MekhyW/PLFM_RADAR/4_Schematics and Boards Layout/4_7_Production Files/Gerber_PowerBoard/BOM_Power_Board.xlsx

Qty | Value | Device | Package | Parts | Description | MANUFACTURER_PART_NUMBER
1 |  | AK300/2 | AK300/2 | X1 | CONNECTOR | AK300/2
1 |  | MA10-2 | MA10-2 | SV1 | PIN HEADER | MA10-2
21 | 0.1µF | C-EUC0805 | C0805 | C1, C6, C12, C18, C29, C30, C36, C42, C54, C60, C66, C71, C76, C77, C83, C89, C109, C119, C129, C144, C154 | CAPACITOR, European symbol | GCM21BR71E104JA37L (https://eu.mouser.com/ProductDetail/Murata-Electronics/GCM21BR71E104JA37L?qs=ui%252B2d9lVEI7OYh7A7OY47Q%3D%3D)
27 | 10k | R-EU_M0805 | M0805 | R2, R4, R6, R8, R10, R12, R14, R16, R18, R20, R22, R24, R26, R28, R30, R32, R34, R36, R38, R40, R42, R44, R46, R48, R50, R52, R56 | RESISTOR, European symbol | AE0805BR-0710KL (https://eu.mouser.com/ProductDetail/YAGEO/AE0805BR-0710KL?qs=HMhDvBYWqvNWZaFpSGlhYw%3D%3D)
4 | 10nF | C-EUC0603 | C0603 | C150, C152, C160, C162 | CAPACITOR, European symbol | 06035D103JAT2A (https://eu.mouser.com/ProductDetail/KYOCERA-AVX/06035D103JAT2A?qs=55YtniHzbhDXOi8Vip1enw%3D%3D)
4 | 10µF | C-EUC0603 | C0603 | C151, C153, C161, C163 | CAPACITOR, European symbol | ZRB18AR6YA106ME01L (https://eu.mouser.com/ProductDetail/Murata-Electronics/ZRB18AR6YA106ME01L?qs=HoCaDK9Nz5eXg14MFgF2fw%3D%3D)
60 | 10µF | C-EUC0805 | C0805 | C4, C5, C9, C10, C15, C16, C21, C22, C24, C25, C28, C33, C34, C39, C40, C45, C46, C50, C51, C52, C53, C57, C58, C63, C64, C69, C70, C74, C75, C80, C81, C86, C87, C92, C93, C94, C95, C108, C112, C113, C114, C115, C118, C122, C123, C124, C125, C128, C132, C133, C134, C135, C138, C139, C140, C143, C147, C148, C157, C158 | CAPACITOR, European symbol | CC0805KFX5R8BB106 (https://eu.mouser.com/ProductDetail/YAGEO/CC0805KFX5R8BB106?qs=mzRxyRlhVduJfxImRDJQ%2FQ%3D%3D)
2 | 11.5k | R-EU_M0805 | M0805 | R54, R58 | RESISTOR, European symbol | CRCW080511K5FKTA (https://eu.mouser.com/ProductDetail/Vishay/CRCW080511K5FKTA?qs=tnDSmmR1oWgs354ZXqAXNQ%3D%3D)
4 | 12k | R-EU_M0805 | M0805 | R9, R35, R43, R47 | RESISTOR, European symbol | KTR10EZPF1202 (https://eu.mouser.com/ProductDetail/ROHM-Semiconductor/KTR10EZPF1202?qs=493kPxzlxfLm5xyfyaG22Q%3D%3D)
1 | 13.7k | R-EU_M0805 | M0805 | R3 | RESISTOR, European symbol | ESR10EZPF1372 (https://eu.mouser.com/ProductDetail/ROHM-Semiconductor/ESR10EZPF1372?qs=493kPxzlxfKltSq0m%2FX8Jg%3D%3D)
12 | 1µF | C-EUC0805 | C0805 | C26, C27, C106, C107, C116, C117, C126, C127, C136, C137, C141, C142 | CAPACITOR, European symbol | MSAYG21GSLD105KTNA01 (https://eu.mouser.com/ProductDetail/TAIYO-YUDEN/MSAYG21GSLD105KTNA01?qs=tlsG%2FOw5FFjivBHbIoLkxA%3D%3D)
2 | 2.2µH | POWER_INDUCTOR | IND_VLP8040T-1R0N_TDK | U$1, U$2 |  | DEM8045Z-2R2N=P3 (https://eu.mouser.com/ProductDetail/Murata-Electronics/DEM8045Z-2R2N%3dP3?qs=d0WKAl%252BL4KZ0uPLVslJ79g%3D%3D)
35 | 22-23-2021 | 22-23-2021 | 22-23-2021 | X2, X3, X4, X5, X6, X7, X8, X9, X10, X11, X12, X13, X14, X15, X16, X17, X18, X19, X20, X21, X22, X23, X24, X25, X26, X27, X28, X29, X30, X31, X32, X33, X34, X35, X36 | .100 (2.54mm) Center Header - 2 Pin" | 22-23-2021
52 | 22µF | C-EUC0603 | C0603 | C2, C3, C7, C8, C11, C13, C14, C17, C19, C20, C23, C31, C32, C35, C37, C38, C41, C43, C44, C47, C48, C49, C55, C56, C59, C61, C62, C65, C67, C68, C72, C73, C78, C79, C82, C84, C85, C88, C90, C91, C110, C111, C120, C121, C130, C131, C145, C146, C149, C155, C156, C159 | CAPACITOR, European symbol | KGM15CR51E226MT (https://eu.mouser.com/ProductDetail/KYOCERA-AVX/KGM15CR51E226MT?qs=wT7LY0lnAe2Bb%252BluevEM%252Bg%3D%3D)
1 | 23.4k | R-EU_M0805 | M0805 | R49 | RESISTOR, European symbol | RK73H2ATTD2372F (https://eu.mouser.com/ProductDetail/KOA-Speer/RK73H2ATTD2372F?qs=PMDQ8V2gf3A6mpnfapEXEA%3D%3D) | 23.7k
1 | 2k | R-EU_M0805 | M0805 | R39 | RESISTOR, European symbol | ERJ-P06D2001V (https://eu.mouser.com/ProductDetail/Panasonic/ERJ-P06D2001V?qs=sWbhZyXmMVevNgsEVw3FiQ%3D%3D)
1 | 3.09k | R-EU_M0805 | M0805 | R1 | RESISTOR, European symbol | ERJ-P06F3091V (https://eu.mouser.com/ProductDetail/Panasonic/ERJ-P06F3091V?qs=iIVTEDlrHA1xWd79nvuCpw%3D%3D)
19 | 3.3µH | POWER_INDUCTOR | IND_VLP8040T-1R0N_TDK | U$3, U$4, U$5, U$6, U$7, U$8, U$9, U$10, U$11, U$12, U$13, U$14, U$15, U$16, U$17, U$18, U$19, U$20, U$21 |  | DEM8045Z-3R3N=P3 (https://eu.mouser.com/ProductDetail/Murata-Electronics/DEM8045Z-3R3N%3dP3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)
6 | 32.2k | R-EU_M0805 | M0805 | R5, R7, R11, R13, R15, R19 | RESISTOR, European symbol | CRCW080532K4FKEAHP (https://eu.mouser.com/ProductDetail/Vishay/CRCW080532K4FKEAHP?qs=VAB4DzKv5wVs3SRCdEXCUA%3D%3D)
1 | 34.8k | R-EU_M0805 | M0805 | R21 | RESISTOR, European symbol | ERJ-P06F3482V (https://eu.mouser.com/ProductDetail/Panasonic/ERJ-P06F3482V?qs=iIVTEDlrHA0n%252BHyJf%2FMFBA%3D%3D)
2 | 35.7k | R-EU_M0805 | M0805 | R53, R57 | RESISTOR, European symbol | ERJ-P06F3572V (https://eu.mouser.com/ProductDetail/Panasonic/ERJ-P06F3572V?qs=iIVTEDlrHA3WQEDXYtLnJw%3D%3D)
11 | 56.2k | R-EU_M0805 | M0805 | R17, R23, R25, R27, R29, R31, R37, R41, R45, R51, R55 | RESISTOR, European symbol | CRCW080556K2FKEAHP (https://eu.mouser.com/ProductDetail/Vishay/CRCW080556K2FKEAHP?qs=3t4MbaZKGHEcVZsLnu7qDw%3D%3D)
1 | 61.9k | R-EU_M0805 | M0805 | R33 | RESISTOR, European symbol | CRCW080561K9FKEA (https://eu.mouser.com/ProductDetail/Vishay/CRCW080561K9FKEA?qs=EhwKGB4UJfnlGimrUbQTIQ%3D%3D)
6 | ADM7151ACPZ-04-R7 | ADM7151ACPZ-04-R7 | CP_8_11_ADI | U5, U23, U25, U27, U29, U30 |  | ADM7151ACPZ-04-R7
5 | LM2662MX/NOPB | LM2662MX/NOPB | M08A | U18, U19, U20, U21, U22 |  | LM2662MX/NOPB
10 | T521W476M020ATE045 | T521W476M020ATE045 | T521W | C96, C97, C98, C99, C100, C101, C102, C103, C104, C105 | T521, Tantalum, Polymer Tantalum, Commercial Grade, 47 uF, 20%, 20 VDC, 105C, -55C, 105C, SMD, Polymer, Molded, Low Profile/ESR, NonCombustible, 2,000 Hrs, 9 % , 45 mOhms, 94 uA, 222.95 mg, 7343, 1.4mm, Height Max = 1.5mm, 1000, 52 Weeks | T521W476M020ATE045
21 | TPS562208DDCT | TPS562208DDCT | DDC0006A_N | U1, U2, U3, U4, U6, U7, U8, U9, U10, U11, U12, U13, U14, U15, U16, U17, U24, U26, U28, U31, U33 |  | TPS562208DDCT
2 | TPS7A8300RGRR | TPS7A8300RGRR | RGR20_2P05X2P05_TEX | U32, U34 |  | TPS7A8300RGRR
