MekhyW/PLFM_RADAR/4_Schematics and Boards Layout/4_6_Schematics/PowerBoard/PowerBoard KiCad/PowerBoard.kicad_pcb

## KiCad design 4_Schematics and Boards Layout/4_6_Schematics/PowerBoard/PowerBoard KiCad/PowerBoard.kicad_pcb (2026-05-20)

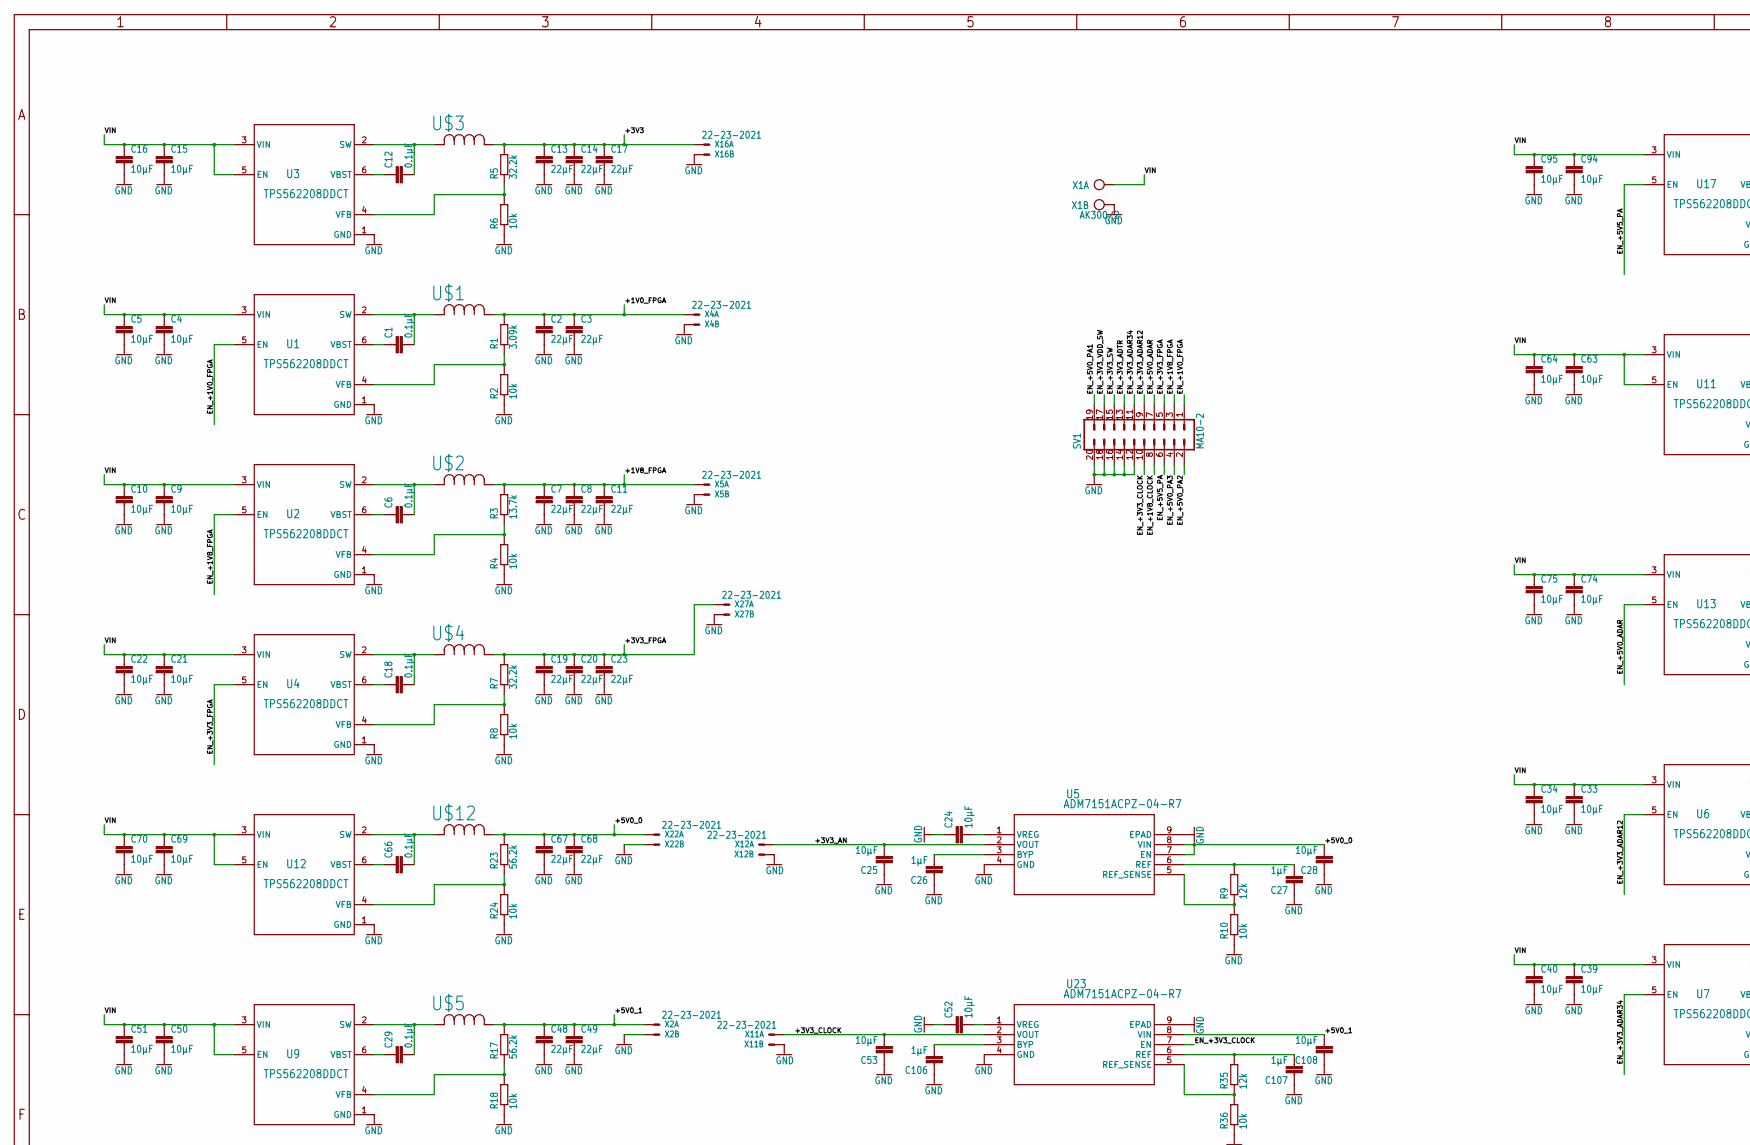
[picture p3: schematic PowerBoard.kicad_sch, part in row 1, column 1]

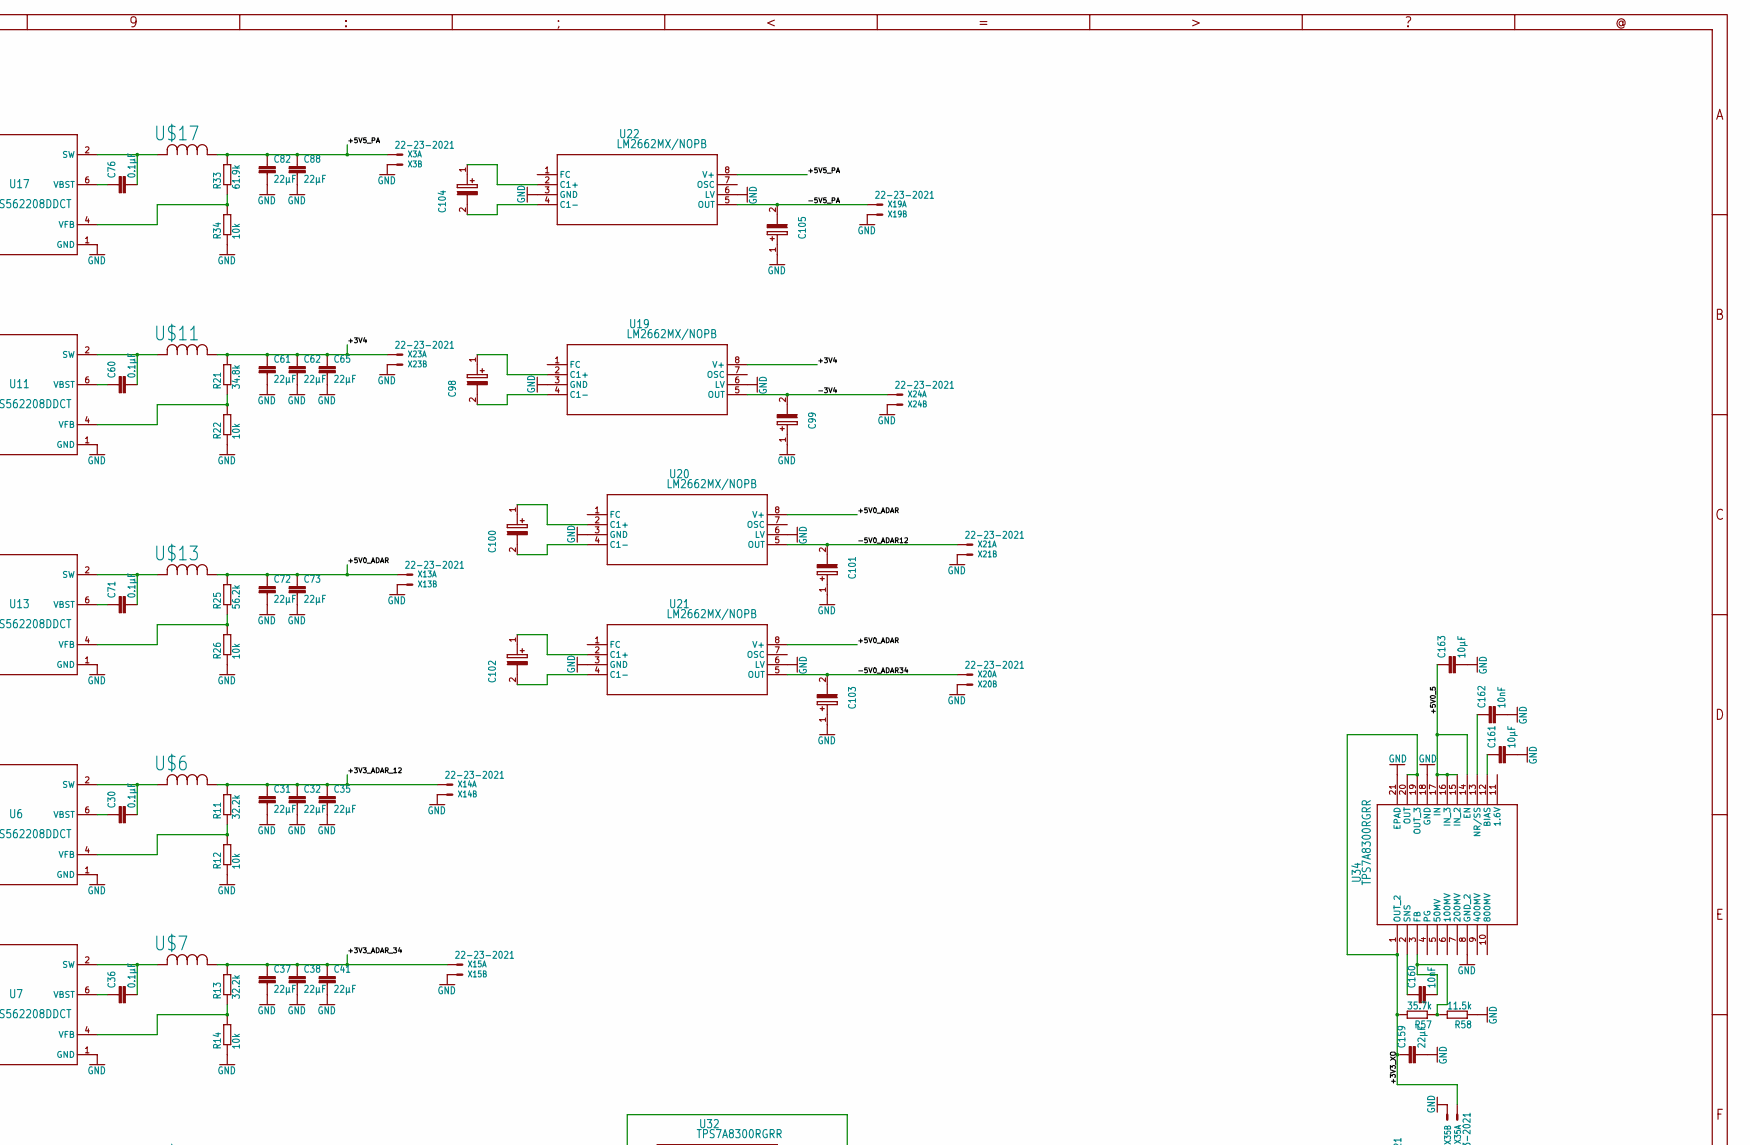
[picture p4: schematic PowerBoard.kicad_sch, part in row 1, column 2]

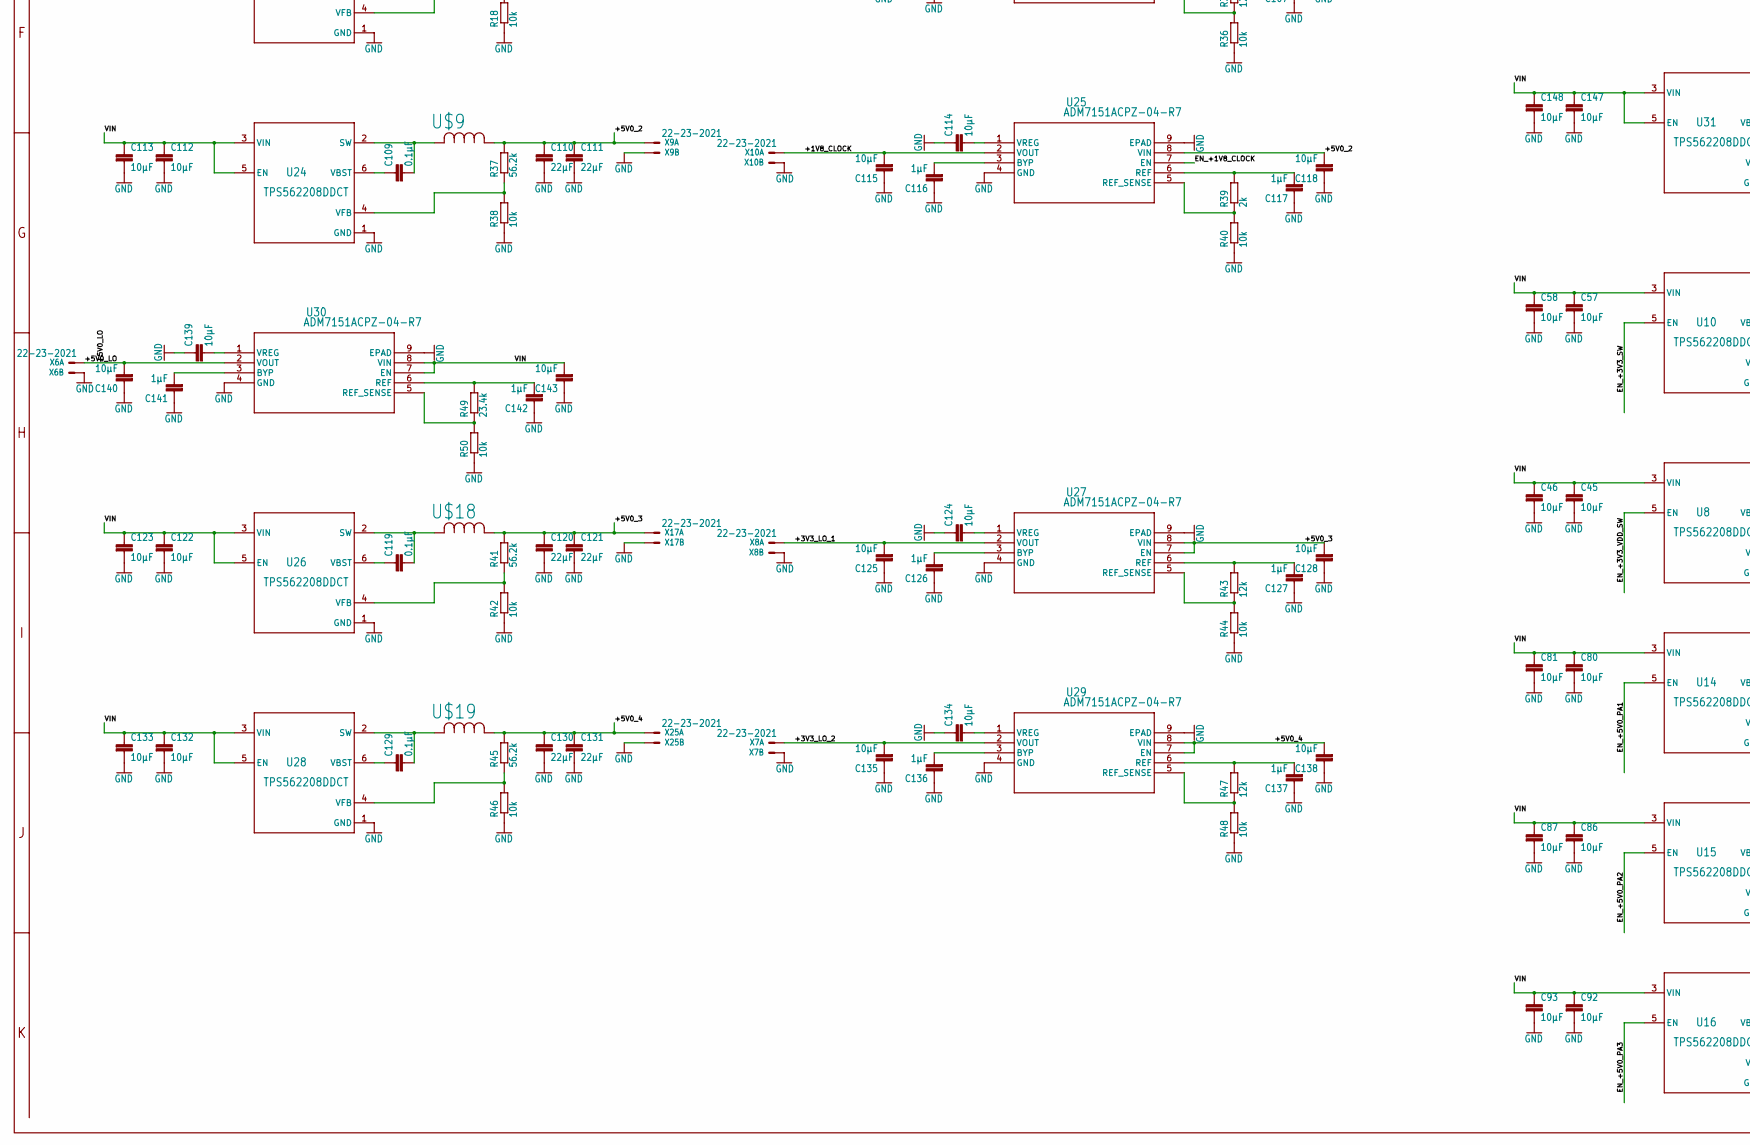
[picture p5: schematic PowerBoard.kicad_sch, part in row 2, column 1]

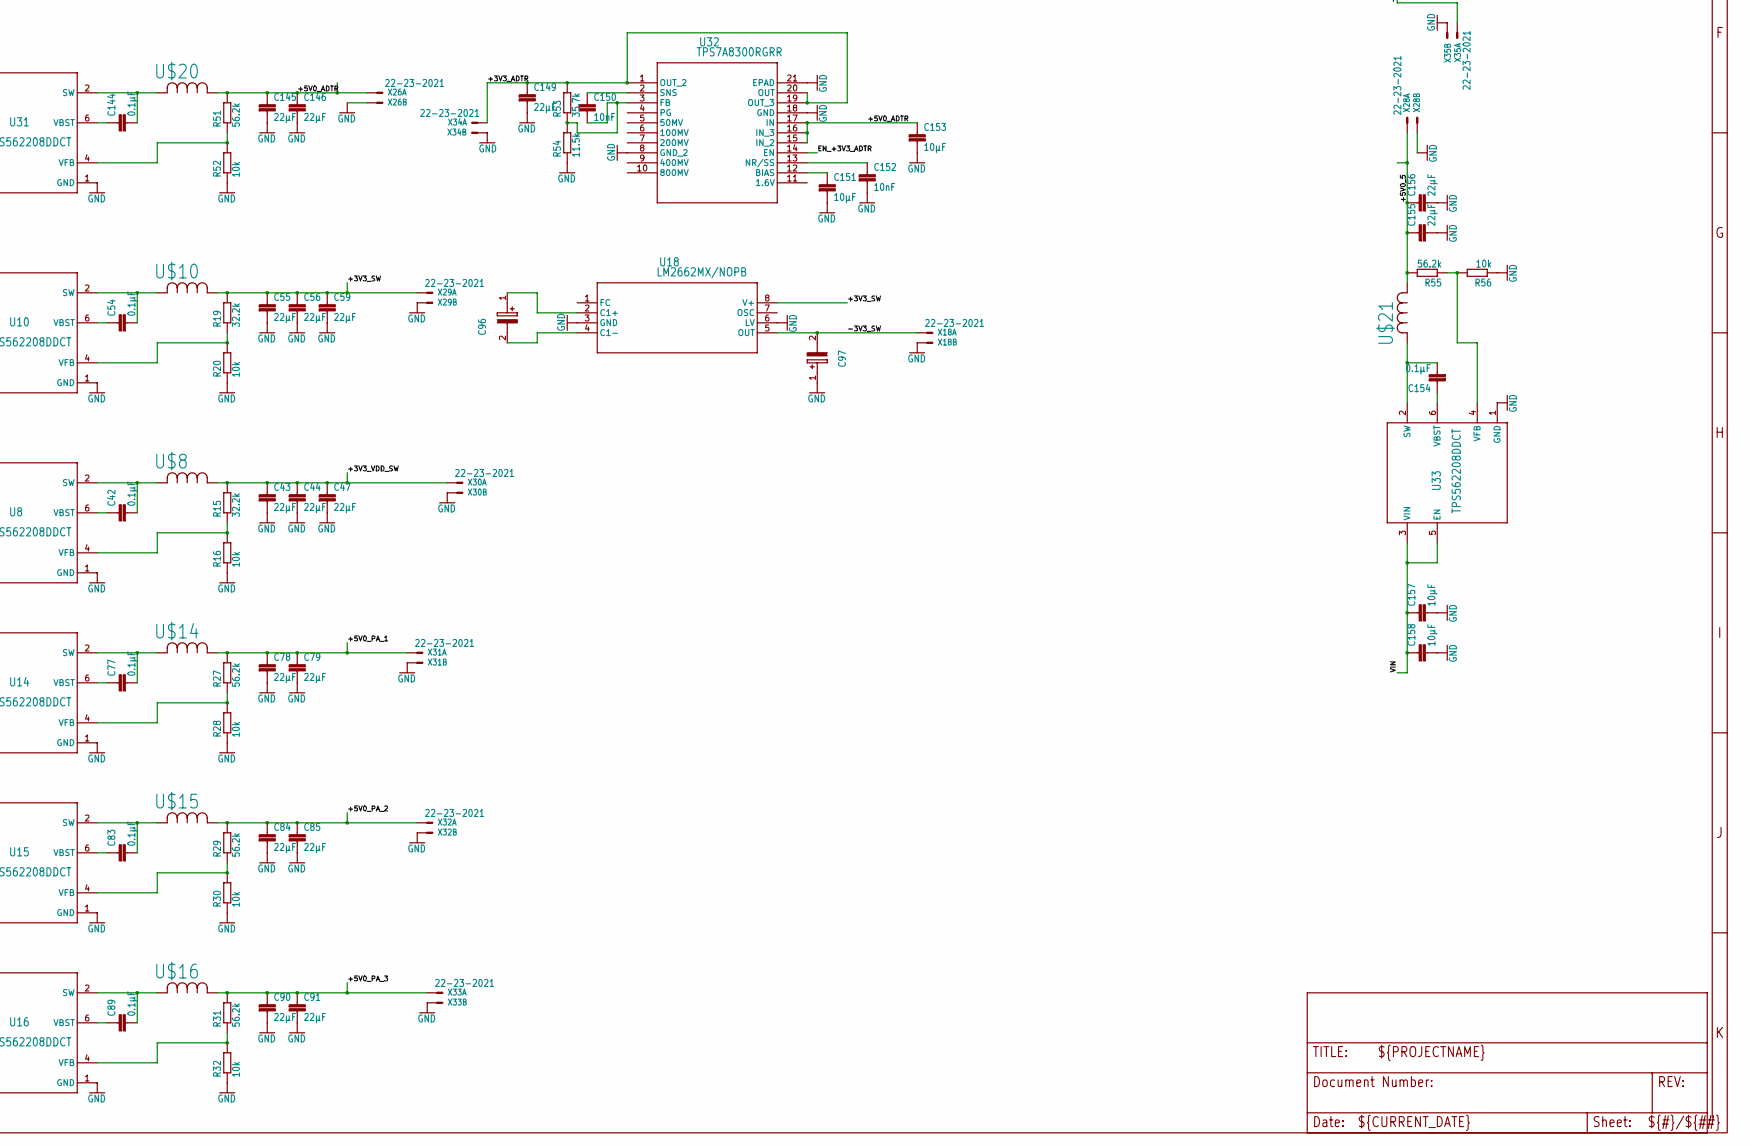
[picture p6: schematic PowerBoard.kicad_sch, part in row 2, column 2]

Parts:
C1, C6, C12, C18, C29, C30, C36, C42, C54, C60, C66, C71, C76, C77, C83, C89, C109, C119, C129, C144, C154: 0.1µF; C0805
C2, C3, C7, C8, C11, C13, C14, C17, C19, C20, C23, C31, C32, C35, C37, C38, C41, C43, C44, C47, C48, C49, C55, C56, C59, C61, C62, C65, C67, C68, C72, C73, C78, C79, C82, C84, C85, C88, C90, C91, C110, C111, C120, C121, C130, C131, C145, C146, C149, C155, C156, C159: 22µF; C0603
C4, C5, C9, C10, C15, C16, C21, C22, C24, C25, C28, C33, C34, C39, C40, C45, C46, C50, C51, C52, C53, C57, C58, C63, C64, C69, C70, C74, C75, C80, C81, C86, C87, C92, C93, C94, C95, C108, C112, C113, C114, C115, C118, C122, C123, C124, C125, C128, C132, C133, C134, C135, C138, C139, C140, C143, C147, C148, C157, C158: 10µF; C0805
C26, C27, C106, C107, C116, C117, C126, C127, C136, C137, C141, C142: 1µF; C0805
C96, C97, C98, C99, C100, C101, C102, C103, C104, C105: T521W476M020ATE045; T521W
C150, C152, C160, C162: 10nF; C0603
C151, C153, C161, C163: 10µF; C0603
R1: 3.09k; M0805
R2, R4, R6, R8, R10, R12, R14, R16, R18, R20, R22, R24, R26, R28, R30, R32, R34, R36, R38, R40, R42, R44, R46, R48, R50, R52, R56: 10k; M0805
R3: 13.7k; M0805
R5, R7, R11, R13, R15, R19: 32.2k; M0805
R9, R35, R43, R47: 12k; M0805
R17, R23, R25, R27, R29, R31, R37, R41, R45, R51, R55: 56.2k; M0805
R21: 34.8k; M0805
R33: 61.9k; M0805
R39: 2k; M0805
R49: 23.4k; M0805
R53, R57: 35.7k; M0805
R54, R58: 11.5k; M0805
SV1: MA10-2
U1, U2, U3, U4, U6, U7, U8, U9, U10, U11, U12, U13, U14, U15, U16, U17, U24, U26, U28, U31, U33: TPS562208DDCT; DDC0006A_N
U5, U23, U25, U27, U29, U30: ADM7151ACPZ-04-R7; CP_8_11_ADI
U18, U19, U20, U21, U22: LM2662MX/NOPB; M08A
U32, U34: TPS7A8300RGRR; RGR20_2P05X2P05_TEX
U$1, U$2: 2.2µH; IND_VLP8040T-1R0N_TDK
U$3, U$4, U$5, U$6, U$7, U$8, U$9, U$10, U$11, U$12, U$13, U$14, U$15, U$16, U$17, U$18, U$19, U$20, U$21: 3.3µH; IND_VLP8040T-1R0N_TDK
X1: AK300/2; AK300_2
X2, X3, X4, X5, X6, X7, X8, X9, X10, X11, X12, X13, X14, X15, X16, X17, X18, X19, X20, X21, X22, X23, X24, X25, X26, X27, X28, X29, X30, X31, X32, X33, X34, X35: 22-23-2021

Connections:
+1V0_FPGA: C2.1, C3.1, R1.2, U$1.1, X4.1
+1V8_CLOCK: C115.2, U25.2 (VOUT), X10.1
+1V8_FPGA: C7.1, C8.1, C11.1, R3.2, U$2.1, X5.1
+3V3: C13.1, C14.1, C17.1, R5.2, U$3.1, X16.1
+3V3_ADAR_12: C31.1, C32.1, C35.1, R11.2, U$6.1, X14.1
+3V3_ADAR_34: C37.1, C38.1, C41.1, R13.2, U$7.1, X15.1
+3V3_ADTR: C149.1, R53.2, U32.1 (OUT_2), U32.19 (OUT_3), U32.20 (OUT), X34.1
+3V3_AN: C25.2, U5.2 (VOUT), X12.1
+3V3_CLOCK: C53.2, U23.2 (VOUT), X11.1
+3V3_FPGA: C19.1, C20.1, C23.1, R7.2, U$4.1, X27.1
+3V3_LO_1: C125.2, U27.2 (VOUT), X8.1
+3V3_LO_2: C135.2, U29.2 (VOUT), X7.1
+3V3_SW: C55.1, C56.1, C59.1, R19.2, U18.8 (V+), U$10.1, X29.1
+3V3_VDD_SW: C43.1, C44.1, C47.1, R15.2, U$8.1, X30.1
+3V3_XO: C159.1, R57.2, U34.1 (OUT_2), U34.19 (OUT_3), U34.20 (OUT), X35.1
+3V4: C61.1, C62.1, C65.1, R21.2, U19.8 (V+), U$11.1, X23.1
+5V0_0: C28.2, C67.1, C68.1, R23.2, U5.7 (EN), U5.8 (VIN), U$12.1, X22.1
+5V0_1: C48.1, C49.1, C108.2, R17.2, U23.8 (VIN), U$5.1, X2.1
+5V0_2: C110.1, C111.1, C118.2, R37.2, U25.8 (VIN), U$9.1, X9.1
+5V0_3: C120.1, C121.1, C128.2, R41.2, U27.7 (EN), U27.8 (VIN), U$18.1, X17.1
+5V0_4: C130.1, C131.1, C138.2, R45.2, U29.7 (EN), U29.8 (VIN), U$19.1, X25.1
+5V0_5: C155.1, C156.1, C163.1, R55.2, U34.14 (EN), U34.15 (IN_2), U34.16 (IN_3), U34.17 (IN), U$21.1, X28.1
+5V0_ADAR: C72.1, C73.1, R25.2, U20.8 (V+), U21.8 (V+), U$13.1, X13.1
+5V0_ADTR: C145.1, C146.1, C153.1, R51.2, U32.15 (IN_2), U32.16 (IN_3), U32.17 (IN), U$20.1, X26.1
+5V0_LO: C140.2, U30.2 (VOUT), X6.1; also elsewhere on the board
+5V0_PA_1: C78.1, C79.1, R27.2, U$14.1, X31.1
+5V0_PA_2: C84.1, C85.1, R29.2, U$15.1, X32.1
+5V0_PA_3: C90.1, C91.1, R31.2, U$16.1, X33.1
+5V5_PA: C82.1, C88.1, R33.2, U22.8 (V+), U$17.1, X3.1
-3V3_SW: C97.2 (-), U18.5 (OUT), X18.1
-3V4: C99.2 (-), U19.5 (OUT), X24.1
-5V0_ADAR12: C101.2 (-), U20.5 (OUT), X21.1
-5V0_ADAR34: C103.2 (-), U21.5 (OUT), X20.1
-5V5_PA: C105.2 (-), U22.5 (OUT), X19.1
EN_+1V0_FPGA: SV1.1, U1.5 (EN)
EN_+1V8_CLOCK: SV1.8, U25.7 (EN)
EN_+1V8_FPGA: SV1.3, U2.5 (EN)
EN_+3V3_ADAR12: SV1.9, U6.5 (EN)
EN_+3V3_ADAR34: SV1.11, U7.5 (EN)
EN_+3V3_ADTR: SV1.13, U32.14 (EN)
EN_+3V3_CLOCK: SV1.10, U23.7 (EN)
EN_+3V3_FPGA: SV1.5, U4.5 (EN)
EN_+3V3_SW: SV1.15, U10.5 (EN)
EN_+3V3_VDD_SW: SV1.17, U8.5 (EN)
EN_+5V0_ADAR: SV1.7, U13.5 (EN)
EN_+5V0_PA1: SV1.19, U14.5 (EN)
EN_+5V0_PA2: SV1.2, U15.5 (EN)
EN_+5V0_PA3: SV1.4, U16.5 (EN)
EN_+5V5_PA: SV1.6, U17.5 (EN)
GND: C2.2, C3.2, C4.2, C5.2, C7.2, C8.2, C9.2, C10.2, C11.2, C13.2, C14.2, C15.2, C16.2, C17.2, C19.2, C20.2, C21.2, C22.2, C23.2, C24.1, C25.1, C26.1, C27.1, C28.1, C31.2, C32.2, C33.2, C34.2, C35.2, C37.2, C38.2, C39.2, C40.2, C41.2, C43.2, C44.2, C45.2, C46.2, C47.2, C48.2, C49.2, C50.2, C51.2, C52.1, C53.1, C55.2, C56.2, C57.2, C58.2, C59.2, C61.2, C62.2, C63.2, C64.2, C65.2, C67.2, C68.2, C69.2, C70.2, C72.2, C73.2, C74.2, C75.2, C78.2, C79.2, C80.2, C81.2, C82.2, C84.2, C85.2, C86.2, C87.2, C88.2, C90.2, C91.2, C92.2, C93.2, C94.2, C95.2, C97.1 (+), C99.1 (+), C101.1 (+), C103.1 (+), C105.1 (+), C106.1, C107.1, C108.1, C110.2, C111.2, C112.2, C113.2, C114.1, C115.1, C116.1, C117.1, C118.1, C120.2, C121.2, C122.2, C123.2, C124.1, C125.1, C126.1, C127.1, C128.1, C130.2, C131.2, C132.2, C133.2, C134.1, C135.1, C136.1, C137.1, C138.1, C139.1, C140.1, C141.1, C142.1, C143.1, C145.2, C146.2, C147.2, C148.2, C149.2, C151.2, C152.2, C153.2, C155.2, C156.2, C157.2, C158.2, C159.2, C161.2, C162.2, C163.2, R2.1, R4.1, R6.1, R8.1, R10.1, R12.1, R14.1, R16.1, R18.1, R20.1, R22.1, R24.1, R26.1, R28.1, R30.1, R32.1, R34.1, R36.1, R38.1, R40.1, R42.1, R44.1, R46.1, R48.1, R50.1, R52.1, R54.1, R56.1, R58.1, SV1.12, SV1.14, SV1.16, SV1.18, SV1.20, U1.1 (GND), U2.1 (GND), U3.1 (GND), U4.1 (GND), U5.4 (GND), U5.9 (EPAD), U6.1 (GND), U7.1 (GND), U8.1 (GND), U9.1 (GND), U10.1 (GND), U11.1 (GND), U12.1 (GND), U13.1 (GND), U14.1 (GND), U15.1 (GND), U16.1 (GND), U17.1 (GND), U18.3 (GND), U18.6 (LV), U19.3 (GND), U19.6 (LV), U20.3 (GND), U20.6 (LV), U21.3 (GND), U21.6 (LV), U22.3 (GND), U22.6 (LV), U23.4 (GND), U23.9 (EPAD), U24.1 (GND), U25.4 (GND), U25.9 (EPAD), U26.1 (GND), U27.4 (GND), U27.9 (EPAD), U28.1 (GND), U29.4 (GND), U29.9 (EPAD), U30.4 (GND), U30.9 (EPAD), U31.1 (GND), U32.8 (GND_2), U32.18 (GND), U32.21 (EPAD), U33.1 (GND), U34.8 (GND_2), U34.18 (GND), U34.21 (EPAD), X1.2, X2.2, X3.2, X4.2, X5.2, X6.2, X7.2, X8.2, X9.2, X10.2, X11.2, X12.2, X13.2, X14.2, X15.2, X16.2, X17.2, X18.2, X19.2, X20.2, X21.2, X22.2, X23.2, X24.2, X25.2, X26.2, X27.2, X28.2, X29.2, X30.2, X31.2, X32.2, X33.2, X34.2, X35.2; also elsewhere on the board
unnamed: C1.2, U1.2 (SW), U$1.2
unnamed: C1.1, U1.6 (VBST)
unnamed: C6.2, U2.2 (SW), U$2.2
unnamed: R1.1, R2.2, U1.4 (VFB)
unnamed: C6.1, U2.6 (VBST)
unnamed: R3.1, R4.2, U2.4 (VFB)
unnamed: C12.2, U3.2 (SW), U$3.2
unnamed: C12.1, U3.6 (VBST)
unnamed: R5.1, R6.2, U3.4 (VFB)
unnamed: C18.2, U4.2 (SW), U$4.2
unnamed: C18.1, U4.6 (VBST)
unnamed: R7.1, R8.2, U4.4 (VFB)
unnamed: C24.2, U5.1 (VREG)
unnamed: C139.2, U30.1 (VREG)
unnamed: C26.2, U5.3 (BYP)
unnamed: C30.2, U6.2 (SW), U$6.2
unnamed: C30.1, U6.6 (VBST)
unnamed: R11.1, R12.2, U6.4 (VFB)
unnamed: C36.2, U7.2 (SW), U$7.2
unnamed: C36.1, U7.6 (VBST)
unnamed: R13.1, R14.2, U7.4 (VFB)
unnamed: C42.2, U8.2 (SW), U$8.2
unnamed: C42.1, U8.6 (VBST)
unnamed: R15.1, R16.2, U8.4 (VFB)
unnamed: R9.1, R10.2, U5.5 (REF_SENSE)
unnamed: C29.2, U9.2 (SW), U$5.2
unnamed: C27.2, R9.2, U5.6 (REF)
unnamed: C54.2, U10.2 (SW), U$10.2
unnamed: C54.1, U10.6 (VBST)
unnamed: R19.1, R20.2, U10.4 (VFB)
unnamed: C60.2, U11.2 (SW), U$11.2
unnamed: C60.1, U11.6 (VBST)
unnamed: R21.1, R22.2, U11.4 (VFB)
unnamed: C66.2, U12.2 (SW), U$12.2
unnamed: C66.1, U12.6 (VBST)
unnamed: R23.1, R24.2, U12.4 (VFB)
unnamed: C71.2, U13.2 (SW), U$13.2
unnamed: C71.1, U13.6 (VBST)
unnamed: R25.1, R26.2, U13.4 (VFB)
unnamed: C77.2, U14.2 (SW), U$14.2
unnamed: C77.1, U14.6 (VBST)
unnamed: R27.1, R28.2, U14.4 (VFB)
unnamed: C83.2, U15.2 (SW), U$15.2
unnamed: C83.1, U15.6 (VBST)
unnamed: R29.1, R30.2, U15.4 (VFB)
unnamed: C89.2, U16.2 (SW), U$16.2
unnamed: C89.1, U16.6 (VBST)
unnamed: R31.1, R32.2, U16.4 (VFB)
unnamed: C76.2, U17.2 (SW), U$17.2
unnamed: C76.1, U17.6 (VBST)
unnamed: R33.1, R34.2, U17.4 (VFB)
unnamed: C98.1 (+), U19.2 (C1+)
unnamed: C98.2 (-), U19.4 (C1-)
unnamed: C96.1 (+), U18.2 (C1+)
unnamed: C96.2 (-), U18.4 (C1-)
unnamed: C100.1 (+), U20.2 (C1+)
unnamed: C100.2 (-), U20.4 (C1-)
unnamed: C102.1 (+), U21.2 (C1+)
unnamed: C102.2 (-), U21.4 (C1-)
unnamed: C104.1 (+), U22.2 (C1+)
unnamed: C104.2 (-), U22.4 (C1-)
unnamed: C141.2, U30.3 (BYP)
unnamed: R49.1, R50.2, U30.5 (REF_SENSE)
unnamed: C29.1, U9.6 (VBST)
unnamed: R17.1, R18.2, U9.4 (VFB)
unnamed: C52.2, U23.1 (VREG)
unnamed: C142.2, R49.2, U30.6 (REF)
unnamed: C106.2, U23.3 (BYP)
unnamed: R35.1, R36.2, U23.5 (REF_SENSE)
unnamed: C107.2, R35.2, U23.6 (REF)
unnamed: C144.2, U31.2 (SW), U$20.2
unnamed: C144.1, U31.6 (VBST)
unnamed: C109.2, U24.2 (SW), U$9.2
unnamed: C109.1, U24.6 (VBST)
unnamed: R37.1, R38.2, U24.4 (VFB)
unnamed: C114.2, U25.1 (VREG)
unnamed: R51.1, R52.2, U31.4 (VFB)
unnamed: C116.2, U25.3 (BYP)
unnamed: R39.1, R40.2, U25.5 (REF_SENSE)
unnamed: C117.2, R39.2, U25.6 (REF)
unnamed: C154.2, U33.2 (SW), U$21.2
unnamed: C150.1, U32.2 (SNS)
unnamed: C119.2, U26.2 (SW), U$18.2
unnamed: C119.1, U26.6 (VBST)
unnamed: R41.1, R42.2, U26.4 (VFB)
unnamed: C124.2, U27.1 (VREG)
unnamed: C154.1, U33.6 (VBST)
unnamed: C126.2, U27.3 (BYP)
unnamed: R43.1, R44.2, U27.5 (REF_SENSE)
unnamed: C127.2, R43.2, U27.6 (REF)
unnamed: C150.2, R53.1, R54.2, U32.3 (FB)
unnamed: C151.1, U32.12 (BIAS)
unnamed: C129.2, U28.2 (SW), U$19.2
unnamed: C129.1, U28.6 (VBST)
unnamed: R45.1, R46.2, U28.4 (VFB)
unnamed: C134.2, U29.1 (VREG)
unnamed: R55.1, R56.2, U33.4 (VFB)
unnamed: C136.2, U29.3 (BYP)
unnamed: R47.1, R48.2, U29.5 (REF_SENSE)
unnamed: C137.2, R47.2, U29.6 (REF)
unnamed: C152.1, U32.13 (NR/SS)
unnamed: C160.1, U34.2 (SNS)
unnamed: C160.2, R57.1, R58.2, U34.3 (FB)
unnamed: C161.1, U34.12 (BIAS)
unnamed: C162.1, U34.13 (NR/SS)
VIN: C4.1, C5.1, C9.1, C10.1, C15.1, C16.1, C21.1, C22.1, C33.1, C34.1, C39.1, C40.1, C45.1, C46.1, C50.1, C51.1, C57.1, C58.1, C63.1, C64.1, C69.1, C70.1, C74.1, C75.1, C80.1, C81.1, C86.1, C87.1, C92.1, C93.1, C94.1, C95.1, C112.1, C113.1, C122.1, C123.1, C132.1, C133.1, C143.2, C147.1, C148.1, C157.1, C158.1, U1.3 (VIN), U2.3 (VIN), U3.3 (VIN), U3.5 (EN), U4.3 (VIN), U6.3 (VIN), U7.3 (VIN), U8.3 (VIN), U9.3 (VIN), U9.5 (EN), U10.3 (VIN), U11.3 (VIN), U11.5 (EN), U12.3 (VIN), U12.5 (EN), U13.3 (VIN), U14.3 (VIN), U15.3 (VIN), U16.3 (VIN), U17.3 (VIN), U24.3 (VIN), U24.5 (EN), U26.3 (VIN), U26.5 (EN), U28.3 (VIN), U28.5 (EN), U30.7 (EN), U30.8 (VIN), U31.3 (VIN), U31.5 (EN), U33.3 (VIN), U33.5 (EN), X1.1

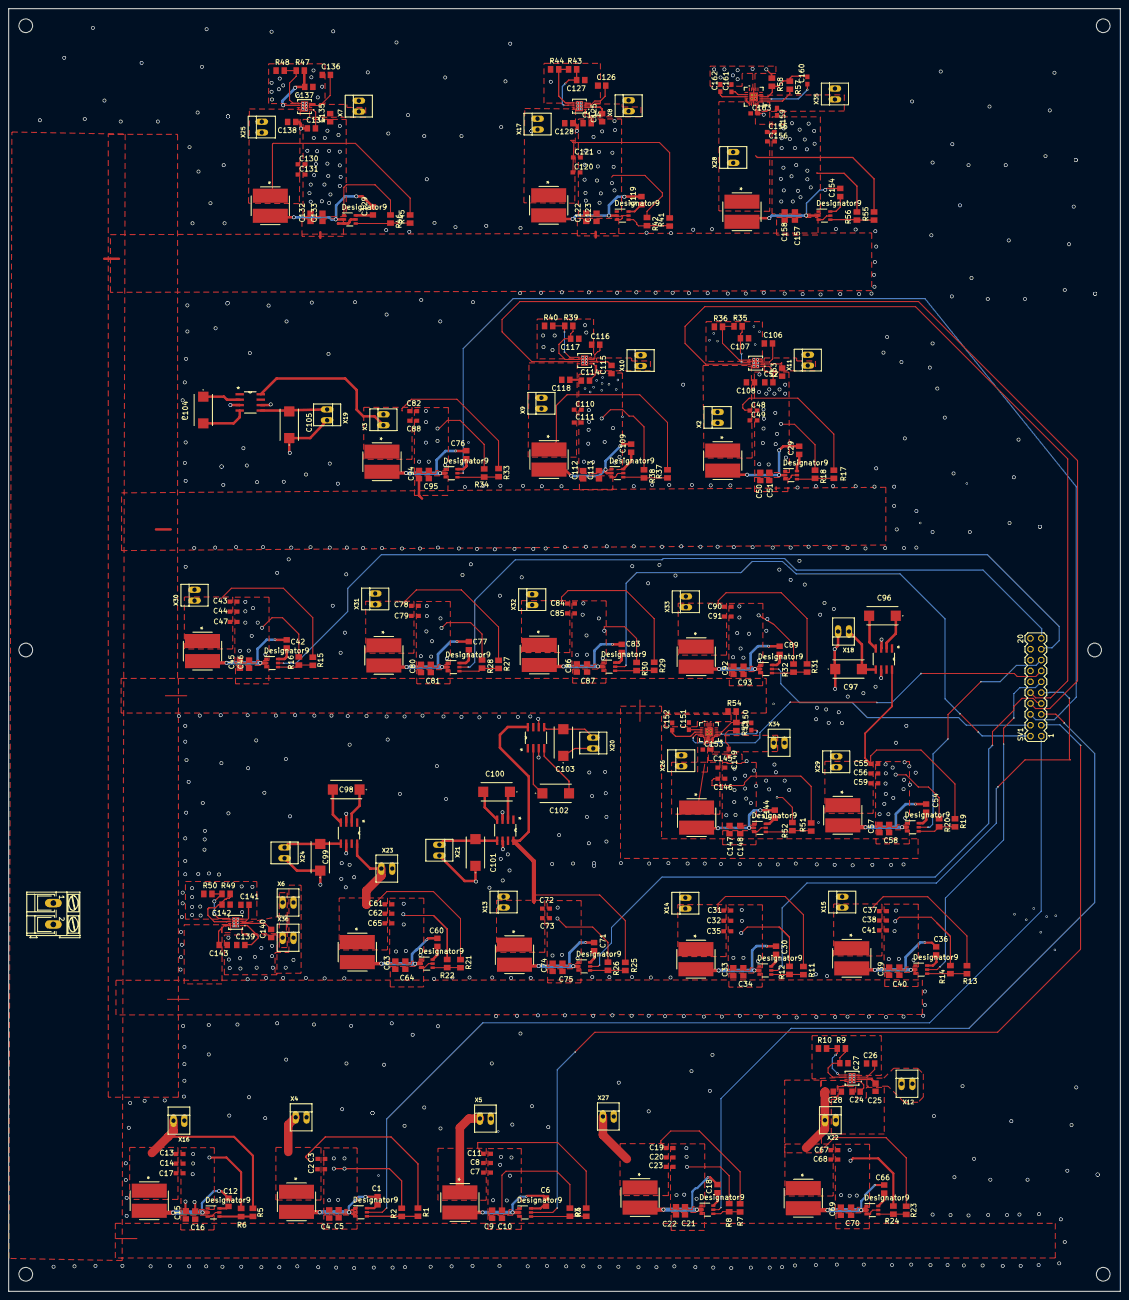
[picture p7: board PowerBoard.kicad_pcb from above]

Board: 2 copper layers, 260.0 x 300.0 mm, 319 parts (0 on the bottom side), 156 nets.

Other parts of the board:
UNK_HOLE_0: dummyfp0
UNK_HOLE_1: dummyfp1
UNK_HOLE_2: dummyfp2
UNK_HOLE_3: dummyfp3
UNK_HOLE_4: dummyfp4
UNK_HOLE_5: dummyfp5
X36: 22-23-2021

Their connections:
+5V0_LO: X36.1; also elsewhere on the board
GND: X36.2; also elsewhere on the board
