MekhyW/PLFM_RADAR/4_Schematics and Boards Layout/4_6_Schematics/MainBoard/MainBoard_KiCad/RADAR_Main_Board_1.kicad_sch

## KiCad design 4_Schematics and Boards Layout/4_6_Schematics/MainBoard/MainBoard_KiCad/RADAR_Main_Board_1.kicad_sch (2026-05-20)

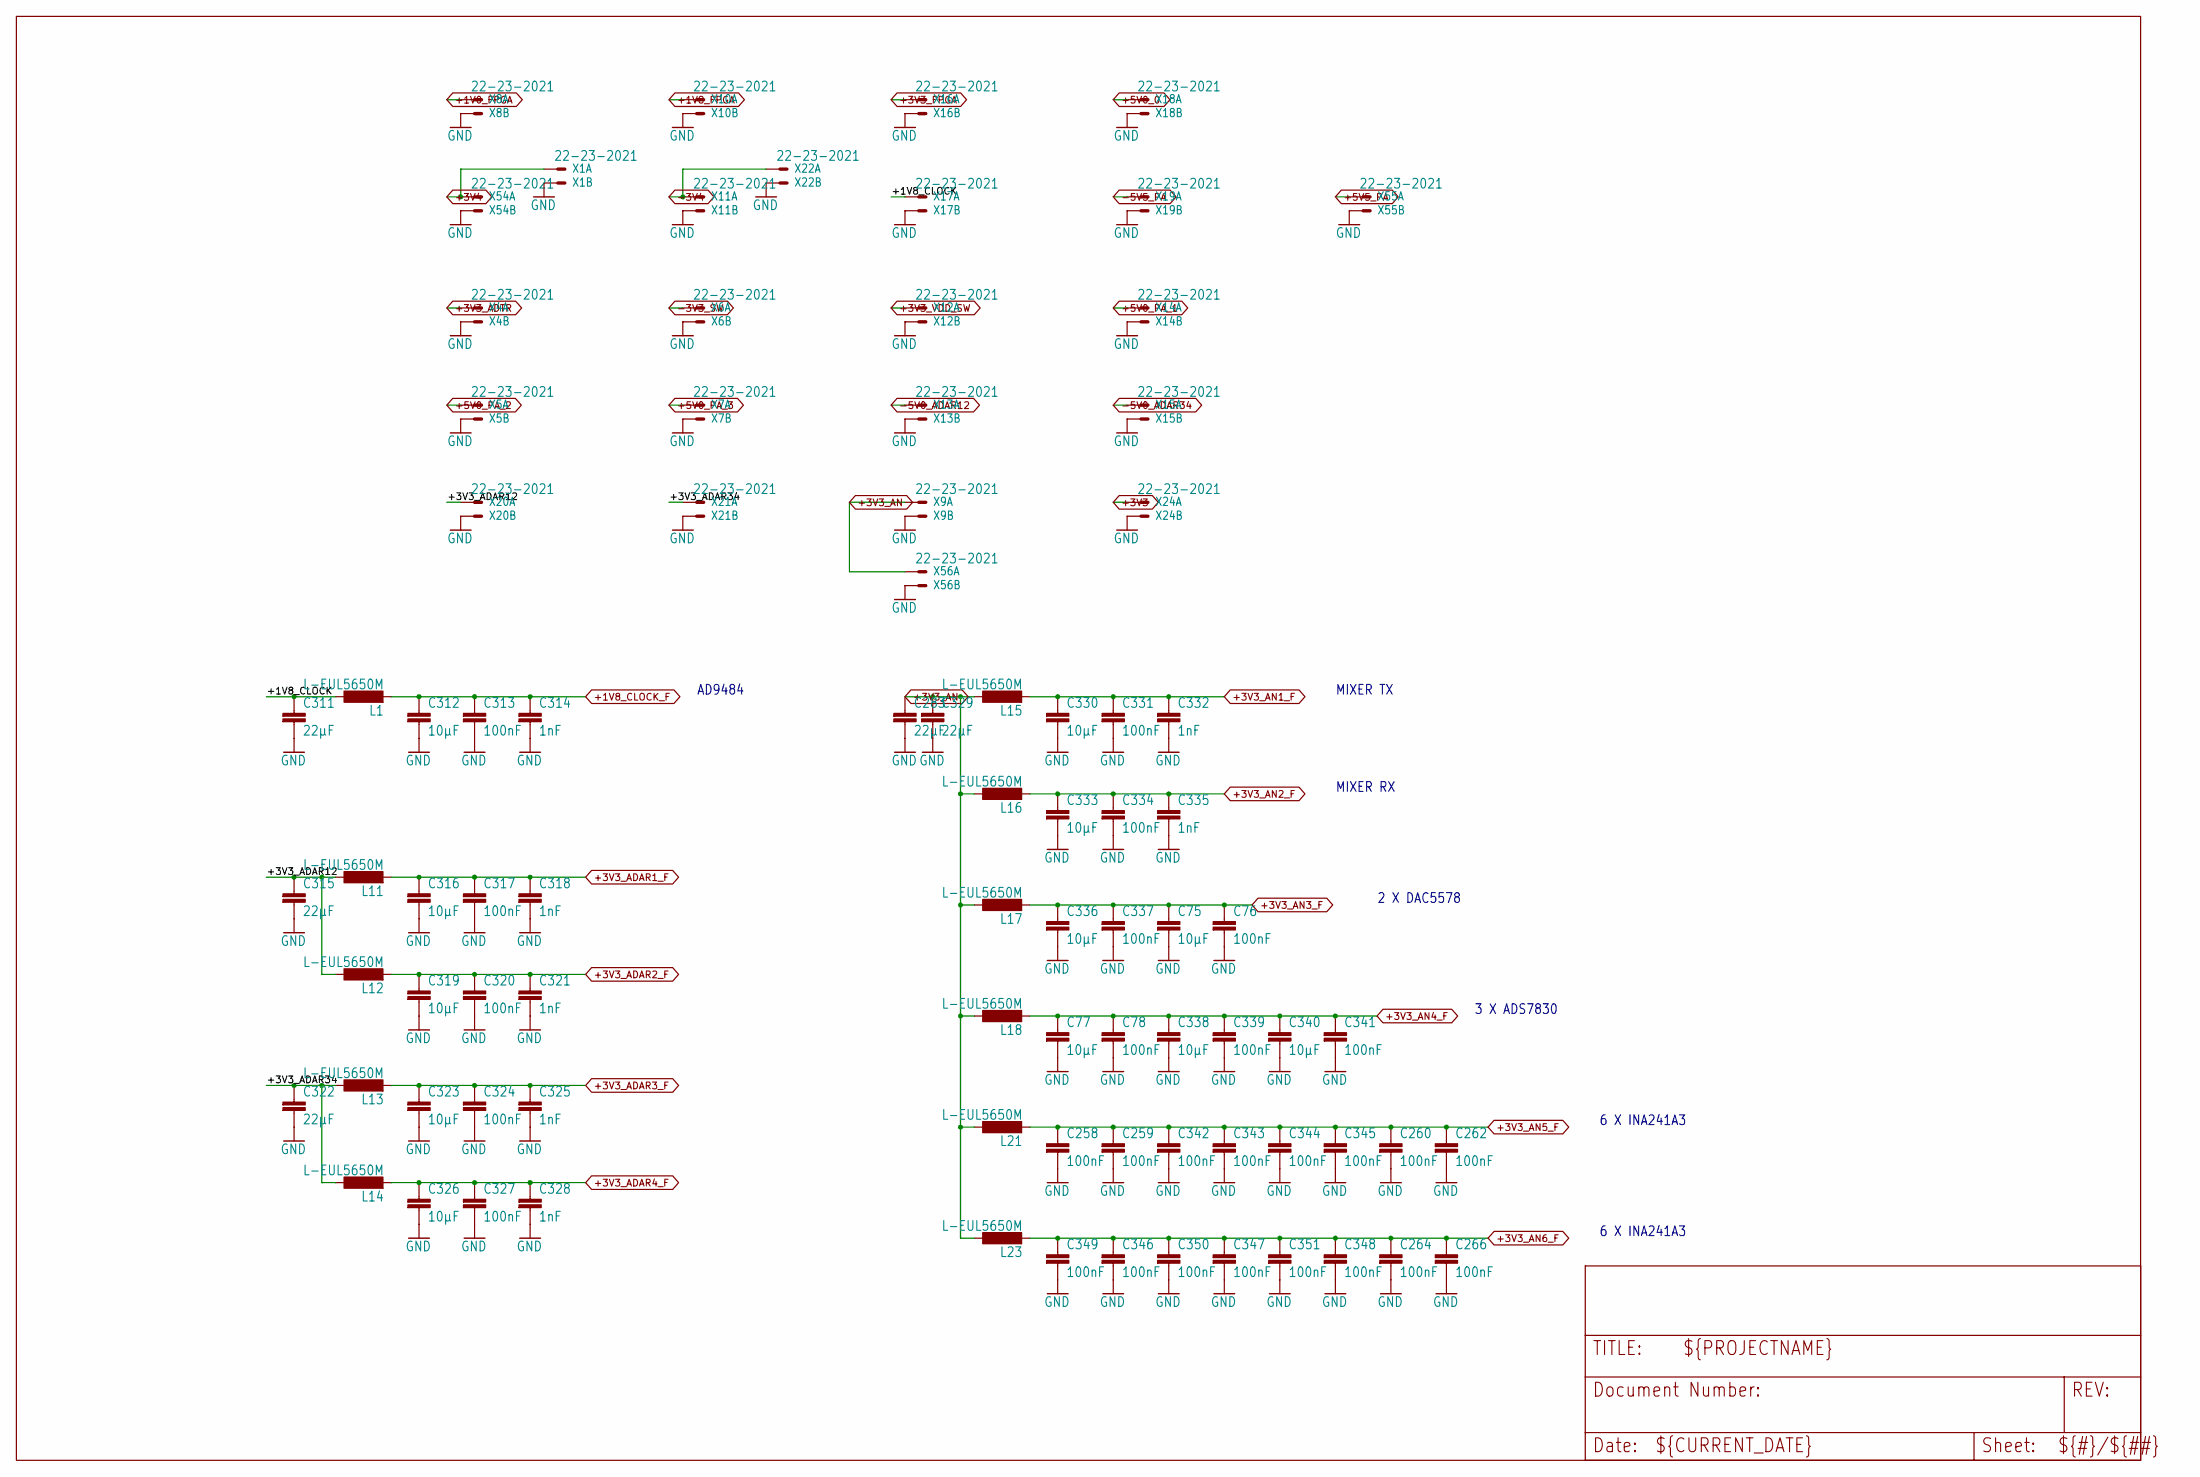
[picture p12: schematic RADAR_Main_Board_1.kicad_sch]

Parts:
C75, C77, C312, C316, C319, C323, C326, C330, C333, C336, C338, C340: 10µF; C0805
C76, C78, C258, C259, C260, C262, C264, C266, C313, C317, C320, C324, C327, C331, C334, C337, C339, C341, C342, C343, C344, C345, C346, C347, C348, C349, C350, C351: 100nF; C0402
C283, C311, C315, C322, C329: 22µF; C1206
C314, C318, C321, C325, C328, C332, C335: 1nF; C0402
L1, L11, L12, L13, L14, L15, L16, L17, L18, L21, L23: L-EUL5650M; L5650M
X1, X4, X5, X6, X7, X8, X9, X10, X11, X12, X13, X14, X15, X16, X17, X18, X19, X20, X21, X22, X24, X54, X55, X56: 22-23-2021

Connections:
+1V0_FPGA: X8.1
+1V8_CLOCK: C311.1, L1.1, X17.1
+1V8_CLOCK_F: C312.1, C313.1, C314.1, L1.2
+1V8_FPGA: X10.1
+3V3: X24.1
+3V3_ADAR1_F: C316.1, C317.1, C318.1, L11.2
+3V3_ADAR2_F: C319.1, C320.1, C321.1, L12.2
+3V3_ADAR3_F: C323.1, C324.1, C325.1, L13.2
+3V3_ADAR4_F: C326.1, C327.1, C328.1, L14.2
+3V3_ADAR12: C315.1, L11.1, L12.1, X20.1
+3V3_ADAR34: C322.1, L13.1, L14.1, X21.1
+3V3_ADTR: X4.1
+3V3_AN: C283.1, C329.1, L15.1, L16.1, L17.1, L18.1, L21.1, L23.1, X9.1, X56.1
+3V3_AN1_F: C330.1, C331.1, C332.1, L15.2
+3V3_AN2_F: C333.1, C334.1, C335.1, L16.2
+3V3_AN3_F: C75.1, C76.1, C336.1, C337.1, L17.2
+3V3_AN4_F: C77.1, C78.1, C338.1, C339.1, C340.1, C341.1, L18.2
+3V3_AN5_F: C258.1, C259.1, C260.1, C262.1, C342.1, C343.1, C344.1, C345.1, L21.2
+3V3_AN6_F: C264.1, C266.1, C346.1, C347.1, C348.1, C349.1, C350.1, C351.1, L23.2
+3V3_FPGA: X16.1
+3V3_VDD_SW: X12.1
+3V4: X1.1, X54.1
+5V0_0: X18.1
+5V0_PA_1: X14.1
+5V0_PA_2: X5.1
+5V0_PA_3: X7.1
+5V5_PA: X55.1
-3V3_SW: X6.1
-3V4: X11.1, X22.1
-5V0_ADAR12: X13.1
-5V0_ADAR34: X15.1
-5V5_PA: X19.1
GND: C75.2, C76.2, C77.2, C78.2, C258.2, C259.2, C260.2, C262.2, C264.2, C266.2, C283.2, C311.2, C312.2, C313.2, C314.2, C315.2, C316.2, C317.2, C318.2, C319.2, C320.2, C321.2, C322.2, C323.2, C324.2, C325.2, C326.2, C327.2, C328.2, C329.2, C330.2, C331.2, C332.2, C333.2, C334.2, C335.2, C336.2, C337.2, C338.2, C339.2, C340.2, C341.2, C342.2, C343.2, C344.2, C345.2, C346.2, C347.2, C348.2, C349.2, C350.2, C351.2, X1.2, X4.2, X5.2, X6.2, X7.2, X8.2, X9.2, X10.2, X11.2, X12.2, X13.2, X14.2, X15.2, X16.2, X17.2, X18.2, X19.2, X20.2, X21.2, X22.2, X24.2, X54.2, X55.2, X56.2

Notes on the sheet:
3 X ADS7830
AD9484
MIXER RX
6 X INA241A3
2 X DAC5578
MIXER TX
