MekhyW/PLFM_RADAR/4_Schematics and Boards Layout/4_6_Schematics/MainBoard/MainBoard_KiCad/RADAR_Main_Board_2.kicad_sch

## KiCad design 4_Schematics and Boards Layout/4_6_Schematics/MainBoard/MainBoard_KiCad/RADAR_Main_Board_2.kicad_sch (2026-05-20)

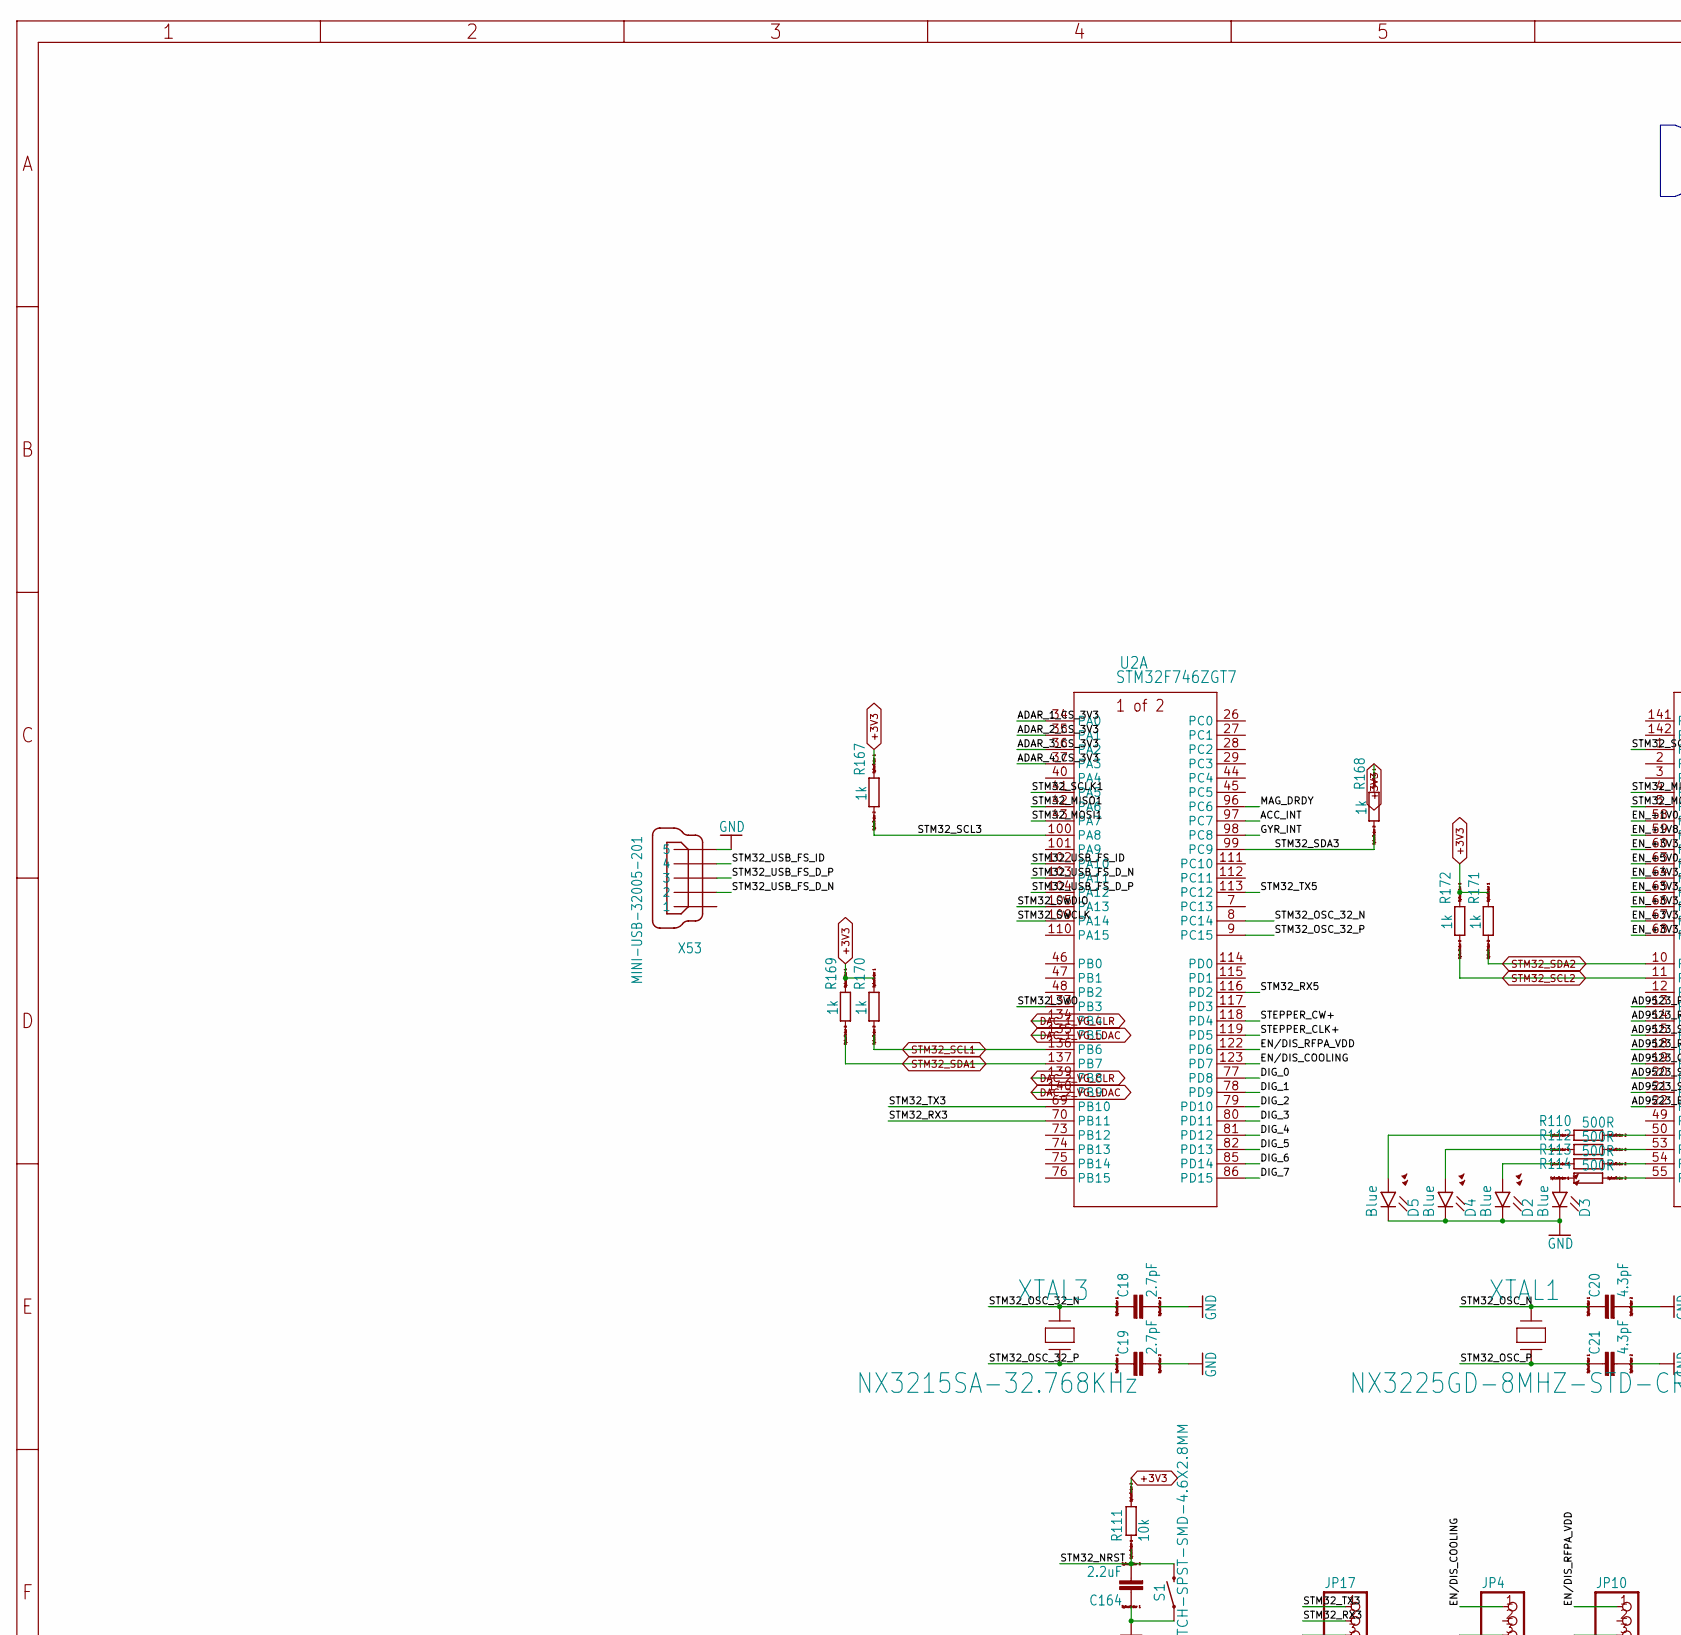
[picture p13: schematic RADAR_Main_Board_2.kicad_sch, part in row 1, column 1]

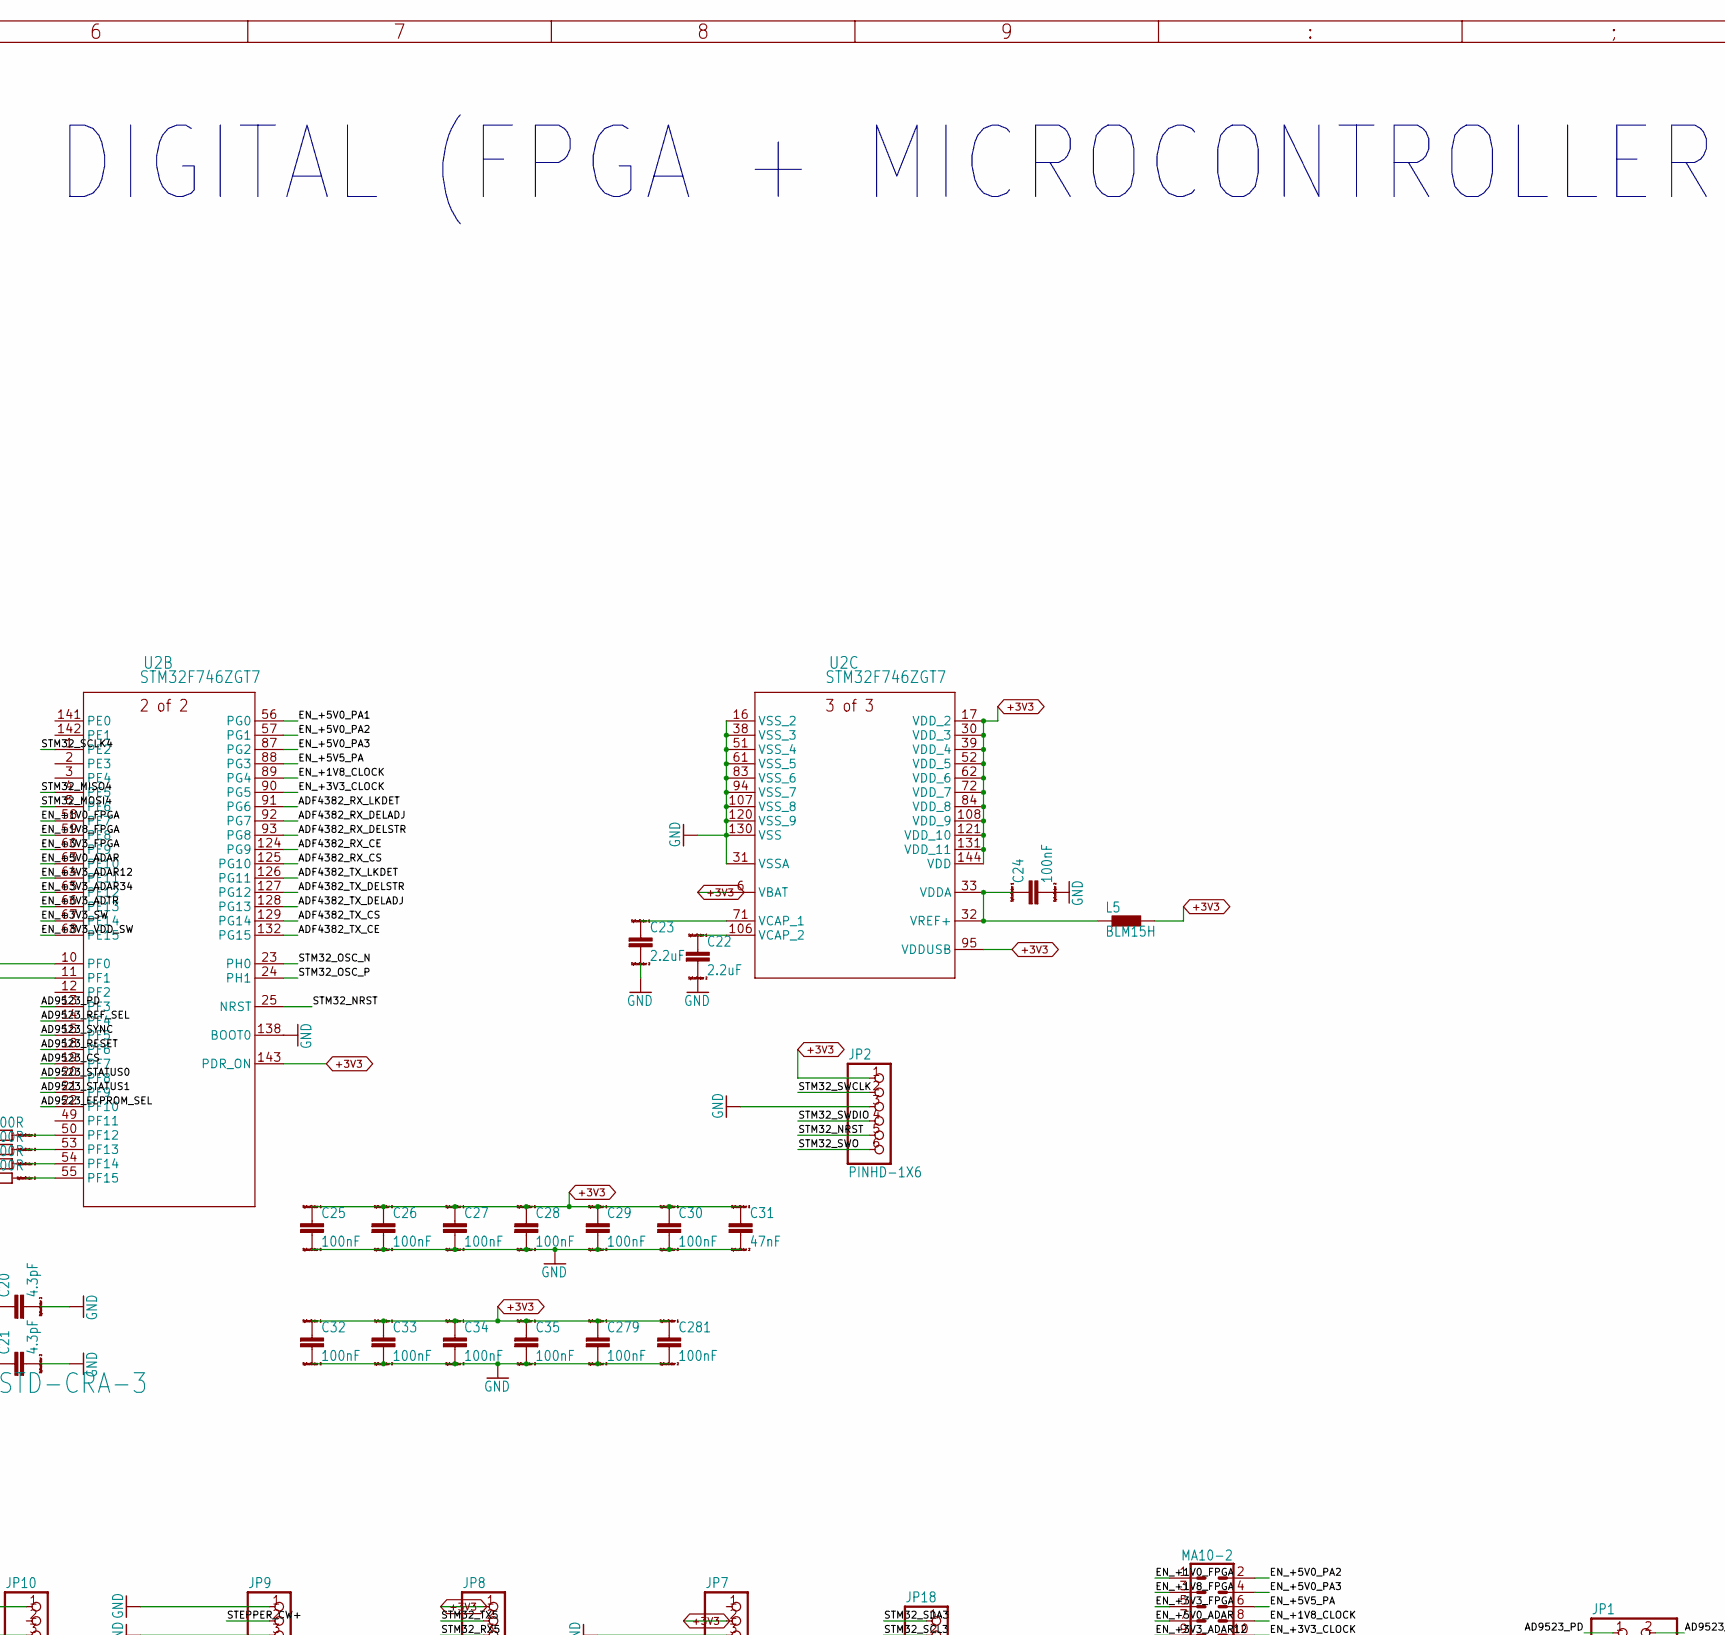
[picture p14: schematic RADAR_Main_Board_2.kicad_sch, part in row 1, column 2]

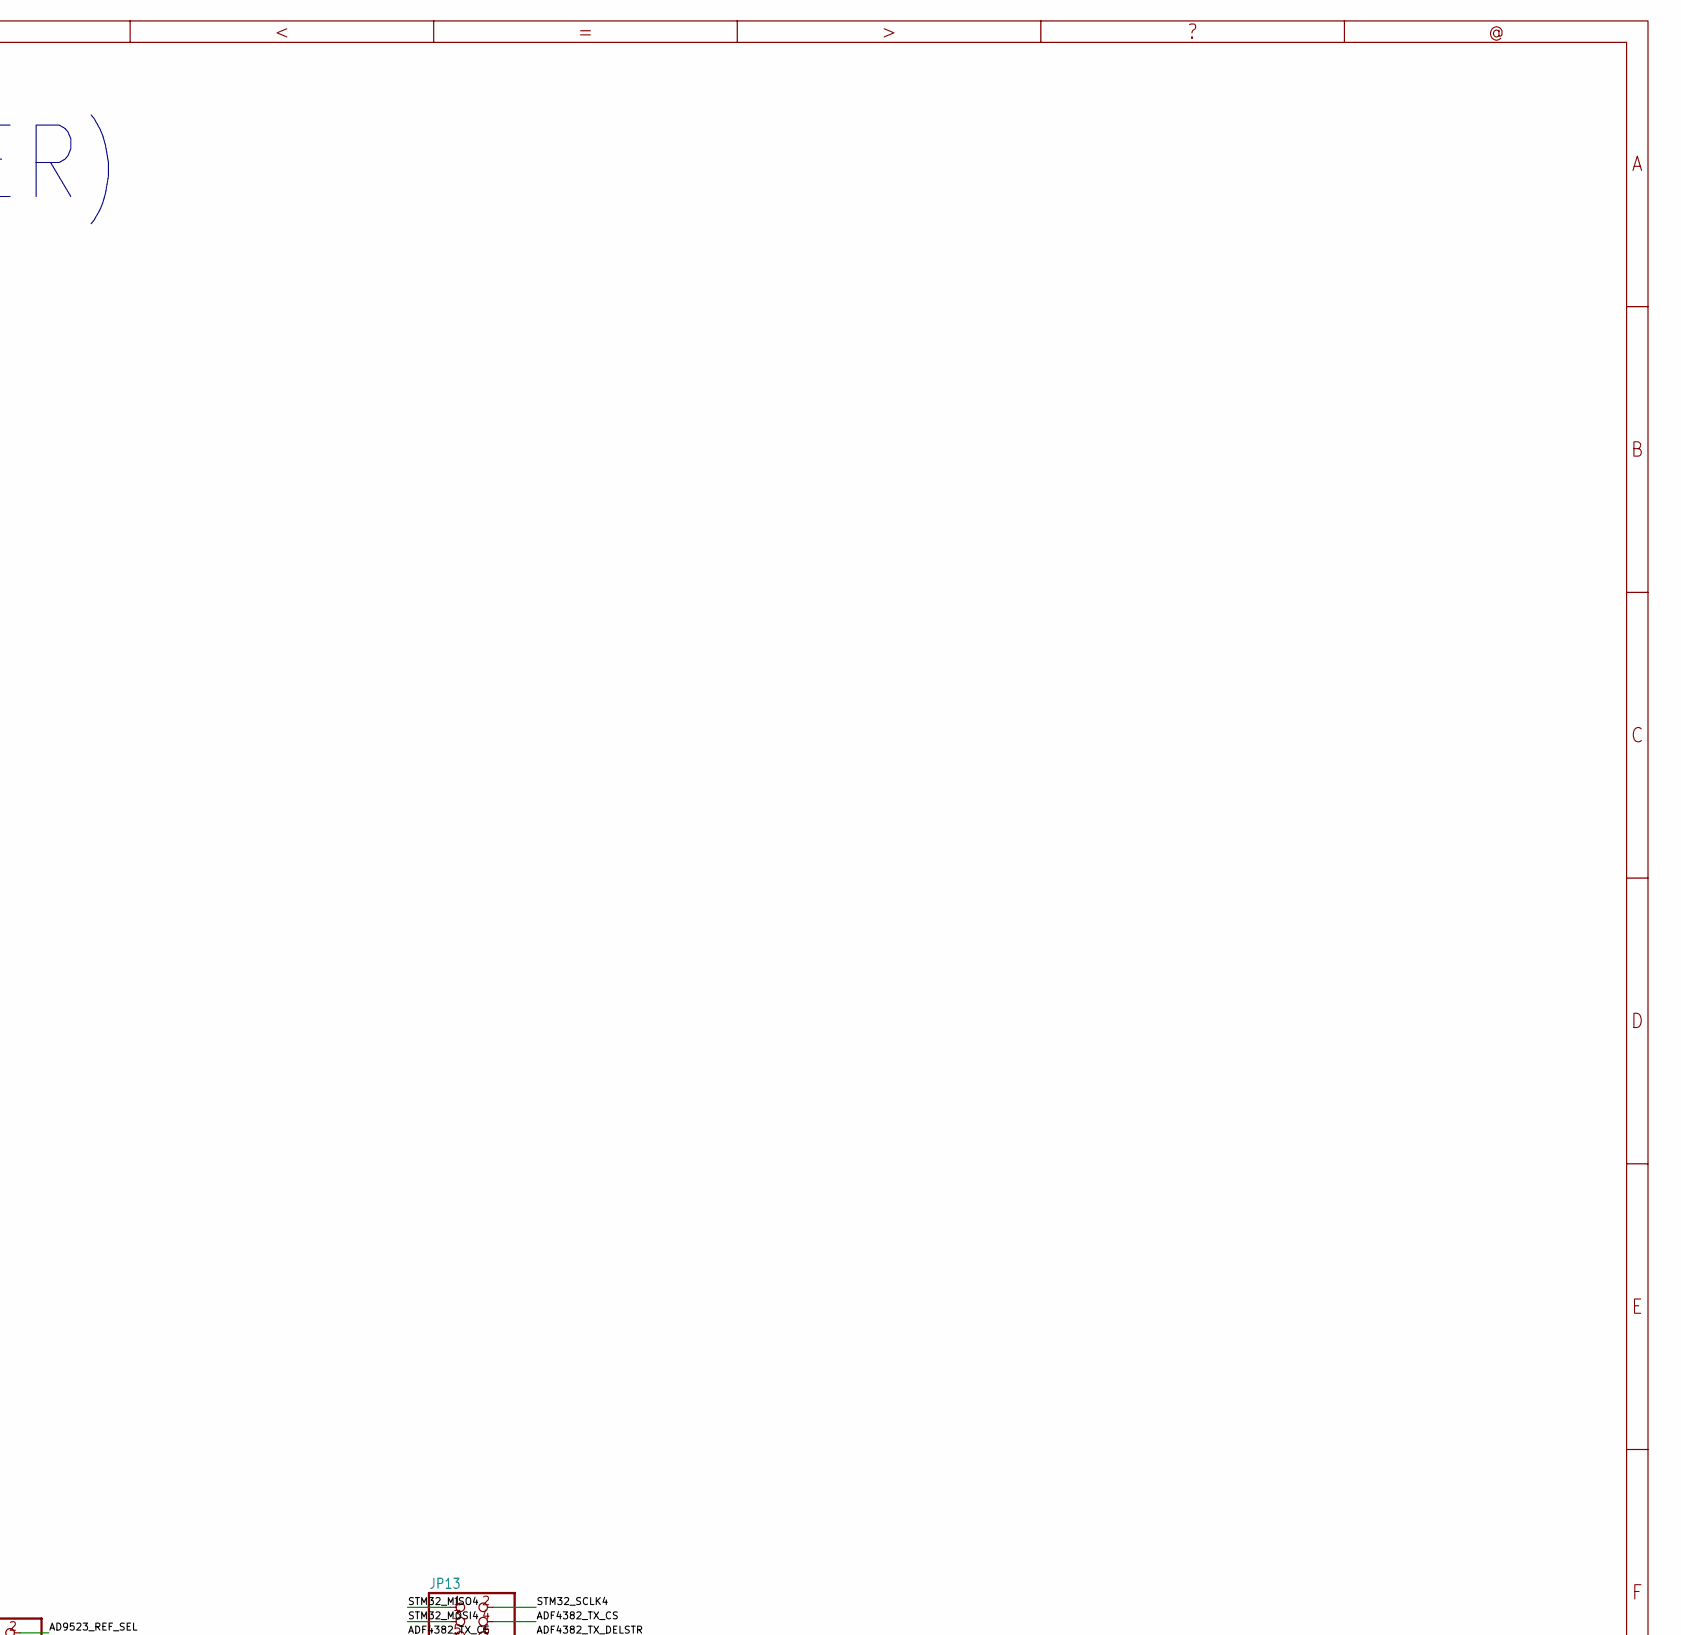
[picture p15: schematic RADAR_Main_Board_2.kicad_sch, part in row 1, column 3]

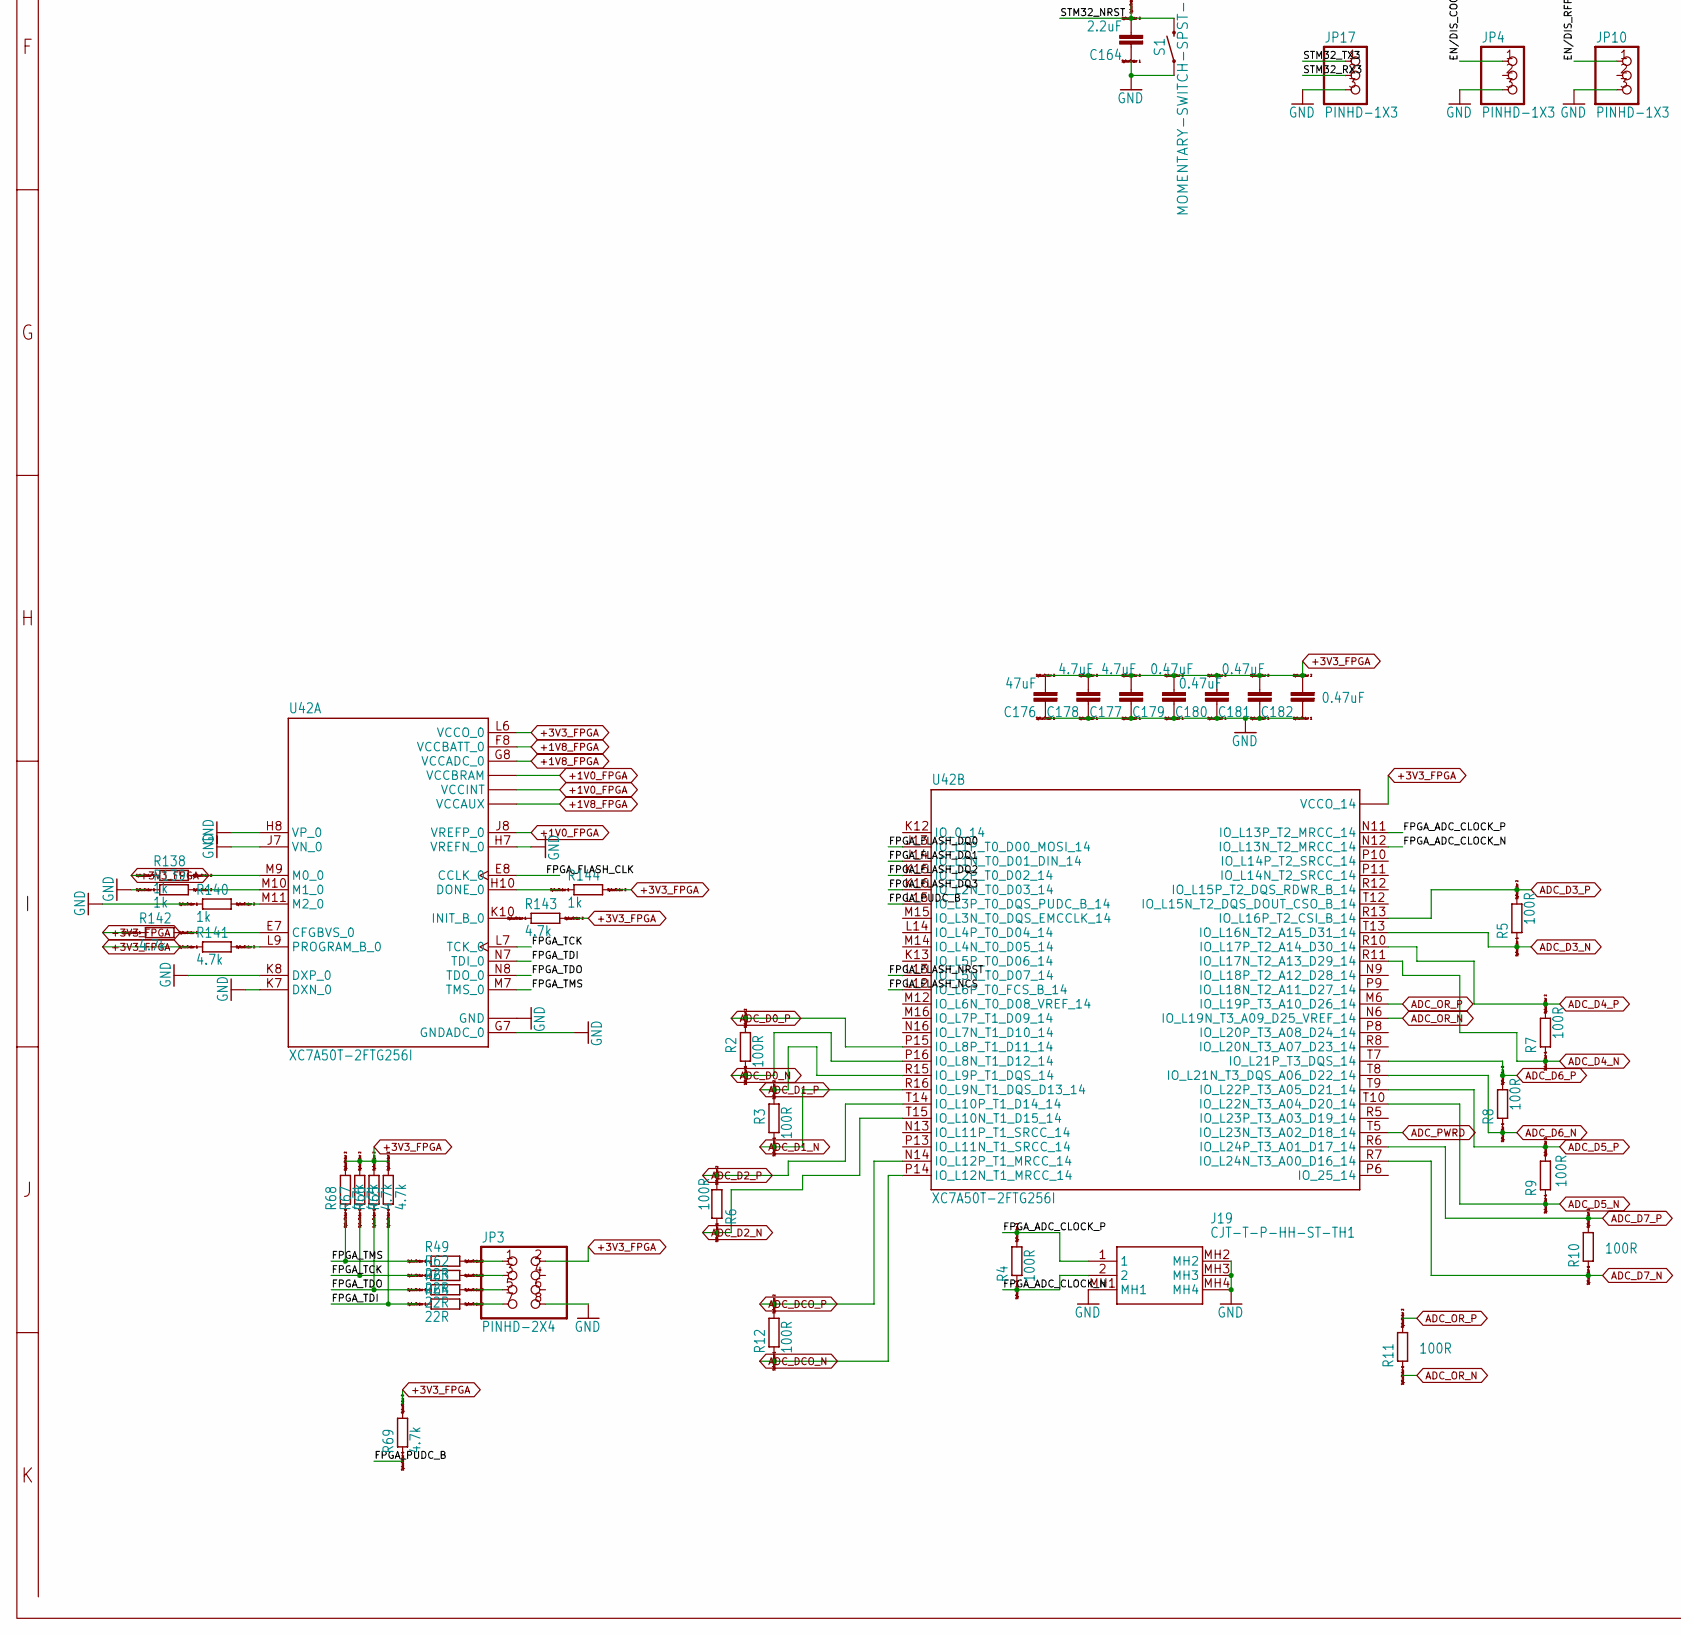
[picture p16: schematic RADAR_Main_Board_2.kicad_sch, part in row 2, column 1]

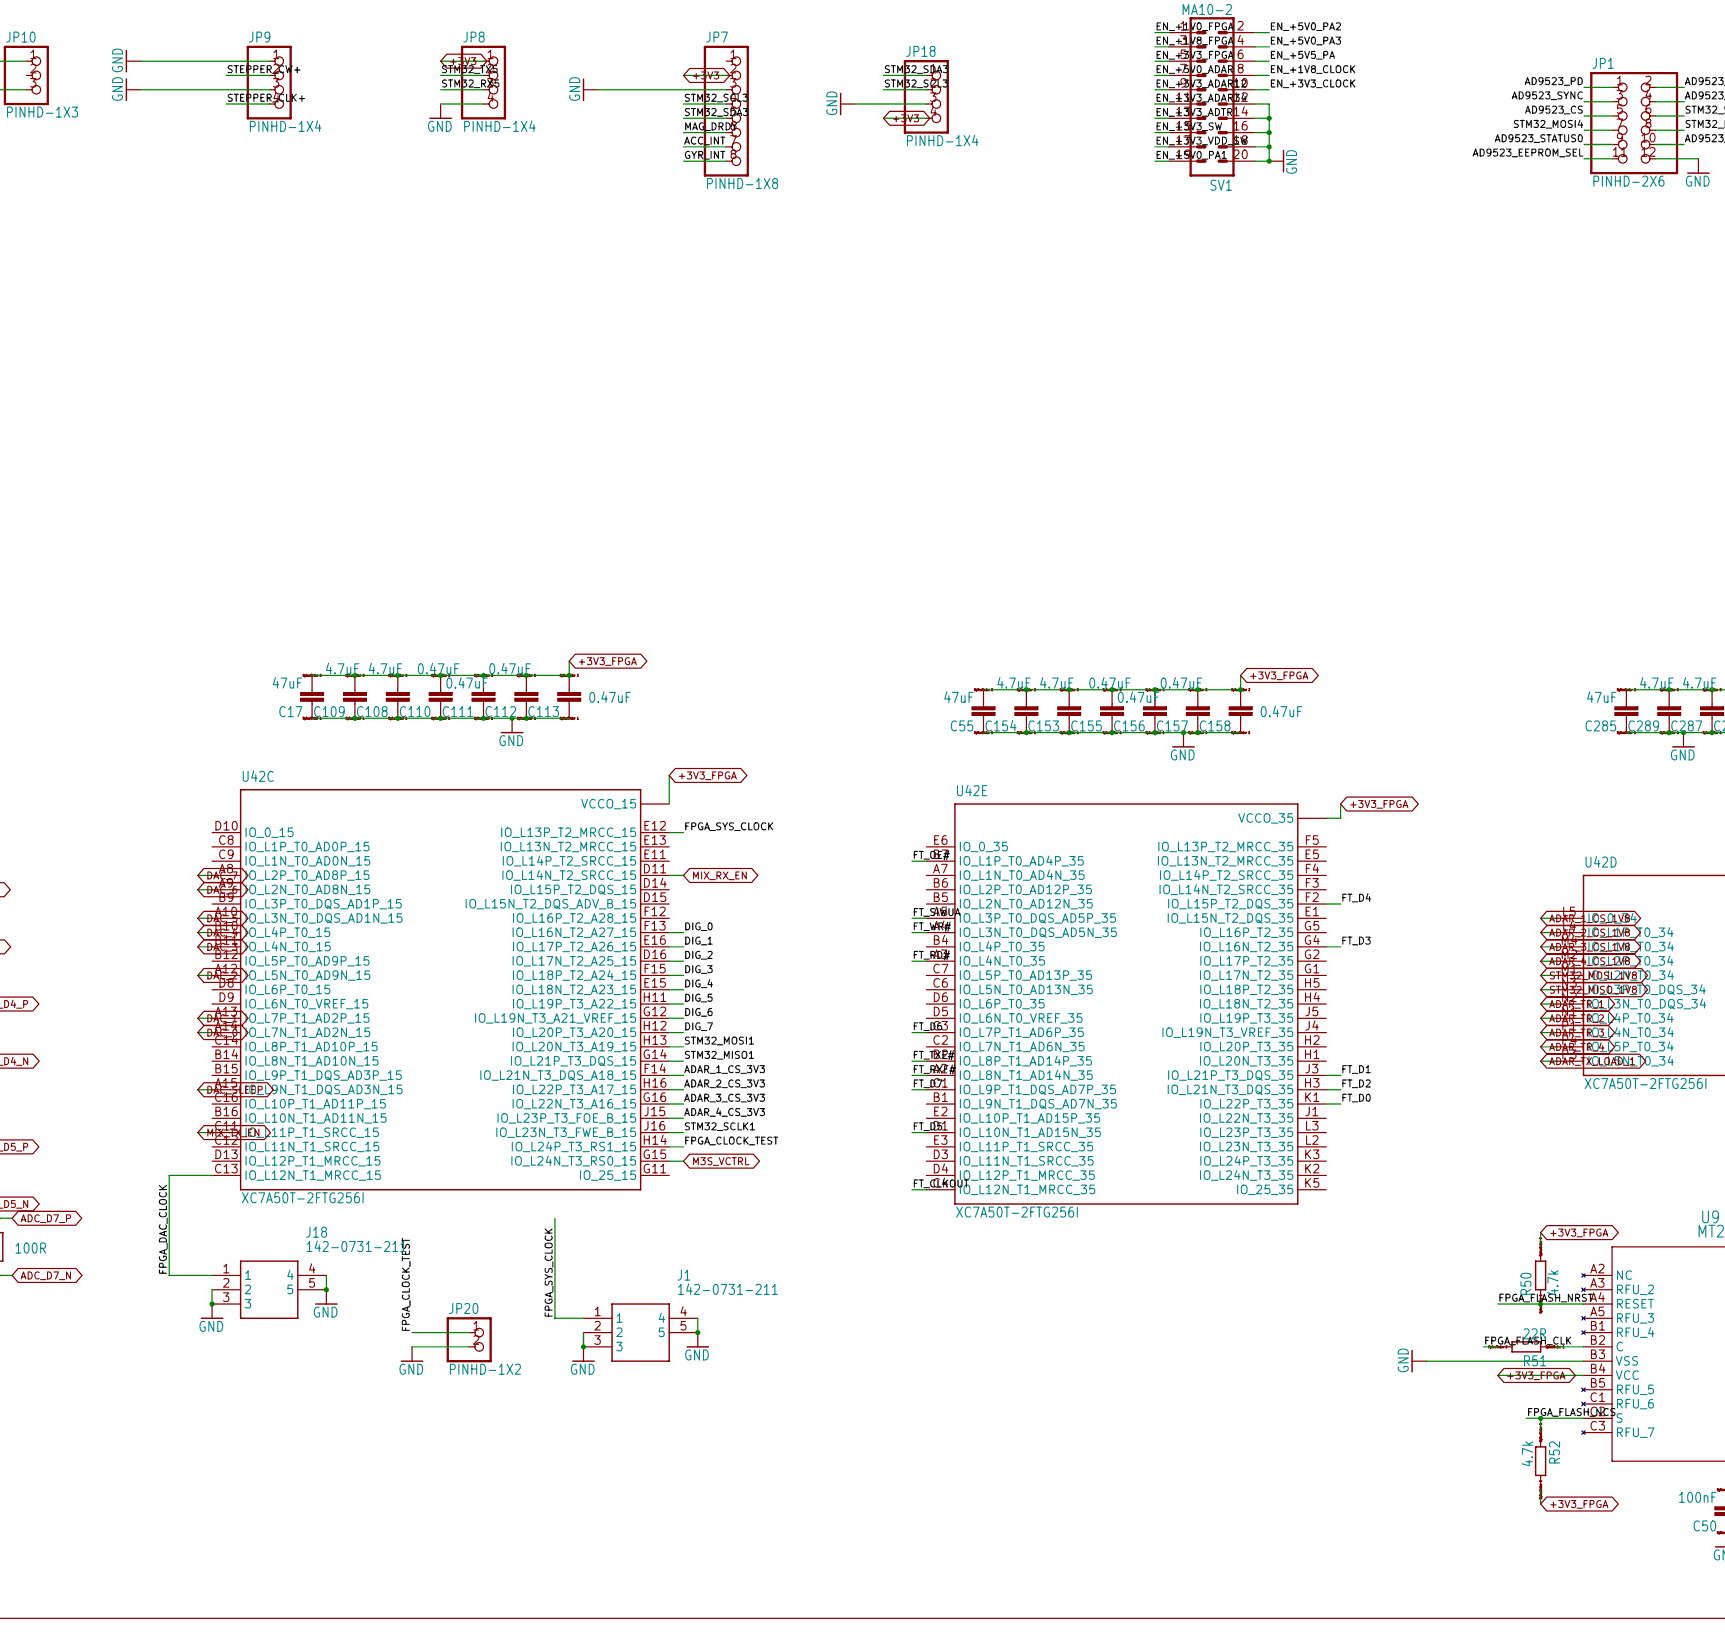
[picture p17: schematic RADAR_Main_Board_2.kicad_sch, part in row 2, column 2]

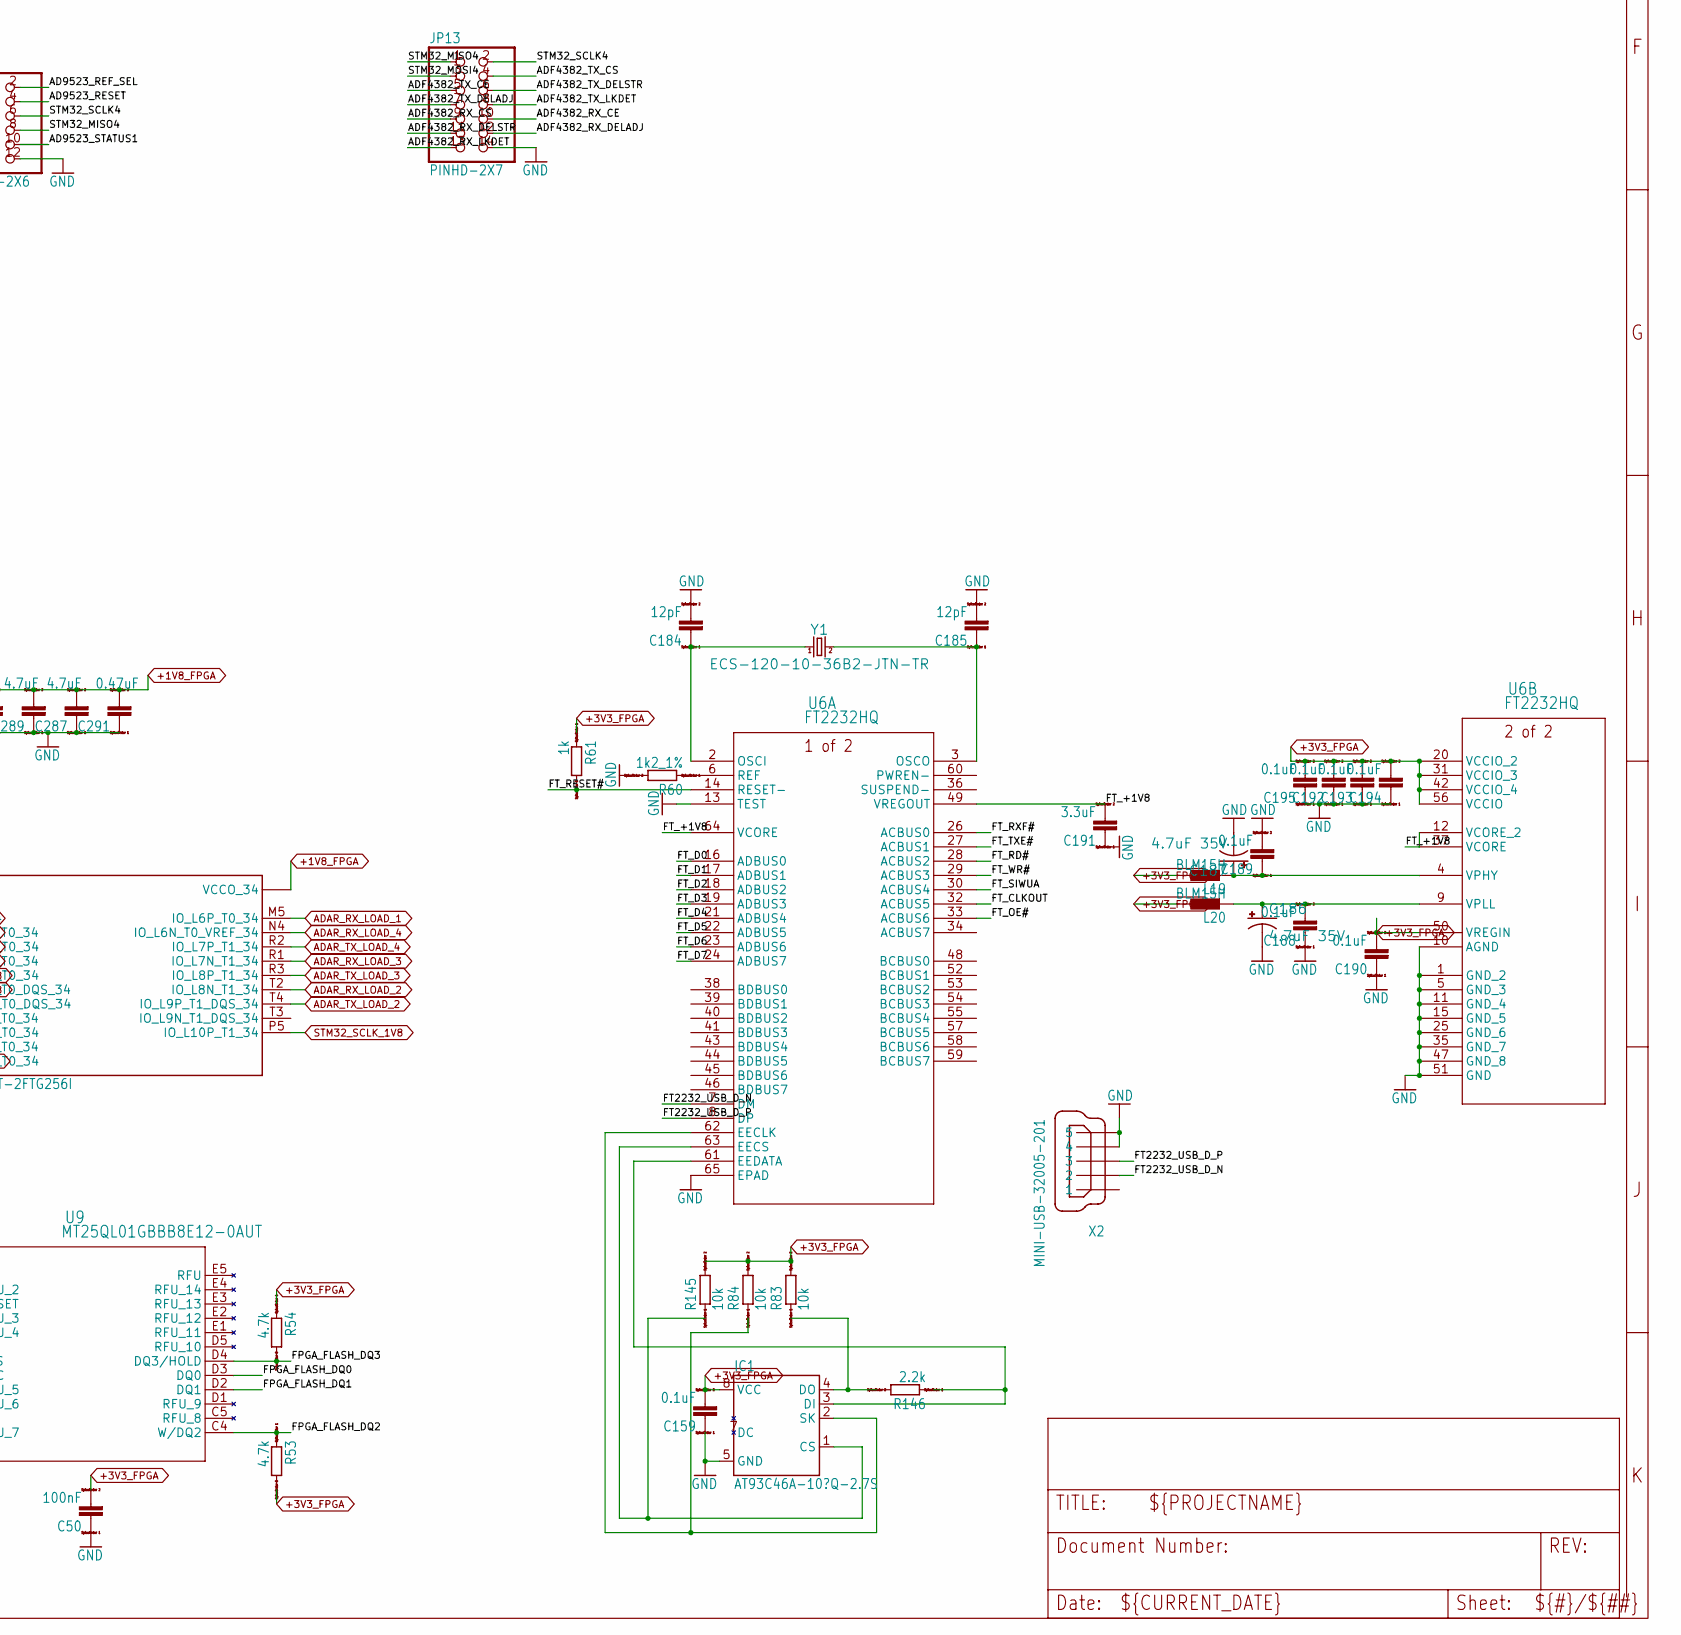
[picture p18: schematic RADAR_Main_Board_2.kicad_sch, part in row 2, column 3]

Parts:
C17, C55, C176, C285: 47uF; C0201
C18, C19: 2.7pF; C0201
C20, C21: 4.3pF; C0201
C22, C23, C164: 2.2uF; C0201
C24, C25, C26, C27, C28, C29, C30, C32, C33, C34, C35, C50, C279, C281: 100nF; C0201
C31: 47nF; C0201
C108, C109, C153, C154, C177, C178, C287, C289: 4.7uF; C0201
C110, C111, C112, C113, C155, C156, C157, C158, C179, C180, C181, C182, C291: 0.47uF; C0201
C159, C188, C189, C190, C192, C193, C194, C195: 0.1uF; C0201
C184, C185: 12pF; C0201
C186, C187: 4.7uF 35V; EIA3528
C191: 3.3uF; C0201
D2, D3, D4, D5: Blue; LED-0603
IC1: AT93C46A-10?Q-2.7S; SOIC8
J1, J18: 142-0731-211; 1420731211
J19: CJT-T-P-HH-ST-TH1; CJTTPHHSTTH1
JP1: PINHD-2X6; 2X06
JP2: PINHD-1X6; 1X06
JP3: PINHD-2X4; 2X04
JP4, JP10, JP17: PINHD-1X3; 1X03
JP7: PINHD-1X8; 1X08
JP8, JP9, JP18: PINHD-1X4; 1X04
JP13: PINHD-2X7; 2X07
JP20: PINHD-1X2; 1X02
L5, L19, L20: BLM15H; 0402
R2, R3, R4, R5, R6, R7, R8, R9, R10, R11, R12: 100R; R0201
R49, R51, R62, R63, R64: 22R; R0201
R50, R52, R53, R54, R65, R66, R67, R68, R69, R141, R142, R143: 4.7k; R0201
R60: 1k2_1%; R0201
R61, R138, R139, R140, R144, R167, R168, R169, R170, R171, R172: 1k; R0201
R83, R84, R111, R145: 10k; R0201
R110, R112, R113, R114: 500R; R0201
R146: 2.2k; R0201
S1: MOMENTARY-SWITCH-SPST-SMD-4.6X2.8MM; TACTILE_SWITCH_SMD_4.6X2.8MM
SV1: MA10-2
U2: STM32F746ZGT7; LQFP-144_STM
U6: FT2232HQ; 64QFN_FT2232HQ_FTD
U9: MT25QL01GBBB8E12-0AUT; BGA24_MT25QL_MRN
U42: XC7A50T-2FTG256I; BGA256C100P16X16_1700X1700X155
X2, X53: MINI-USB-32005-201; 32005-201
XTAL1: NX3225GD-8MHZ-STD-CRA-3; XTAL_NX3225GD-8MHZ-STD-CRA-3_N
XTAL3: NX3215SA-32.768KHz; XTAL_NX3225GD-8MHZ-STD-CRA-3_N
Y1: ECS-120-10-36B2-JTN-TR; CRYSTAL-SMD-2X2.5MM

Connections:
+1V0_FPGA: U42.E10 (VCCBRAM), U42.F7 (VCCINT), U42.F9 (VCCINT), U42.F11 (VCCBRAM), U42.G6 (VCCINT), U42.H9 (VCCINT), U42.J6 (VCCINT), U42.J8 (VREFP_0), U42.K9 (VCCINT), U42.L8 (VCCINT)
+1V8_FPGA: C285.2, C287.2, C289.2, C291.2, U42.F8 (VCCBATT_0), U42.G8 (VCCADC_0), U42.G10 (VCCAUX), U42.J10 (VCCAUX), U42.K11 (VCCAUX), U42.L10 (VCCAUX), U42.M3 (VCCO_34), U42.R4 (VCCO_34), U42.T1 (VCCO_34)
+3V3: C25.1, C26.1, C27.1, C28.1, C29.1, C30.1, C31.1, C32.1, C33.1, C34.1, C35.1, C279.1, C281.1, JP2.1, JP7.2, JP8.1, JP18.4, L5.2, R111.2, R167.1, R168.1, R169.1, R170.1, R171.1, R172.1, U2.6 (VBAT), U2.17 (VDD_2), U2.30 (VDD_3), U2.39 (VDD_4), U2.52 (VDD_5), U2.62 (VDD_6), U2.72 (VDD_7), U2.84 (VDD_8), U2.95 (VDDUSB), U2.108 (VDD_9), U2.121 (VDD_10), U2.131 (VDD_11), U2.143 (PDR_ON), U2.144 (VDD)
+3V3_FPGA: C17.2, C50.2, C55.2, C108.2, C109.2, C110.2, C111.2, C112.2, C113.2, C153.2, C154.2, C155.2, C156.2, C157.2, C158.2, C159.2, C176.2, C177.2, C178.2, C179.2, C180.2, C181.2, C182.2, C190.2, C192.2, C193.2, C194.2, C195.2, IC1.8 (VCC), JP3.2, L19.2, L20.2, R50.2, R52.2, R53.2, R54.1, R61.1, R65.2, R66.2, R67.2, R68.2, R69.2, R83.2, R84.2, R138.1, R141.1, R142.1, R143.2, R144.2, R145.2, U6.20 (VCCIO_2), U6.31 (VCCIO_3), U6.42 (VCCIO_4), U6.50 (VREGIN), U6.56 (VCCIO), U9.B4 (VCC), U42.A6 (VCCO_35), U42.A16 (VCCO_15), U42.B3 (VCCO_35), U42.B13 (VCCO_15), U42.C10 (VCCO_15), U42.D7 (VCCO_35), U42.E4 (VCCO_35), U42.E14 (VCCO_15), U42.F1 (VCCO_35), U42.H15 (VCCO_15), U42.J2 (VCCO_35), U42.J12 (VCCO_15), U42.L6 (VCCO_0), U42.L16 (VCCO_14), U42.M13 (VCCO_14), U42.N10 (VCCO_14), U42.P7 (VCCO_14), U42.R14 (VCCO_14), U42.T11 (VCCO_14)
ACC_INT: JP7.7, U2.97 (PC7)
AD9523_CS: JP1.5, U2.19 (PF7)
AD9523_EEPROM_SEL: JP1.11, U2.22 (PF10)
AD9523_PD: JP1.1, U2.13 (PF3)
AD9523_REF_SEL: JP1.2, U2.14 (PF4)
AD9523_RESET: JP1.4, U2.18 (PF6)
AD9523_STATUS0: JP1.9, U2.20 (PF8)
AD9523_STATUS1: JP1.10, U2.21 (PF9)
AD9523_SYNC: JP1.3, U2.15 (PF5)
ADAR_1_CS_1V8: U42.L5 (IO_0_34)
ADAR_1_CS_3V3: U2.34 (PA0), U42.F14 (IO_L21N_T3_DQS_A18_15)
ADAR_2_CS_1V8: U42.L4 (IO_L1P_T0_34)
ADAR_2_CS_3V3: U2.35 (PA1), U42.H16 (IO_L22P_T3_A17_15)
ADAR_3_CS_1V8: U42.M4 (IO_L1N_T0_34)
ADAR_3_CS_3V3: U2.36 (PA2), U42.G16 (IO_L22N_T3_A16_15)
ADAR_4_CS_1V8: U42.M2 (IO_L2P_T0_34)
ADAR_4_CS_3V3: U2.37 (PA3), U42.J15 (IO_L23P_T3_FOE_B_15)
ADAR_RX_LOAD_1: U42.M5 (IO_L6P_T0_34)
ADAR_RX_LOAD_2: U42.T2 (IO_L8N_T1_34)
ADAR_RX_LOAD_3: U42.R1 (IO_L7N_T1_34)
ADAR_RX_LOAD_4: U42.N4 (IO_L6N_T0_VREF_34)
ADAR_TR_1: U42.N2 (IO_L3N_T0_DQS_34)
ADAR_TR_2: U42.N1 (IO_L4P_T0_34)
ADAR_TR_3: U42.P1 (IO_L4N_T0_34)
ADAR_TR_4: U42.P4 (IO_L5P_T0_34)
ADAR_TX_LOAD_1: U42.P3 (IO_L5N_T0_34)
ADAR_TX_LOAD_2: U42.T4 (IO_L9P_T1_DQS_34)
ADAR_TX_LOAD_3: U42.R3 (IO_L8P_T1_34)
ADAR_TX_LOAD_4: U42.R2 (IO_L7P_T1_34)
ADC_D0_N: R2.1, U42.P16 (IO_L8N_T1_D12_14)
ADC_D0_P: R2.2, U42.P15 (IO_L8P_T1_D11_14)
ADC_D1_N: R3.1, U42.R16 (IO_L9N_T1_DQS_D13_14)
ADC_D1_P: R3.2, U42.R15 (IO_L9P_T1_DQS_14)
ADC_D2_N: R6.1, U42.T15 (IO_L10N_T1_D15_14)
ADC_D2_P: R6.2, U42.T14 (IO_L10P_T1_D14_14)
ADC_D3_N: R5.1, U42.T13 (IO_L16N_T2_A15_D31_14)
ADC_D3_P: R5.2, U42.R13 (IO_L16P_T2_CSI_B_14)
ADC_D4_N: R7.1, U42.R11 (IO_L17N_T2_A13_D29_14)
ADC_D4_P: R7.2, U42.R10 (IO_L17P_T2_A14_D30_14)
ADC_D5_N: R9.1, U42.T10 (IO_L22N_T3_A04_D20_14)
ADC_D5_P: R9.2, U42.T9 (IO_L22P_T3_A05_D21_14)
ADC_D6_N: R8.1, U42.T8 (IO_L21N_T3_DQS_A06_D22_14)
ADC_D6_P: R8.2, U42.T7 (IO_L21P_T3_DQS_14)
ADC_D7_N: R10.1, U42.R7 (IO_L24N_T3_A00_D16_14)
ADC_D7_P: R10.2, U42.R6 (IO_L24P_T3_A01_D17_14)
ADC_DCO_N: R12.1, U42.P14 (IO_L12N_T1_MRCC_14)
ADC_DCO_P: R12.2, U42.N14 (IO_L12P_T1_MRCC_14)
ADC_OR_N: R11.1, U42.N6 (IO_L19N_T3_A09_D25_VREF_14)
ADC_OR_P: R11.2, U42.M6 (IO_L19P_T3_A10_D26_14)
ADC_PWRD: U42.T5 (IO_L23N_T3_A02_D18_14)
ADF4382_RX_CE: JP13.10, U2.124 (PG9)
ADF4382_RX_CS: JP13.9, U2.125 (PG10)
ADF4382_RX_DELADJ: JP13.12, U2.92 (PG7)
ADF4382_RX_DELSTR: JP13.11, U2.93 (PG8)
ADF4382_RX_LKDET: JP13.13, U2.91 (PG6)
ADF4382_TX_CE: JP13.5, U2.132 (PG15)
ADF4382_TX_CS: JP13.4, U2.129 (PG14)
ADF4382_TX_DELADJ: JP13.7, U2.128 (PG13)
ADF4382_TX_DELSTR: JP13.6, U2.127 (PG12)
ADF4382_TX_LKDET: JP13.8, U2.126 (PG11)
DAC_0: U42.A14 (IO_L7N_T1_AD2N_15)
DAC_1: U42.A13 (IO_L7P_T1_AD2P_15)
DAC_1_VG_CLR: U2.134 (PB4)
DAC_1_VG_LDAC: U2.135 (PB5)
DAC_2: U42.A12 (IO_L5N_T0_AD9N_15)
DAC_2_VG_CLR: U2.139 (PB8)
DAC_2_VG_LDAC: U2.140 (PB9)
DAC_3: U42.B11 (IO_L4N_T0_15)
DAC_4: U42.B10 (IO_L4P_T0_15)
DAC_5: U42.A10 (IO_L3N_T0_DQS_AD1N_15)
DAC_6: U42.A9 (IO_L2N_T0_AD8N_15)
DAC_7: U42.A8 (IO_L2P_T0_AD8P_15)
DAC_SLEEP: U42.A15 (IO_L9N_T1_DQS_AD3N_15)
DIG_0: U2.77 (PD8), U42.F13 (IO_L16N_T2_A27_15)
DIG_1: U2.78 (PD9), U42.E16 (IO_L17P_T2_A26_15)
DIG_2: U2.79 (PD10), U42.D16 (IO_L17N_T2_A25_15)
DIG_3: U2.80 (PD11), U42.F15 (IO_L18P_T2_A24_15)
DIG_4: U2.81 (PD12), U42.E15 (IO_L18N_T2_A23_15)
DIG_5: U2.82 (PD13), U42.H11 (IO_L19P_T3_A22_15)
DIG_6: U2.85 (PD14), U42.G12 (IO_L19N_T3_A21_VREF_15)
DIG_7: U2.86 (PD15), U42.H12 (IO_L20P_T3_A20_15)
EN/DIS_COOLING: JP4.1, U2.123 (PD7)
EN/DIS_RFPA_VDD: JP10.1, U2.122 (PD6)
EN_+1V0_FPGA: SV1.1, U2.58 (PE7)
EN_+1V8_CLOCK: SV1.8, U2.89 (PG4)
EN_+1V8_FPGA: SV1.3, U2.59 (PE8)
EN_+3V3_ADAR12: SV1.9, U2.64 (PE11)
EN_+3V3_ADAR34: SV1.11, U2.65 (PE12)
EN_+3V3_ADTR: SV1.13, U2.66 (PE13)
EN_+3V3_CLOCK: SV1.10, U2.90 (PG5)
EN_+3V3_FPGA: SV1.5, U2.60 (PE9)
EN_+3V3_SW: SV1.15, U2.67 (PE14)
EN_+3V3_VDD_SW: SV1.17, U2.68 (PE15)
EN_+5V0_ADAR: SV1.7, U2.63 (PE10)
EN_+5V0_PA1: SV1.19, U2.56 (PG0)
EN_+5V0_PA2: SV1.2, U2.57 (PG1)
EN_+5V0_PA3: SV1.4, U2.87 (PG2)
EN_+5V5_PA: SV1.6, U2.88 (PG3)
FPGA_ADC_CLOCK_N: J19.2, R4.1, U42.N12 (IO_L13N_T2_MRCC_14)
FPGA_ADC_CLOCK_P: J19.1, R4.2, U42.N11 (IO_L13P_T2_MRCC_14)
FPGA_CLOCK_TEST: JP20.1, U42.H14 (IO_L24P_T3_RS1_15)
FPGA_DAC_CLOCK: J18.1, U42.C13 (IO_L12N_T1_MRCC_15)
FPGA_FLASH_CLK: R51.2, U42.E8 (CCLK_0)
FPGA_FLASH_DQ0: U9.D3 (DQ0), U42.J13 (IO_L1P_T0_D00_MOSI_14)
FPGA_FLASH_DQ1: U9.D2 (DQ1), U42.J14 (IO_L1N_T0_D01_DIN_14)
FPGA_FLASH_DQ2: R53.1, U9.C4 (W/DQ2), U42.K15 (IO_L2P_T0_D02_14)
FPGA_FLASH_DQ3: R54.2, U9.D4 (DQ3/HOLD), U42.K16 (IO_L2N_T0_D03_14)
FPGA_FLASH_NCS: R52.1, U9.C2 (S), U42.L12 (IO_L6P_T0_FCS_B_14)
FPGA_FLASH_NRST: R50.1, U9.A4 (RESET), U42.L13 (IO_L5N_T0_D07_14)
FPGA_PUDC_B: R69.1, U42.L15 (IO_L3P_T0_DQS_PUDC_B_14)
FPGA_SYS_CLOCK: J1.1, U42.E12 (IO_L13P_T2_MRCC_15)
FPGA_TCK: R62.1, R67.1, U42.L7 (TCK_0)
FPGA_TDI: R64.1, R65.1, U42.N7 (TDI_0)
FPGA_TDO: R63.1, R66.1, U42.N8 (TDO_0)
FPGA_TMS: R49.1, R68.1, U42.M7 (TMS_0)
FT2232_USB_D_N: U6.7 (DM), X2.2
FT2232_USB_D_P: U6.8 (DP), X2.3
FT_+1V8: C191.2, U6.12 (VCORE_2), U6.37 (VCORE), U6.49 (VREGOUT), U6.64 (VCORE)
FT_CLKOUT: U6.32 (ACBUS5), U42.C4 (IO_L12N_T1_MRCC_35)
FT_D0: U6.16 (ADBUS0), U42.K1 (IO_L22P_T3_35)
FT_D1: U6.17 (ADBUS1), U42.J3 (IO_L21P_T3_DQS_35)
FT_D2: U6.18 (ADBUS2), U42.H3 (IO_L21N_T3_DQS_35)
FT_D3: U6.19 (ADBUS3), U42.G4 (IO_L16N_T2_35)
FT_D4: U6.21 (ADBUS4), U42.F2 (IO_L15P_T2_DQS_35)
FT_D5: U6.22 (ADBUS5), U42.D1 (IO_L10N_T1_AD15N_35)
FT_D6: U6.23 (ADBUS6), U42.C3 (IO_L7P_T1_AD6P_35)
FT_D7: U6.24 (ADBUS7), U42.C1 (IO_L9P_T1_DQS_AD7P_35)
FT_OE#: U6.33 (ACBUS6), U42.B7 (IO_L1P_T0_AD4P_35)
FT_RD#: U6.28 (ACBUS2), U42.A3 (IO_L4N_T0_35)
FT_RESET#: R61.2, U6.14 (RESET-)
FT_RXF#: U6.26 (ACBUS0), U42.A2 (IO_L8N_T1_AD14N_35)
FT_SIWUA: U6.30 (ACBUS4), U42.A5 (IO_L3P_T0_DQS_AD5P_35)
FT_TXE#: U6.27 (ACBUS1), U42.B2 (IO_L8P_T1_AD14P_35)
FT_WR#: U6.29 (ACBUS3), U42.A4 (IO_L3N_T0_DQS_AD5N_35)
GND: C17.1, C18.2, C19.2, C20.2, C21.2, C22.2, C23.2, C24.2, C25.2, C26.2, C27.2, C28.2, C29.2, C30.2, C31.2, C32.2, C33.2, C34.2, C35.2, C50.1, C55.1, C108.1, C109.1, C110.1, C111.1, C112.1, C113.1, C153.1, C154.1, C155.1, C156.1, C157.1, C158.1, C159.1, C164.1, C176.1, C177.1, C178.1, C179.1, C180.1, C181.1, C182.1, C184.2, C185.2, C186.C (-), C187.C (-), C188.1, C189.2, C190.1, C191.1, C192.1, C193.1, C194.1, C195.1, C279.2, C281.2, C285.1, C287.1, C289.1, C291.1, D2.C, D3.C, D4.C, D5.C, IC1.5 (GND), J1.2, J1.3, J1.4, J1.5, J18.2, J18.3, J18.4, J18.5, J19.MH1, J19.MH2, J19.MH3, J19.MH4, JP1.12, JP2.3, JP3.8, JP4.3, JP7.3, JP8.4, JP9.1, JP9.3, JP10.3, JP13.14, JP17.3, JP18.3, JP20.2, R60.2, R139.1, R140.1, S1.1, S1.2 (1), SV1.12, SV1.14, SV1.16, SV1.18, SV1.20, U2.16 (VSS_2), U2.31 (VSSA), U2.38 (VSS_3), U2.51 (VSS_4), U2.61 (VSS_5), U2.83 (VSS_6), U2.94 (VSS_7), U2.107 (VSS_8), U2.120 (VSS_9), U2.130 (VSS), U2.138 (BOOT0), U6.1 (GND_2), U6.5 (GND_3), U6.10 (AGND), U6.11 (GND_4), U6.13 (TEST), U6.15 (GND_5), U6.25 (GND_6), U6.35 (GND_7), U6.47 (GND_8), U6.51 (GND), U6.65 (EPAD), U9.B3 (VSS), U42.A1 (GND), U42.A11 (GND), U42.B8 (GND), U42.C5 (GND), U42.C15 (GND), U42.D2 (GND), U42.D12 (GND), U42.E9 (GND), U42.F6 (GND), U42.F10 (GND), U42.F16 (GND), U42.G3 (GND), U42.G7 (GNDADC_0), U42.G9 (GND), U42.G13 (GND), U42.H6 (GND), U42.H7 (VREFN_0), U42.H8 (VP_0), U42.J7 (VN_0), U42.J9 (GND), U42.J11 (GND), U42.K4 (GND), U42.K6 (GND), U42.K7 (DXN_0), U42.K8 (DXP_0), U42.K14 (GND), U42.L1 (GND), U42.L11 (GND), U42.M8 (GND), U42.N5 (GND), U42.N15 (GND), U42.P2 (GND), U42.P12 (GND), U42.R9 (GND), U42.T6 (GND), U42.T16 (GND), X2.4, X2.5, X53.5
GYR_INT: JP7.8, U2.98 (PC8)
M3S_VCTRL: U42.G15 (IO_L24N_T3_RS0_15)
MAG_DRDY: JP7.6, U2.96 (PC6)
MIX_RX_EN: U42.D11 (IO_L14N_T2_SRCC_15)
MIX_TX_EN: U42.C11 (IO_L11P_T1_SRCC_15)
unnamed: C22.1, U2.106 (VCAP_2)
unnamed: C23.1, U2.71 (VCAP_1)
unnamed: C24.1, L5.1, U2.32 (VREF+), U2.33 (VDDA)
unnamed: C184.1, U6.2 (OSCI), Y1.P1 (1)
unnamed: C185.1, U6.3 (OSCO), Y1.P3 (2)
unnamed: C186.A (+), C188.2, L20.1, U6.9 (VPLL)
unnamed: C187.A (+), C189.1, L19.1, U6.4 (VPHY)
unnamed: D2.A, R113.1
unnamed: D3.A, R114.1
unnamed: D4.A, R112.1
unnamed: D5.A, R110.1
unnamed: IC1.1 (CS), R145.1, U6.63 (EECS)
unnamed: IC1.2 (SK), R84.1, U6.62 (EECLK)
unnamed: IC1.3 (DI), R146.1, U6.61 (EEDATA)
unnamed: IC1.4 (DO), R83.1, R146.2
unnamed: JP3.1, R49.2
unnamed: JP3.3, R62.2
unnamed: JP3.5, R63.2
unnamed: JP3.7, R64.2
unnamed: R51.1, U9.B2 (C)
unnamed: R60.1, U6.6 (REF)
unnamed: R110.2, U2.50 (PF12)
unnamed: R112.2, U2.53 (PF13)
unnamed: R113.2, U2.54 (PF14)
unnamed: R114.2, U2.55 (PF15)
unnamed: R138.2, U42.M9 (M0_0)
unnamed: R139.2, U42.M10 (M1_0)
unnamed: R140.2, U42.M11 (M2_0)
unnamed: R141.2, U42.L9 (PROGRAM_B_0)
unnamed: R142.2, U42.E7 (CFGBVS_0)
unnamed: R143.1, U42.K10 (INIT_B_0)
unnamed: R144.1, U42.H10 (DONE_0)
STEPPER_CLK+: JP9.4, U2.119 (PD5)
STEPPER_CW+: JP9.2, U2.118 (PD4)
STM32_MISO1: U2.42 (PA6), U42.G14 (IO_L21P_T3_DQS_15)
STM32_MISO4: JP1.8, JP13.1, U2.4 (PE5)
STM32_MISO_1V8: U42.N3 (IO_L3P_T0_DQS_34)
STM32_MOSI1: U2.43 (PA7), U42.H13 (IO_L20N_T3_A19_15)
STM32_MOSI4: JP1.7, JP13.3, U2.5 (PE6)
STM32_MOSI_1V8: U42.M1 (IO_L2N_T0_34)
STM32_NRST: C164.2, JP2.5, R111.1, S1.3 (2), S1.4 (2), U2.25 (NRST)
STM32_OSC_32_N: C18.1, U2.8 (PC14), XTAL3.2
STM32_OSC_32_P: C19.1, U2.9 (PC15), XTAL3.1
STM32_OSC_N: C20.1, U2.23 (PH0), XTAL1.2
STM32_OSC_P: C21.1, U2.24 (PH1), XTAL1.1
STM32_RX3: JP17.2, U2.70 (PB11)
STM32_RX5: JP8.3, U2.116 (PD2)
STM32_SCL1: R170.2, U2.136 (PB6)
STM32_SCL2: R172.2, U2.11 (PF1)
STM32_SCL3: JP7.4, JP18.2, R167.2, U2.100 (PA8)
STM32_SCLK1: U2.41 (PA5), U42.J16 (IO_L23N_T3_FWE_B_15)
STM32_SCLK4: JP1.6, JP13.2, U2.1 (PE2)
STM32_SCLK_1V8: U42.P5 (IO_L10P_T1_34)
STM32_SDA1: R169.2, U2.137 (PB7)
STM32_SDA2: R171.2, U2.10 (PF0)
STM32_SDA3: JP7.5, JP18.1, R168.2, U2.99 (PC9)
STM32_SWCLK: JP2.2, U2.109 (PA14)
STM32_SWDIO: JP2.4, U2.105 (PA13)
STM32_SWO: JP2.6, U2.133 (PB3)
STM32_TX3: JP17.1, U2.69 (PB10)
STM32_TX5: JP8.2, U2.113 (PC12)
STM32_USB_FS_D_N: U2.103 (PA11), X53.2
STM32_USB_FS_D_P: U2.104 (PA12), X53.3
STM32_USB_FS_ID: U2.102 (PA10), X53.4

Notes on the sheet:
DIGITAL (FPGA + MICROCONTROLLER)
