MekhyW/PLFM_RADAR/4_Schematics and Boards Layout/4_6_Schematics/MainBoard/MainBoard_KiCad/RADAR_Main_Board_3.kicad_sch

## KiCad design 4_Schematics and Boards Layout/4_6_Schematics/MainBoard/MainBoard_KiCad/RADAR_Main_Board_3.kicad_sch (2026-05-20)

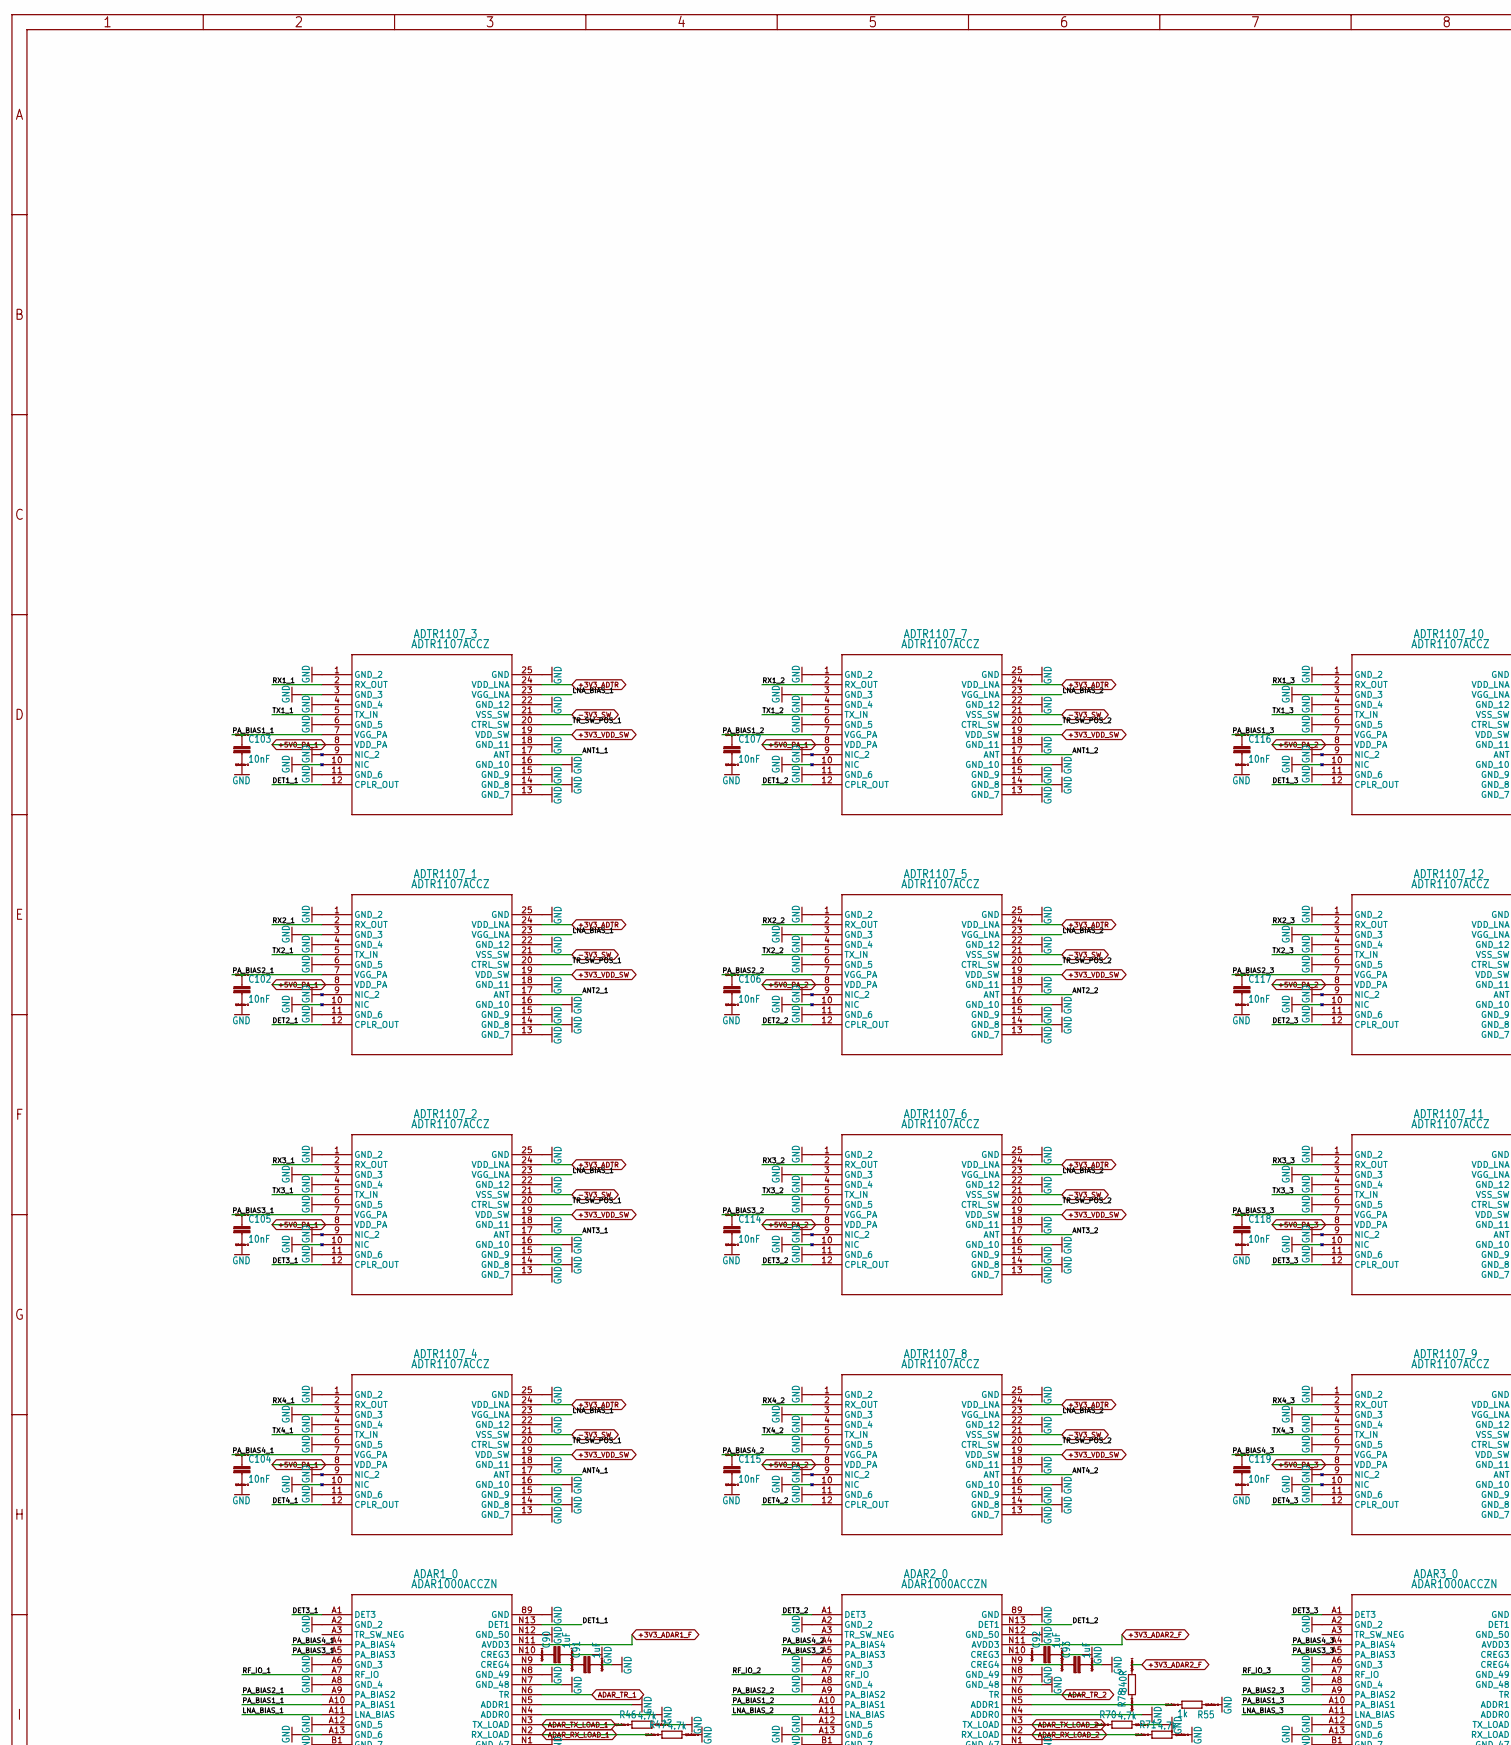
[picture p19: schematic RADAR_Main_Board_3.kicad_sch, part in row 1, column 1]

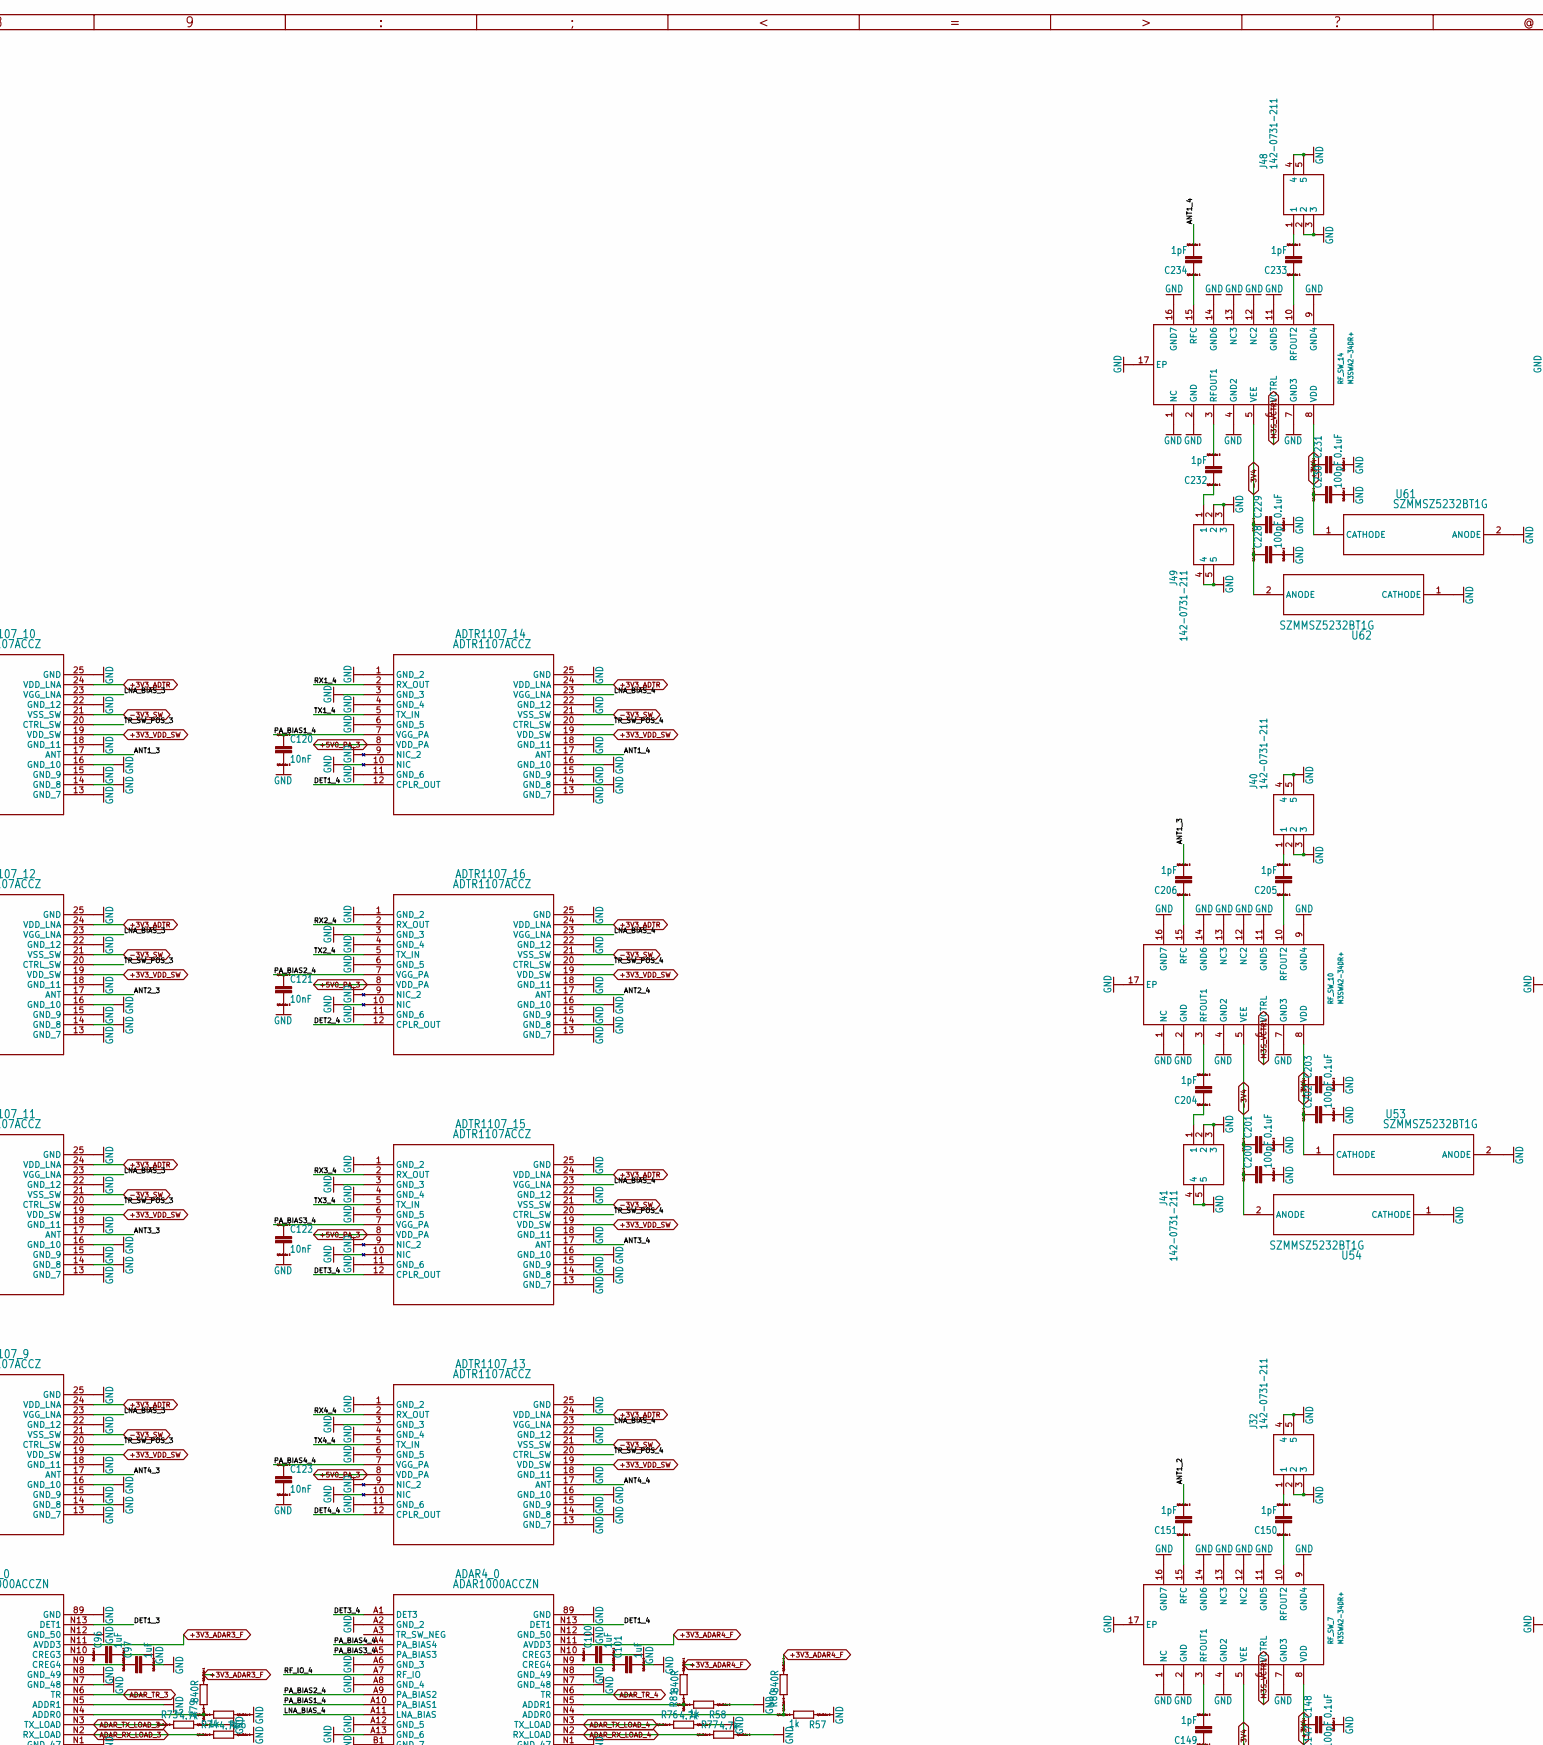
[picture p20: schematic RADAR_Main_Board_3.kicad_sch, part in row 1, column 2]

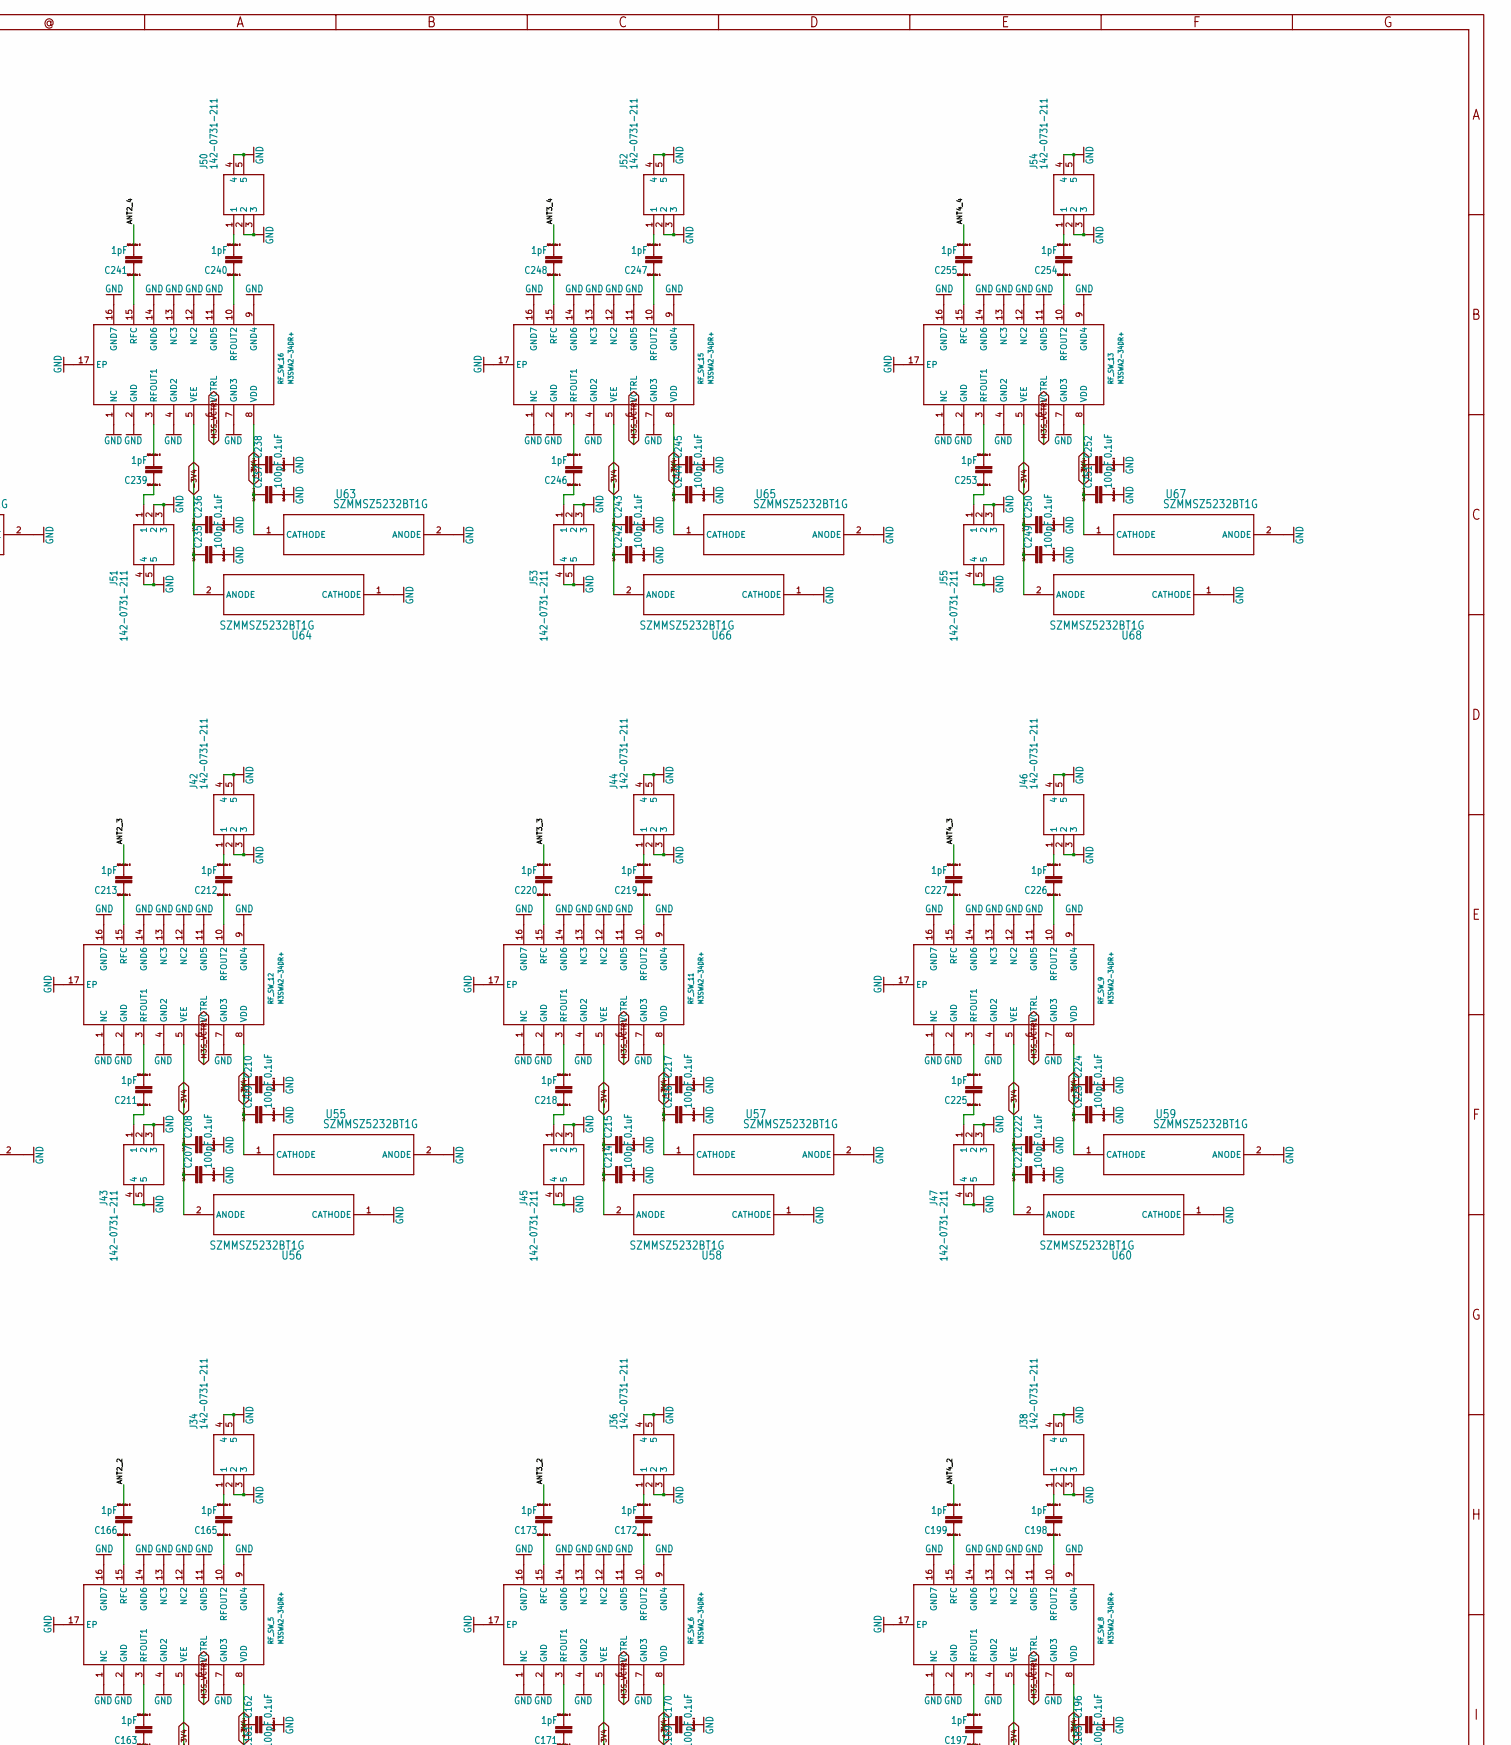
[picture p21: schematic RADAR_Main_Board_3.kicad_sch, part in row 1, column 3]

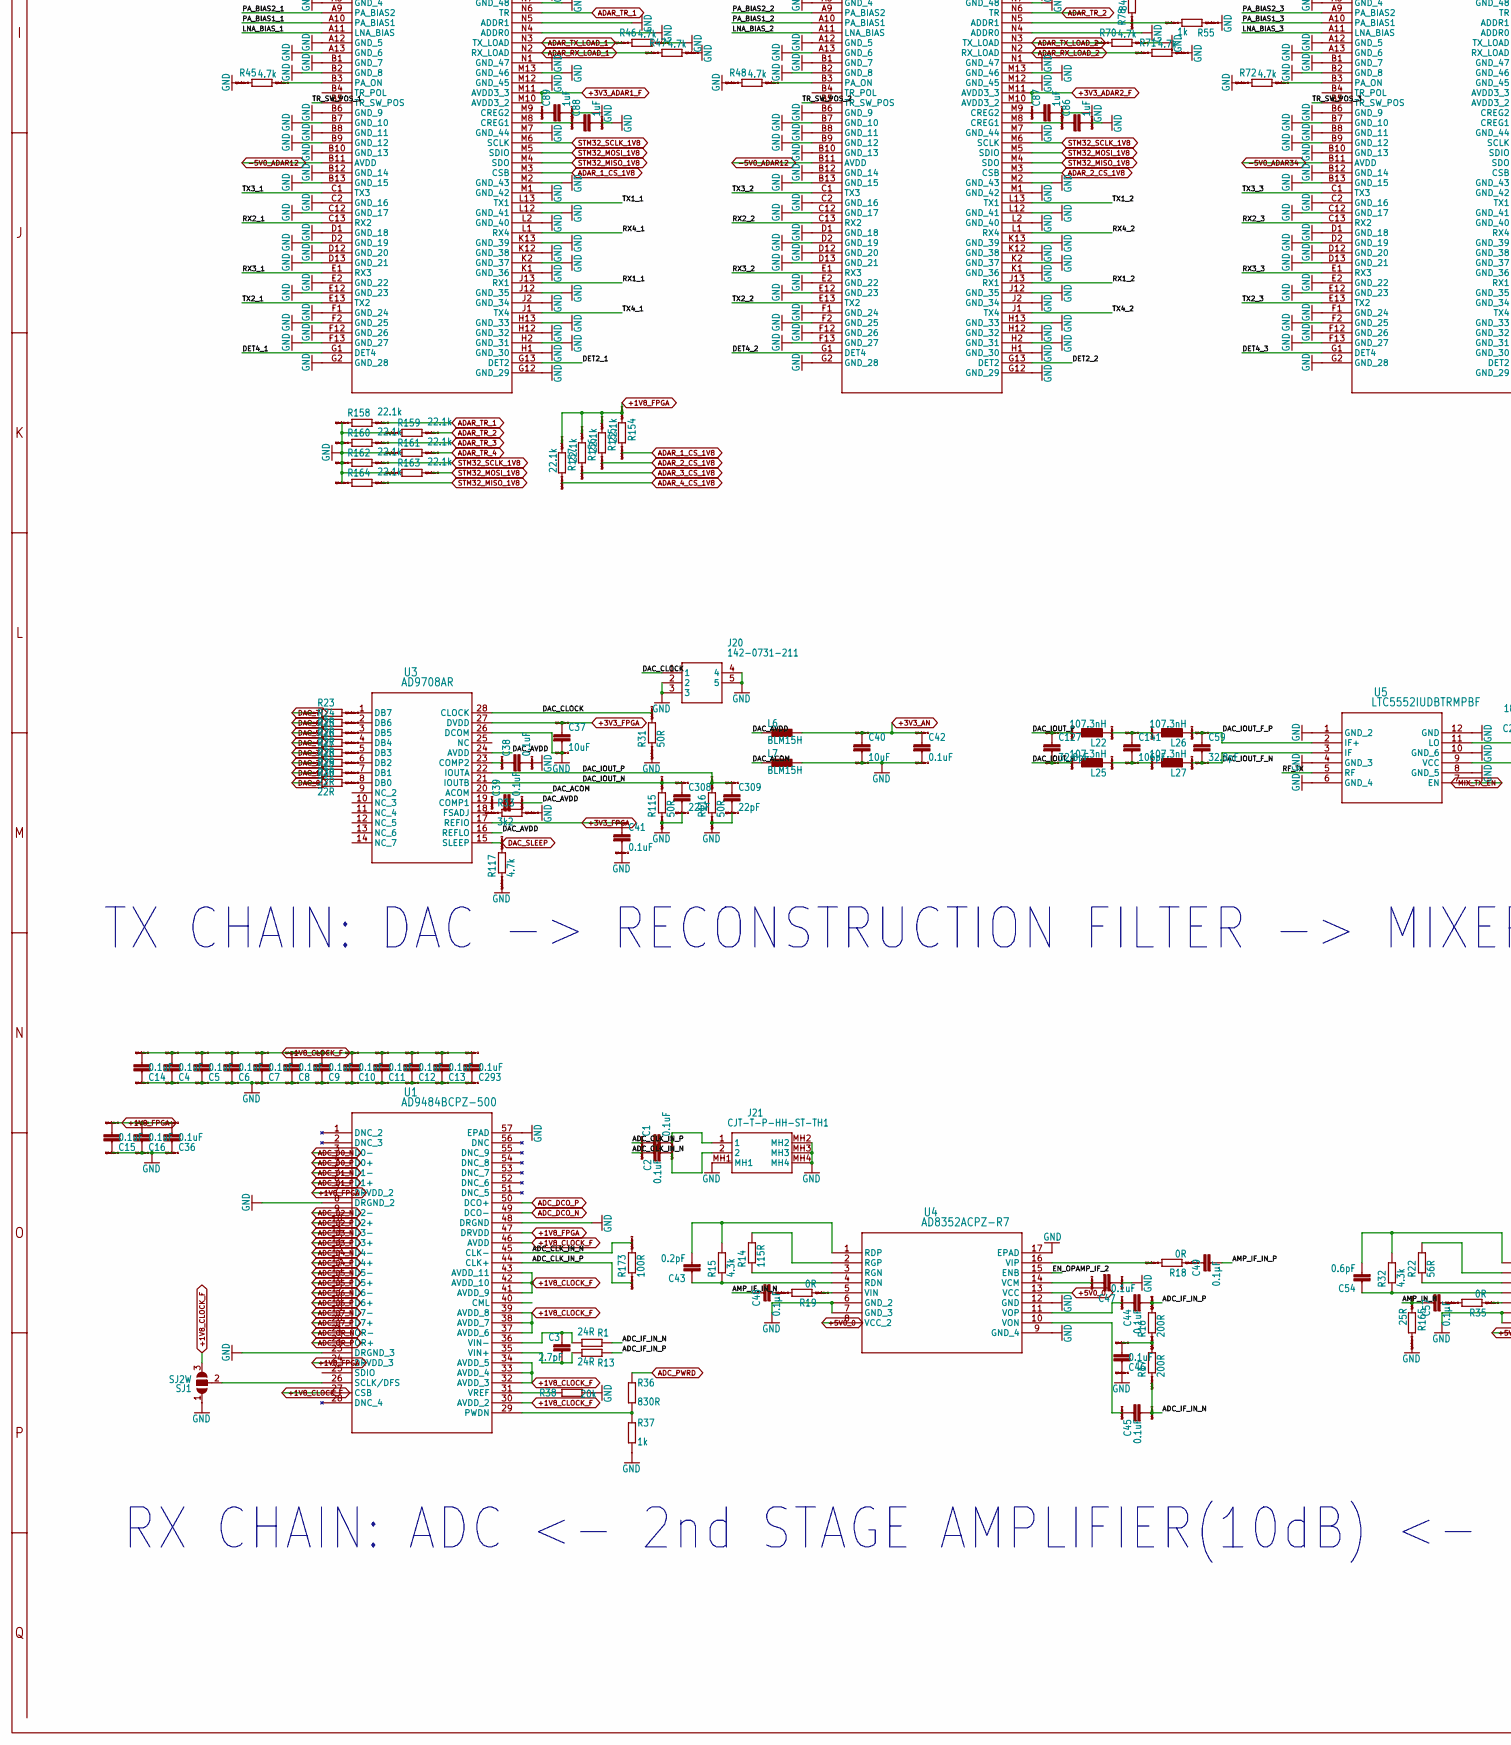
[picture p22: schematic RADAR_Main_Board_3.kicad_sch, part in row 2, column 1]

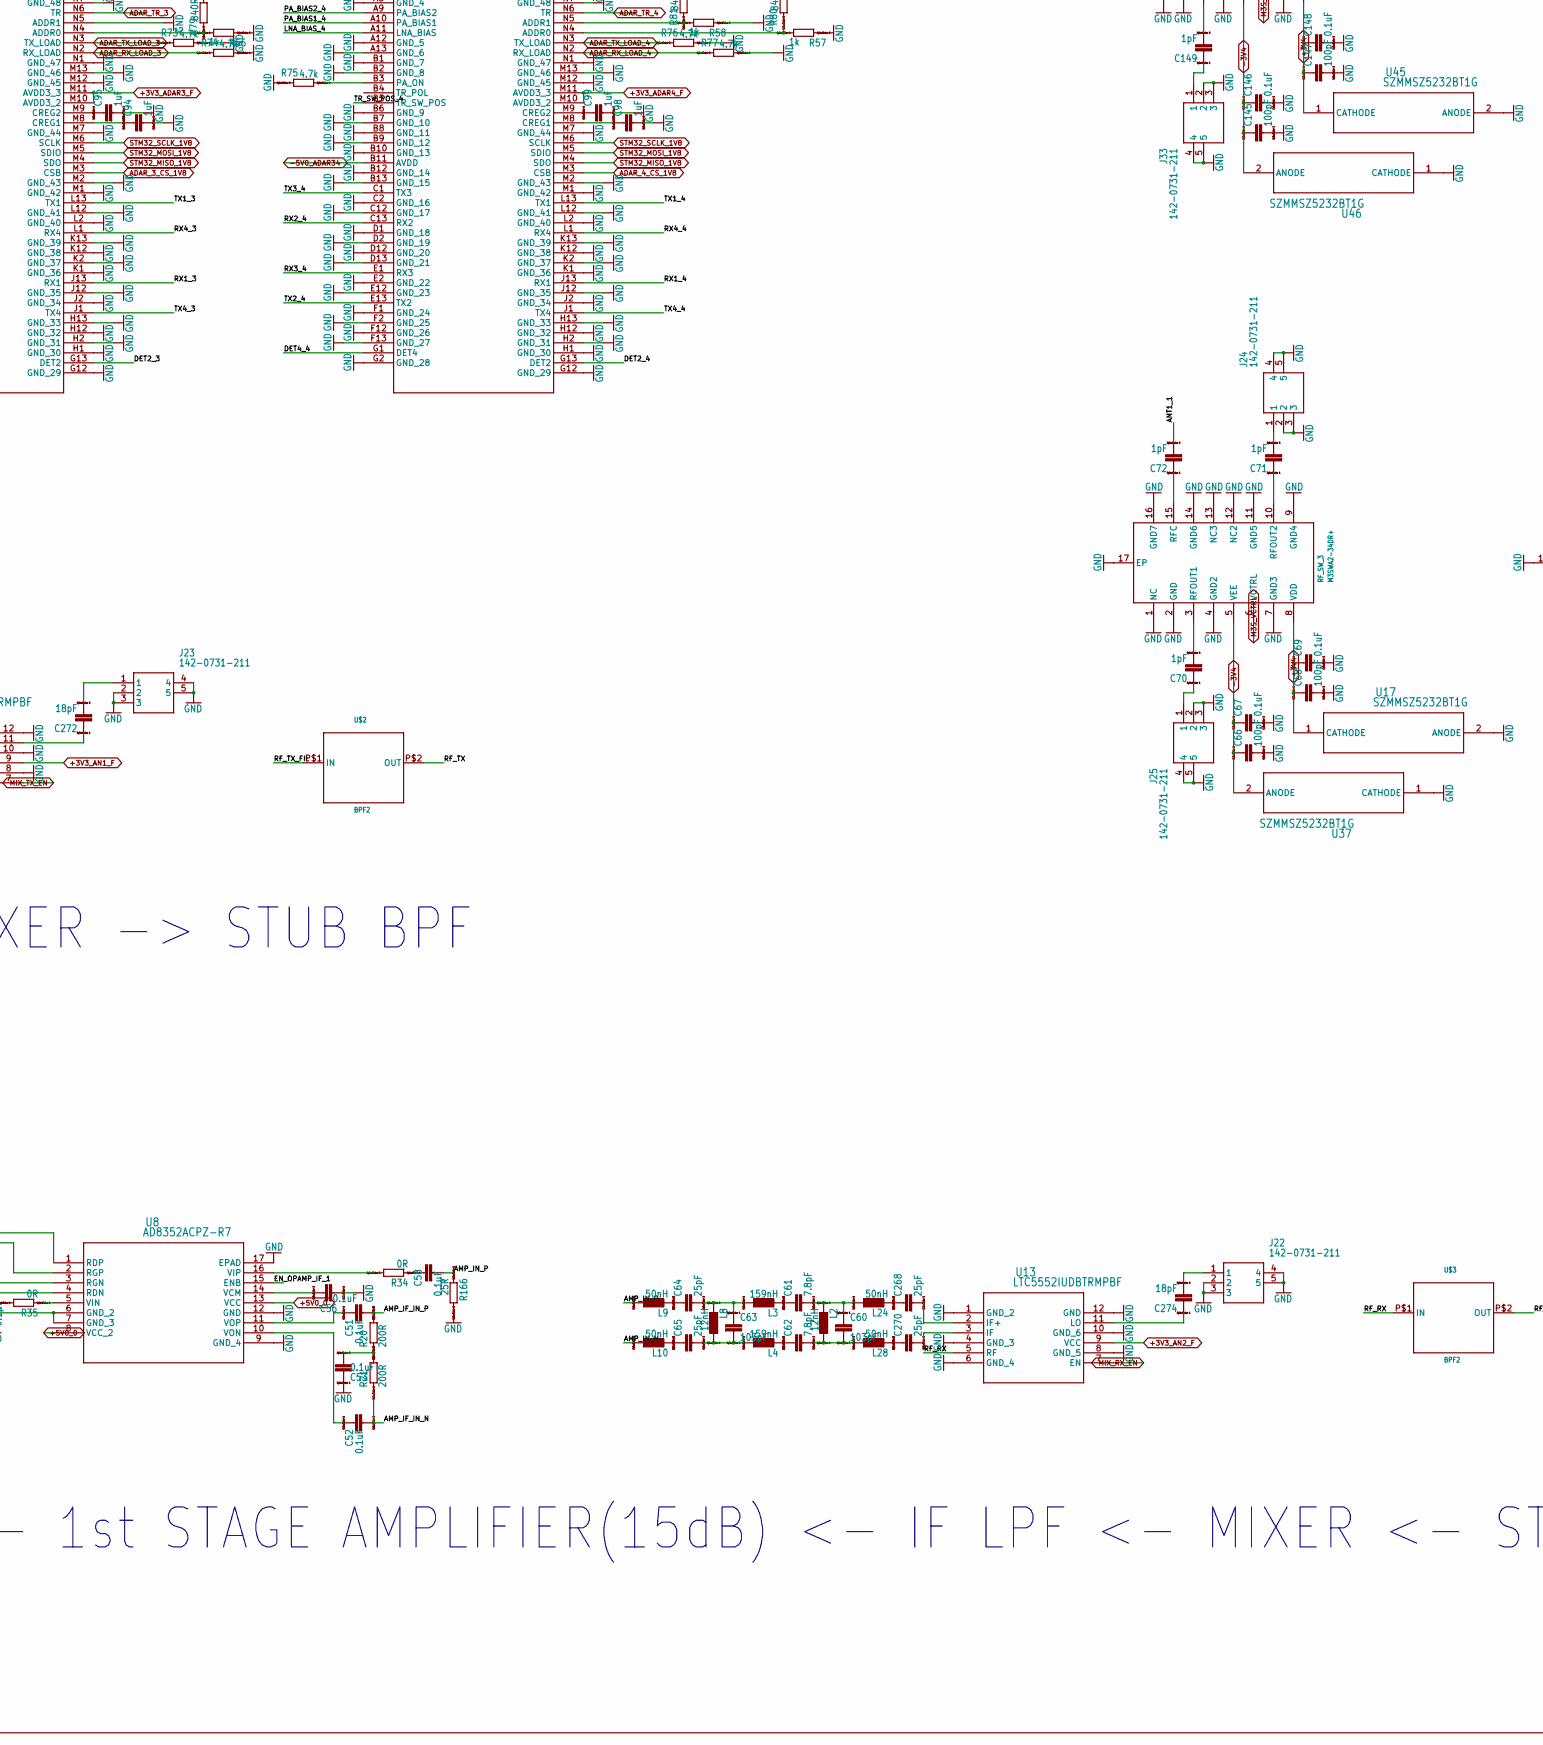
[picture p23: schematic RADAR_Main_Board_3.kicad_sch, part in row 2, column 2]

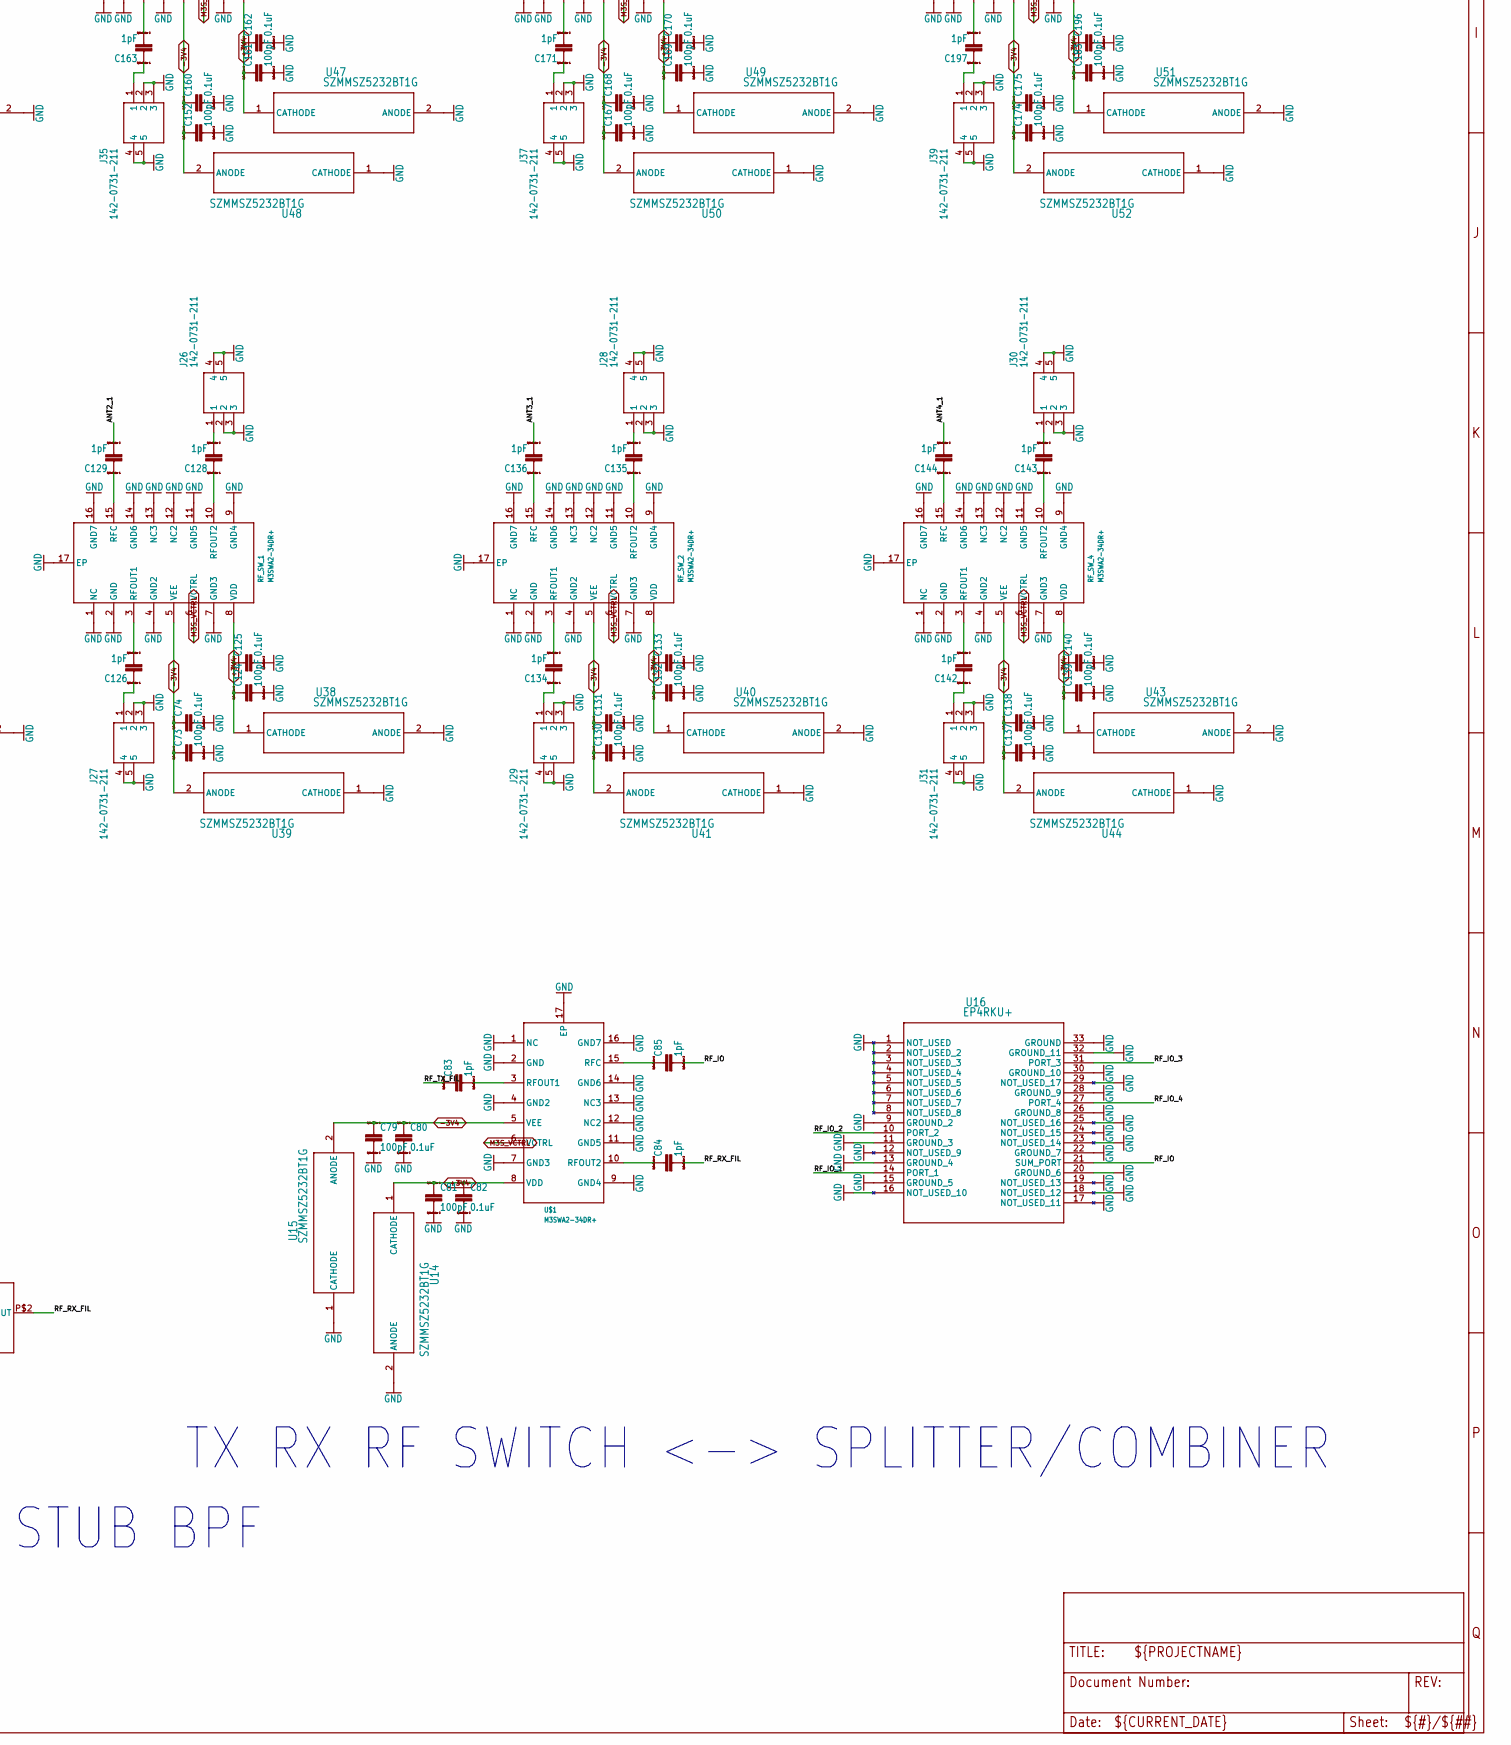
[picture p24: schematic RADAR_Main_Board_3.kicad_sch, part in row 2, column 3]

Parts:
ADAR1_0, ADAR2_0, ADAR3_0, ADAR4_0: ADAR1000ACCZN; CC-88-1_ADI
ADTR1107_1, ADTR1107_2, ADTR1107_3, ADTR1107_4, ADTR1107_5, ADTR1107_6, ADTR1107_7, ADTR1107_8, ADTR1107_9, ADTR1107_10, ADTR1107_11, ADTR1107_12, ADTR1107_13, ADTR1107_14, ADTR1107_15, ADTR1107_16: ADTR1107ACCZ; CC-24-8_ADI
C1, C2, C4, C5, C6, C7, C8, C9, C10, C11, C12, C13, C14, C15, C16, C36, C38, C39, C41, C42, C44, C45, C46, C47, C51, C52, C53, C56, C67, C69, C74, C80, C82, C125, C131, C133, C138, C140, C146, C148, C160, C162, C168, C170, C175, C196, C201, C203, C208, C210, C215, C217, C222, C224, C229, C231, C236, C238, C243, C245, C250, C252, C293: 0.1uF; C0201
C3: 2.7pF; C0402
C37, C40: 10uF; C0201
C43: 0.2pF; C0201
C48, C49, C57, C58: 0.1µF; C0402
C54: 0.6pF; C0201
C59, C127: 32.8pF; C0201
C60, C63: 103pF; C0201
C61, C62: 7.8pF; C0201
C64, C65, C268, C270: 25pF; C0201
C66, C68, C73, C79, C81, C124, C130, C132, C137, C139, C145, C147, C152, C161, C167, C169, C174, C183, C200, C202, C207, C209, C214, C216, C221, C223, C228, C230, C235, C237, C242, C244, C249, C251: 100pF; C0201
C70, C71, C72, C83, C84, C85, C126, C128, C129, C134, C135, C136, C142, C143, C144, C149, C150, C151, C163, C165, C166, C171, C172, C173, C197, C198, C199, C204, C205, C206, C211, C212, C213, C218, C219, C220, C225, C226, C227, C232, C233, C234, C239, C240, C241, C246, C247, C248, C253, C254, C255: 1pF; C0201
C86, C87, C88, C89, C90, C91, C92, C93, C94, C95, C96, C97, C98, C99, C100, C101: 1uF; C0201
C102, C103, C104, C105, C106, C107, C114, C115, C116, C117, C118, C119, C120, C121, C122, C123: 10nF; C0201
C141: 106pF; C0201
C272, C274: 18pF; C0201
C308, C309: 22pF; C0201
J20, J22, J23, J24, J25, J26, J27, J28, J29, J30, J31, J32, J33, J34, J35, J36, J37, J38, J39, J40, J41, J42, J43, J44, J45, J46, J47, J48, J49, J50, J51, J52, J53, J54, J55: 142-0731-211; 1420731211
J21: CJT-T-P-HH-ST-TH1; CJTTPHHSTTH1
L2, L8: 12nH; L0201
L3, L4: 159nH; L0201
L6, L7: BLM15H; 0402
L9, L10, L24, L28: 50nH; L0201
L22, L25, L26, L27: 107.3nH; L0201
R1, R13: 24R; R0402
R14: 115R; R0201
R15, R32: 4.3k; R0201
R16, R17, R20, R21: 200R; R0201
R18, R19, R34, R35: 0R; R0201
R22: 56R; R0201
R23, R24, R25, R26, R27, R28, R29, R30: 22R; R0201
R31, R115, R116: 50R; R0201
R33: 3k2; R0201
R36: 830R; R0402
R37: 1k; R0402
R38: 20k; R0402
R45, R46, R47, R48, R70, R71, R72, R73, R74, R75, R76, R77, R117: 4.7k; R0201
R55, R56, R57, R58: 1k; R0201
R78, R79, R80, R81: 840R; R0201
R154, R155, R156, R157, R158, R159, R160, R161, R162, R163, R164: 22.1k; R0201
R165, R166: 25R; R0201
R173: 100R; R0201
RF_SW_1, RF_SW_2, RF_SW_3, RF_SW_4, RF_SW_5, RF_SW_6, RF_SW_7, RF_SW_8, RF_SW_9, RF_SW_10, RF_SW_11, RF_SW_12, RF_SW_13, RF_SW_14, RF_SW_15, RF_SW_16: M3SWA2-34DR+; 16_QFN
SJ1: SJ2W; SJ_2
U1: AD9484BCPZ-500; CP_56_5_ADI
U3: AD9708AR; RW_28_ADI
U4, U8: AD8352ACPZ-R7; CP_16_3_ADI
U5, U13: LTC5552IUDBTRMPBF; UDB_12_ADI
U14, U15, U17, U37, U38, U39, U40, U41, U43, U44, U45, U46, U47, U48, U49, U50, U51, U52, U53, U54, U55, U56, U57, U58, U59, U60, U61, U62, U63, U64, U65, U66, U67, U68: SZMMSZ5232BT1G; SOD-123_ONS
U16: EP4RKU+; DG1677-2_MNC
U$1: M3SWA2-34DR+; 16_QFN
U$2, U$3: BPF2

Connections:
+1V8_CLOCK_F: C4.2, C5.2, C6.2, C7.2, C8.2, C9.2, C10.2, C11.2, C12.2, C13.2, C14.2, C293.2, SJ1.3, U1.27 (CSB), U1.30 (AVDD_2), U1.32 (AVDD_3), U1.33 (AVDD_4), U1.34 (AVDD_5), U1.37 (AVDD_6), U1.38 (AVDD_7), U1.39 (AVDD_8), U1.41 (AVDD_9), U1.42 (AVDD_10), U1.43 (AVDD_11), U1.46 (AVDD)
+1V8_FPGA: C15.2, C16.2, C36.2, R154.1, R155.1, R156.1, R157.1, U1.7 (DRVDD_2), U1.24 (DRVDD_3), U1.47 (DRVDD)
+3V3_ADAR1_F: ADAR1_0.M10 (AVDD3_2), ADAR1_0.M11 (AVDD3_3), ADAR1_0.N11 (AVDD3)
+3V3_ADAR2_F: ADAR2_0.M10 (AVDD3_2), ADAR2_0.M11 (AVDD3_3), ADAR2_0.N11 (AVDD3), R78.1
+3V3_ADAR3_F: ADAR3_0.M10 (AVDD3_2), ADAR3_0.M11 (AVDD3_3), ADAR3_0.N11 (AVDD3), R79.1
+3V3_ADAR4_F: ADAR4_0.M10 (AVDD3_2), ADAR4_0.M11 (AVDD3_3), ADAR4_0.N11 (AVDD3), R80.1, R81.1
+3V3_ADTR: ADTR1107_1.24 (VDD_LNA), ADTR1107_2.24 (VDD_LNA), ADTR1107_3.24 (VDD_LNA), ADTR1107_4.24 (VDD_LNA), ADTR1107_5.24 (VDD_LNA), ADTR1107_6.24 (VDD_LNA), ADTR1107_7.24 (VDD_LNA), ADTR1107_8.24 (VDD_LNA), ADTR1107_9.24 (VDD_LNA), ADTR1107_10.24 (VDD_LNA), ADTR1107_11.24 (VDD_LNA), ADTR1107_12.24 (VDD_LNA), ADTR1107_13.24 (VDD_LNA), ADTR1107_14.24 (VDD_LNA), ADTR1107_15.24 (VDD_LNA), ADTR1107_16.24 (VDD_LNA)
+3V3_AN: C40.1, C42.1, L6.2
+3V3_AN1_F: U5.9 (VCC)
+3V3_AN2_F: U13.9 (VCC)
+3V3_FPGA: C37.1, C41.1, U3.17 (REFIO), U3.27 (DVDD)
+3V3_VDD_SW: ADTR1107_1.19 (VDD_SW), ADTR1107_2.19 (VDD_SW), ADTR1107_3.19 (VDD_SW), ADTR1107_4.19 (VDD_SW), ADTR1107_5.19 (VDD_SW), ADTR1107_6.19 (VDD_SW), ADTR1107_7.19 (VDD_SW), ADTR1107_8.19 (VDD_SW), ADTR1107_9.19 (VDD_SW), ADTR1107_10.19 (VDD_SW), ADTR1107_11.19 (VDD_SW), ADTR1107_12.19 (VDD_SW), ADTR1107_13.19 (VDD_SW), ADTR1107_14.19 (VDD_SW), ADTR1107_15.19 (VDD_SW), ADTR1107_16.19 (VDD_SW)
+3V4: C68.1, C69.1, C81.1, C82.1, C124.1, C125.1, C132.1, C133.1, C139.1, C140.1, C147.1, C148.1, C161.1, C162.1, C169.1, C170.1, C183.1, C196.1, C202.1, C203.1, C209.1, C210.1, C216.1, C217.1, C223.1, C224.1, C230.1, C231.1, C237.1, C238.1, C244.1, C245.1, C251.1, C252.1, RF_SW_1.8 (VDD), RF_SW_2.8 (VDD), RF_SW_3.8 (VDD), RF_SW_4.8 (VDD), RF_SW_5.8 (VDD), RF_SW_6.8 (VDD), RF_SW_7.8 (VDD), RF_SW_8.8 (VDD), RF_SW_9.8 (VDD), RF_SW_10.8 (VDD), RF_SW_11.8 (VDD), RF_SW_12.8 (VDD), RF_SW_13.8 (VDD), RF_SW_14.8 (VDD), RF_SW_15.8 (VDD), RF_SW_16.8 (VDD), U14.1 (CATHODE), U17.1 (CATHODE), U38.1 (CATHODE), U40.1 (CATHODE), U43.1 (CATHODE), U45.1 (CATHODE), U47.1 (CATHODE), U49.1 (CATHODE), U51.1 (CATHODE), U53.1 (CATHODE), U55.1 (CATHODE), U57.1 (CATHODE), U59.1 (CATHODE), U61.1 (CATHODE), U63.1 (CATHODE), U65.1 (CATHODE), U67.1 (CATHODE), U$1.8 (VDD)
+5V0_0: U4.8 (VCC_2), U4.13 (VCC), U8.8 (VCC_2), U8.13 (VCC)
+5V0_PA_1: ADTR1107_1.8 (VDD_PA), ADTR1107_2.8 (VDD_PA), ADTR1107_3.8 (VDD_PA), ADTR1107_4.8 (VDD_PA), ADTR1107_7.8 (VDD_PA)
+5V0_PA_2: ADTR1107_5.8 (VDD_PA), ADTR1107_6.8 (VDD_PA), ADTR1107_8.8 (VDD_PA), ADTR1107_10.8 (VDD_PA), ADTR1107_12.8 (VDD_PA)
+5V0_PA_3: ADTR1107_9.8 (VDD_PA), ADTR1107_11.8 (VDD_PA), ADTR1107_13.8 (VDD_PA), ADTR1107_14.8 (VDD_PA), ADTR1107_15.8 (VDD_PA), ADTR1107_16.8 (VDD_PA)
-3V3_SW: ADTR1107_1.21 (VSS_SW), ADTR1107_2.21 (VSS_SW), ADTR1107_3.21 (VSS_SW), ADTR1107_4.21 (VSS_SW), ADTR1107_5.21 (VSS_SW), ADTR1107_6.21 (VSS_SW), ADTR1107_7.21 (VSS_SW), ADTR1107_8.21 (VSS_SW), ADTR1107_9.21 (VSS_SW), ADTR1107_10.21 (VSS_SW), ADTR1107_11.21 (VSS_SW), ADTR1107_12.21 (VSS_SW), ADTR1107_13.21 (VSS_SW), ADTR1107_14.21 (VSS_SW), ADTR1107_15.21 (VSS_SW), ADTR1107_16.21 (VSS_SW)
-3V4: C66.1, C67.1, C73.1, C74.1, C79.1, C80.1, C130.1, C131.1, C137.1, C138.1, C145.1, C146.1, C152.1, C160.1, C167.1, C168.1, C174.1, C175.1, C200.1, C201.1, C207.1, C208.1, C214.1, C215.1, C221.1, C222.1, C228.1, C229.1, C235.1, C236.1, C242.1, C243.1, C249.1, C250.1, RF_SW_1.5 (VEE), RF_SW_2.5 (VEE), RF_SW_3.5 (VEE), RF_SW_4.5 (VEE), RF_SW_5.5 (VEE), RF_SW_6.5 (VEE), RF_SW_7.5 (VEE), RF_SW_8.5 (VEE), RF_SW_9.5 (VEE), RF_SW_10.5 (VEE), RF_SW_11.5 (VEE), RF_SW_12.5 (VEE), RF_SW_13.5 (VEE), RF_SW_14.5 (VEE), RF_SW_15.5 (VEE), RF_SW_16.5 (VEE), U15.2 (ANODE), U37.2 (ANODE), U39.2 (ANODE), U41.2 (ANODE), U44.2 (ANODE), U46.2 (ANODE), U48.2 (ANODE), U50.2 (ANODE), U52.2 (ANODE), U54.2 (ANODE), U56.2 (ANODE), U58.2 (ANODE), U60.2 (ANODE), U62.2 (ANODE), U64.2 (ANODE), U66.2 (ANODE), U68.2 (ANODE), U$1.5 (VEE)
-5V0_ADAR12: ADAR1_0.B11 (AVDD), ADAR2_0.B11 (AVDD)
-5V0_ADAR34: ADAR3_0.B11 (AVDD), ADAR4_0.B11 (AVDD)
ADAR_1_CS_1V8: ADAR1_0.M3 (CSB), R154.2
ADAR_2_CS_1V8: ADAR2_0.M3 (CSB), R155.2
ADAR_3_CS_1V8: ADAR3_0.M3 (CSB), R156.2
ADAR_4_CS_1V8: ADAR4_0.M3 (CSB), R157.2
ADAR_RX_LOAD_1: ADAR1_0.N2 (RX_LOAD), R47.2
ADAR_RX_LOAD_2: ADAR2_0.N2 (RX_LOAD), R71.2
ADAR_RX_LOAD_3: ADAR3_0.N2 (RX_LOAD), R74.2
ADAR_RX_LOAD_4: ADAR4_0.N2 (RX_LOAD), R77.2
ADAR_TR_1: ADAR1_0.N6 (TR), R158.2
ADAR_TR_2: ADAR2_0.N6 (TR), R159.2
ADAR_TR_3: ADAR3_0.N6 (TR), R160.2
ADAR_TR_4: ADAR4_0.N6 (TR), R161.2
ADAR_TX_LOAD_1: ADAR1_0.N3 (TX_LOAD), R46.2
ADAR_TX_LOAD_2: ADAR2_0.N3 (TX_LOAD), R70.2
ADAR_TX_LOAD_3: ADAR3_0.N3 (TX_LOAD), R73.2
ADAR_TX_LOAD_4: ADAR4_0.N3 (TX_LOAD), R76.2
ADC_CLK_IN_N: C2.1, R173.2, U1.45 (CLK-)
ADC_CLK_IN_P: C1.1, R173.1, U1.44 (CLK+)
ADC_D0_N: U1.3 (D0-)
ADC_D0_P: U1.4 (D0+)
ADC_D1_N: U1.5 (D1-)
ADC_D1_P: U1.6 (D1+)
ADC_D2_N: U1.9 (D2-)
ADC_D2_P: U1.10 (D2+)
ADC_D3_N: U1.11 (D3-)
ADC_D3_P: U1.12 (D3+)
ADC_D4_N: U1.13 (D4-)
ADC_D4_P: U1.14 (D4+)
ADC_D5_N: U1.15 (D5-)
ADC_D5_P: U1.16 (D5+)
ADC_D6_N: U1.17 (D6-)
ADC_D6_P: U1.18 (D6+)
ADC_D7_N: U1.19 (D7-)
ADC_D7_P: U1.20 (D7+)
ADC_DCO_N: U1.49 (DCO-)
ADC_DCO_P: U1.50 (DCO+)
ADC_IF_IN_N: C45.2, R1.2, R17.1
ADC_IF_IN_P: C44.2, R13.2, R16.2
ADC_OR_N: U1.21 (OR-)
ADC_OR_P: U1.22 (OR+)
ADC_PWRD: R36.2
AMP_IF_IN_N: C48.1, C52.2, R21.1
AMP_IF_IN_P: C49.2, C51.2, R20.2
AMP_IN_N: C57.1, L10.1, R165.1
AMP_IN_P: C58.2, L9.1, R166.1
ANT1_1: ADTR1107_3.17 (ANT), C72.2
ANT1_2: ADTR1107_7.17 (ANT), C151.2
ANT1_3: ADTR1107_10.17 (ANT), C206.2
ANT1_4: ADTR1107_14.17 (ANT), C234.2
ANT2_1: ADTR1107_1.17 (ANT), C129.2
ANT2_2: ADTR1107_5.17 (ANT), C166.2
ANT2_3: ADTR1107_12.17 (ANT), C213.2
ANT2_4: ADTR1107_16.17 (ANT), C241.2
ANT3_1: ADTR1107_2.17 (ANT), C136.2
ANT3_2: ADTR1107_6.17 (ANT), C173.2
ANT3_3: ADTR1107_11.17 (ANT), C220.2
ANT3_4: ADTR1107_15.17 (ANT), C248.2
ANT4_1: ADTR1107_4.17 (ANT), C144.2
ANT4_2: ADTR1107_8.17 (ANT), C199.2
ANT4_3: ADTR1107_9.17 (ANT), C227.2
ANT4_4: ADTR1107_13.17 (ANT), C255.2
DAC_0: R30.1
DAC_1: R29.1
DAC_2: R28.1
DAC_3: R27.1
DAC_4: R26.1
DAC_5: R25.1
DAC_6: R24.1
DAC_7: R23.1
DAC_ACOM: L7.1, U3.20 (ACOM)
DAC_AVDD: C39.2, L6.1, U3.16 (REFLO), U3.24 (AVDD)
DAC_CLOCK: J20.1, R31.2, U3.28 (CLOCK)
DAC_IOUT_F_N: C59.2, L27.2, U5.3 (IF)
DAC_IOUT_F_P: C59.1, L26.2, U5.2 (IF+)
DAC_IOUT_N: C127.2, C308.1, L25.1, R115.2, U3.21 (IOUTB)
DAC_IOUT_P: C127.1, C309.1, L22.1, R116.2, U3.22 (IOUTA)
DAC_SLEEP: R117.2, U3.15 (SLEEP)
DET1_1: ADAR1_0.N13 (DET1), ADTR1107_3.12 (CPLR_OUT)
DET1_2: ADAR2_0.N13 (DET1), ADTR1107_7.12 (CPLR_OUT)
DET1_3: ADAR3_0.N13 (DET1), ADTR1107_10.12 (CPLR_OUT)
DET1_4: ADAR4_0.N13 (DET1), ADTR1107_14.12 (CPLR_OUT)
DET2_1: ADAR1_0.G13 (DET2), ADTR1107_1.12 (CPLR_OUT)
DET2_2: ADAR2_0.G13 (DET2), ADTR1107_5.12 (CPLR_OUT)
DET2_3: ADAR3_0.G13 (DET2), ADTR1107_12.12 (CPLR_OUT)
DET2_4: ADAR4_0.G13 (DET2), ADTR1107_16.12 (CPLR_OUT)
DET3_1: ADAR1_0.A1 (DET3), ADTR1107_2.12 (CPLR_OUT)
DET3_2: ADAR2_0.A1 (DET3), ADTR1107_6.12 (CPLR_OUT)
DET3_3: ADAR3_0.A1 (DET3), ADTR1107_11.12 (CPLR_OUT)
DET3_4: ADAR4_0.A1 (DET3), ADTR1107_15.12 (CPLR_OUT)
DET4_1: ADAR1_0.G1 (DET4), ADTR1107_4.12 (CPLR_OUT)
DET4_2: ADAR2_0.G1 (DET4), ADTR1107_8.12 (CPLR_OUT)
DET4_3: ADAR3_0.G1 (DET4), ADTR1107_9.12 (CPLR_OUT)
DET4_4: ADAR4_0.G1 (DET4), ADTR1107_13.12 (CPLR_OUT)
EN_OPAMP_IF_1: U8.15 (ENB)
EN_OPAMP_IF_2: U4.15 (ENB)
GND: ADAR1_0.89 (GND), ADAR1_0.A2 (GND_2), ADAR1_0.A6 (GND_3), ADAR1_0.A8 (GND_4), ADAR1_0.A12 (GND_5), ADAR1_0.A13 (GND_6), ADAR1_0.B1 (GND_7), ADAR1_0.B2 (GND_8), ADAR1_0.B6 (GND_9), ADAR1_0.B7 (GND_10), ADAR1_0.B8 (GND_11), ADAR1_0.B9 (GND_12), ADAR1_0.B10 (GND_13), ADAR1_0.B12 (GND_14), ADAR1_0.B13 (GND_15), ADAR1_0.C2 (GND_16), ADAR1_0.C12 (GND_17), ADAR1_0.D1 (GND_18), ADAR1_0.D2 (GND_19), ADAR1_0.D12 (GND_20), ADAR1_0.D13 (GND_21), ADAR1_0.E2 (GND_22), ADAR1_0.E12 (GND_23), ADAR1_0.F1 (GND_24), ADAR1_0.F2 (GND_25), ADAR1_0.F12 (GND_26), ADAR1_0.F13 (GND_27), ADAR1_0.G2 (GND_28), ADAR1_0.G12 (GND_29), ADAR1_0.H1 (GND_30), ADAR1_0.H2 (GND_31), ADAR1_0.H12 (GND_32), ADAR1_0.H13 (GND_33), ADAR1_0.J2 (GND_34), ADAR1_0.J12 (GND_35), ADAR1_0.K1 (GND_36), ADAR1_0.K2 (GND_37), ADAR1_0.K12 (GND_38), ADAR1_0.K13 (GND_39), ADAR1_0.L2 (GND_40), ADAR1_0.L12 (GND_41), ADAR1_0.M1 (GND_42), ADAR1_0.M2 (GND_43), ADAR1_0.M7 (GND_44), ADAR1_0.M12 (GND_45), ADAR1_0.M13 (GND_46), ADAR1_0.N1 (GND_47), ADAR1_0.N4 (ADDR0), ADAR1_0.N5 (ADDR1), ADAR1_0.N7 (GND_48), ADAR1_0.N8 (GND_49), ADAR1_0.N12 (GND_50), ADAR2_0.89 (GND), ADAR2_0.A2 (GND_2), ADAR2_0.A6 (GND_3), ADAR2_0.A8 (GND_4), ADAR2_0.A12 (GND_5), ADAR2_0.A13 (GND_6), ADAR2_0.B1 (GND_7), ADAR2_0.B2 (GND_8), ADAR2_0.B6 (GND_9), ADAR2_0.B7 (GND_10), ADAR2_0.B8 (GND_11), ADAR2_0.B9 (GND_12), ADAR2_0.B10 (GND_13), ADAR2_0.B12 (GND_14), ADAR2_0.B13 (GND_15), ADAR2_0.C2 (GND_16), ADAR2_0.C12 (GND_17), ADAR2_0.D1 (GND_18), ADAR2_0.D2 (GND_19), ADAR2_0.D12 (GND_20), ADAR2_0.D13 (GND_21), ADAR2_0.E2 (GND_22), ADAR2_0.E12 (GND_23), ADAR2_0.F1 (GND_24), ADAR2_0.F2 (GND_25), ADAR2_0.F12 (GND_26), ADAR2_0.F13 (GND_27), ADAR2_0.G2 (GND_28), ADAR2_0.G12 (GND_29), ADAR2_0.H1 (GND_30), ADAR2_0.H2 (GND_31), ADAR2_0.H12 (GND_32), ADAR2_0.H13 (GND_33), ADAR2_0.J2 (GND_34), ADAR2_0.J12 (GND_35), ADAR2_0.K1 (GND_36), ADAR2_0.K2 (GND_37), ADAR2_0.K12 (GND_38), ADAR2_0.K13 (GND_39), ADAR2_0.L2 (GND_40), ADAR2_0.L12 (GND_41), ADAR2_0.M1 (GND_42), ADAR2_0.M2 (GND_43), ADAR2_0.M7 (GND_44), ADAR2_0.M12 (GND_45), ADAR2_0.M13 (GND_46), ADAR2_0.N1 (GND_47), ADAR2_0.N4 (ADDR0), ADAR2_0.N7 (GND_48), ADAR2_0.N8 (GND_49), ADAR2_0.N12 (GND_50), ADAR3_0.89 (GND), ADAR3_0.A2 (GND_2), ADAR3_0.A6 (GND_3), ADAR3_0.A8 (GND_4), ADAR3_0.A12 (GND_5), ADAR3_0.A13 (GND_6), ADAR3_0.B1 (GND_7), ADAR3_0.B2 (GND_8), ADAR3_0.B6 (GND_9), ADAR3_0.B7 (GND_10), ADAR3_0.B8 (GND_11), ADAR3_0.B9 (GND_12), ADAR3_0.B10 (GND_13), ADAR3_0.B12 (GND_14), ADAR3_0.B13 (GND_15), ADAR3_0.C2 (GND_16), ADAR3_0.C12 (GND_17), ADAR3_0.D1 (GND_18), ADAR3_0.D2 (GND_19), ADAR3_0.D12 (GND_20), ADAR3_0.D13 (GND_21), ADAR3_0.E2 (GND_22), ADAR3_0.E12 (GND_23), ADAR3_0.F1 (GND_24), ADAR3_0.F2 (GND_25), ADAR3_0.F12 (GND_26), ADAR3_0.F13 (GND_27), ADAR3_0.G2 (GND_28), ADAR3_0.G12 (GND_29), ADAR3_0.H1 (GND_30), ADAR3_0.H2 (GND_31), ADAR3_0.H12 (GND_32), ADAR3_0.H13 (GND_33), ADAR3_0.J2 (GND_34), ADAR3_0.J12 (GND_35), ADAR3_0.K1 (GND_36), ADAR3_0.K2 (GND_37), ADAR3_0.K12 (GND_38), ADAR3_0.K13 (GND_39), ADAR3_0.L2 (GND_40), ADAR3_0.L12 (GND_41), ADAR3_0.M1 (GND_42), ADAR3_0.M2 (GND_43), ADAR3_0.M7 (GND_44), ADAR3_0.M12 (GND_45), ADAR3_0.M13 (GND_46), ADAR3_0.N1 (GND_47), ADAR3_0.N5 (ADDR1), ADAR3_0.N7 (GND_48), ADAR3_0.N8 (GND_49), ADAR3_0.N12 (GND_50), ADAR4_0.89 (GND), ADAR4_0.A2 (GND_2), ADAR4_0.A6 (GND_3), ADAR4_0.A8 (GND_4), ADAR4_0.A12 (GND_5), ADAR4_0.A13 (GND_6), ADAR4_0.B1 (GND_7), ADAR4_0.B2 (GND_8), ADAR4_0.B6 (GND_9), ADAR4_0.B7 (GND_10), ADAR4_0.B8 (GND_11), ADAR4_0.B9 (GND_12), ADAR4_0.B10 (GND_13), ADAR4_0.B12 (GND_14), ADAR4_0.B13 (GND_15), ADAR4_0.C2 (GND_16), ADAR4_0.C12 (GND_17), ADAR4_0.D1 (GND_18), ADAR4_0.D2 (GND_19), ADAR4_0.D12 (GND_20), ADAR4_0.D13 (GND_21), ADAR4_0.E2 (GND_22), ADAR4_0.E12 (GND_23), ADAR4_0.F1 (GND_24), ADAR4_0.F2 (GND_25), ADAR4_0.F12 (GND_26), ADAR4_0.F13 (GND_27), ADAR4_0.G2 (GND_28), ADAR4_0.G12 (GND_29), ADAR4_0.H1 (GND_30), ADAR4_0.H2 (GND_31), ADAR4_0.H12 (GND_32), ADAR4_0.H13 (GND_33), ADAR4_0.J2 (GND_34), ADAR4_0.J12 (GND_35), ADAR4_0.K1 (GND_36), ADAR4_0.K2 (GND_37), ADAR4_0.K12 (GND_38), ADAR4_0.K13 (GND_39), ADAR4_0.L2 (GND_40), ADAR4_0.L12 (GND_41), ADAR4_0.M1 (GND_42), ADAR4_0.M2 (GND_43), ADAR4_0.M7 (GND_44), ADAR4_0.M12 (GND_45), ADAR4_0.M13 (GND_46), ADAR4_0.N1 (GND_47), ADAR4_0.N7 (GND_48), ADAR4_0.N8 (GND_49), ADAR4_0.N12 (GND_50), ADTR1107_1.1 (GND_2), ADTR1107_1.3 (GND_3), ADTR1107_1.4 (GND_4), ADTR1107_1.6 (GND_5), ADTR1107_1.9 (NIC_2), ADTR1107_1.10 (NIC), ADTR1107_1.11 (GND_6), ADTR1107_1.13 (GND_7), ADTR1107_1.14 (GND_8), ADTR1107_1.15 (GND_9), ADTR1107_1.16 (GND_10), ADTR1107_1.18 (GND_11), ADTR1107_1.22 (GND_12), ADTR1107_1.25 (GND), ADTR1107_2.1 (GND_2), ADTR1107_2.3 (GND_3), ADTR1107_2.4 (GND_4), ADTR1107_2.6 (GND_5), ADTR1107_2.9 (NIC_2), ADTR1107_2.10 (NIC), ADTR1107_2.11 (GND_6), ADTR1107_2.13 (GND_7), ADTR1107_2.14 (GND_8), ADTR1107_2.15 (GND_9), ADTR1107_2.16 (GND_10), ADTR1107_2.18 (GND_11), ADTR1107_2.22 (GND_12), ADTR1107_2.25 (GND), ADTR1107_3.1 (GND_2), ADTR1107_3.3 (GND_3), ADTR1107_3.4 (GND_4), ADTR1107_3.6 (GND_5), ADTR1107_3.9 (NIC_2), ADTR1107_3.10 (NIC), ADTR1107_3.11 (GND_6), ADTR1107_3.13 (GND_7), ADTR1107_3.14 (GND_8), ADTR1107_3.15 (GND_9), ADTR1107_3.16 (GND_10), ADTR1107_3.18 (GND_11), ADTR1107_3.22 (GND_12), ADTR1107_3.25 (GND), ADTR1107_4.1 (GND_2), ADTR1107_4.3 (GND_3), ADTR1107_4.4 (GND_4), ADTR1107_4.6 (GND_5), ADTR1107_4.9 (NIC_2), ADTR1107_4.10 (NIC), ADTR1107_4.11 (GND_6), ADTR1107_4.13 (GND_7), ADTR1107_4.14 (GND_8), ADTR1107_4.15 (GND_9), ADTR1107_4.16 (GND_10), ADTR1107_4.18 (GND_11), ADTR1107_4.22 (GND_12), ADTR1107_4.25 (GND), ADTR1107_5.1 (GND_2), ADTR1107_5.3 (GND_3), ADTR1107_5.4 (GND_4), ADTR1107_5.6 (GND_5), ADTR1107_5.9 (NIC_2), ADTR1107_5.10 (NIC), ADTR1107_5.11 (GND_6), ADTR1107_5.13 (GND_7), ADTR1107_5.14 (GND_8), ADTR1107_5.15 (GND_9), ADTR1107_5.16 (GND_10), ADTR1107_5.18 (GND_11), ADTR1107_5.22 (GND_12), ADTR1107_5.25 (GND), ADTR1107_6.1 (GND_2), ADTR1107_6.3 (GND_3), ADTR1107_6.4 (GND_4), ADTR1107_6.6 (GND_5), ADTR1107_6.9 (NIC_2), ADTR1107_6.10 (NIC), ADTR1107_6.11 (GND_6), ADTR1107_6.13 (GND_7), ADTR1107_6.14 (GND_8), ADTR1107_6.15 (GND_9), ADTR1107_6.16 (GND_10), ADTR1107_6.18 (GND_11), ADTR1107_6.22 (GND_12), ADTR1107_6.25 (GND), ADTR1107_7.1 (GND_2), ADTR1107_7.3 (GND_3), ADTR1107_7.4 (GND_4), ADTR1107_7.6 (GND_5), ADTR1107_7.9 (NIC_2), ADTR1107_7.10 (NIC), ADTR1107_7.11 (GND_6), ADTR1107_7.13 (GND_7), ADTR1107_7.14 (GND_8), ADTR1107_7.15 (GND_9), ADTR1107_7.16 (GND_10), ADTR1107_7.18 (GND_11), ADTR1107_7.22 (GND_12), ADTR1107_7.25 (GND), ADTR1107_8.1 (GND_2), ADTR1107_8.3 (GND_3), ADTR1107_8.4 (GND_4), ADTR1107_8.6 (GND_5), ADTR1107_8.9 (NIC_2), ADTR1107_8.10 (NIC), ADTR1107_8.11 (GND_6), ADTR1107_8.13 (GND_7), ADTR1107_8.14 (GND_8), ADTR1107_8.15 (GND_9), ADTR1107_8.16 (GND_10), ADTR1107_8.18 (GND_11), ADTR1107_8.22 (GND_12), ADTR1107_8.25 (GND), ADTR1107_9.1 (GND_2), ADTR1107_9.3 (GND_3), ADTR1107_9.4 (GND_4), ADTR1107_9.6 (GND_5), ADTR1107_9.9 (NIC_2), ADTR1107_9.10 (NIC), ADTR1107_9.11 (GND_6), ADTR1107_9.13 (GND_7), ADTR1107_9.14 (GND_8), ADTR1107_9.15 (GND_9), ADTR1107_9.16 (GND_10), ADTR1107_9.18 (GND_11), ADTR1107_9.22 (GND_12), ADTR1107_9.25 (GND), ADTR1107_10.1 (GND_2), ADTR1107_10.3 (GND_3), ADTR1107_10.4 (GND_4), ADTR1107_10.6 (GND_5), ADTR1107_10.9 (NIC_2), ADTR1107_10.10 (NIC), ADTR1107_10.11 (GND_6), ADTR1107_10.13 (GND_7), ADTR1107_10.14 (GND_8), ADTR1107_10.15 (GND_9), ADTR1107_10.16 (GND_10), ADTR1107_10.18 (GND_11), ADTR1107_10.22 (GND_12), ADTR1107_10.25 (GND), ADTR1107_11.1 (GND_2), ADTR1107_11.3 (GND_3), ADTR1107_11.4 (GND_4), ADTR1107_11.6 (GND_5), ADTR1107_11.9 (NIC_2), ADTR1107_11.10 (NIC), ADTR1107_11.11 (GND_6), ADTR1107_11.13 (GND_7), ADTR1107_11.14 (GND_8), ADTR1107_11.15 (GND_9), ADTR1107_11.16 (GND_10), ADTR1107_11.18 (GND_11), ADTR1107_11.22 (GND_12), ADTR1107_11.25 (GND), ADTR1107_12.1 (GND_2), ADTR1107_12.3 (GND_3), ADTR1107_12.4 (GND_4), ADTR1107_12.6 (GND_5), ADTR1107_12.9 (NIC_2), ADTR1107_12.10 (NIC), ADTR1107_12.11 (GND_6), ADTR1107_12.13 (GND_7), ADTR1107_12.14 (GND_8), ADTR1107_12.15 (GND_9), ADTR1107_12.16 (GND_10), ADTR1107_12.18 (GND_11), ADTR1107_12.22 (GND_12), ADTR1107_12.25 (GND), ADTR1107_13.1 (GND_2), ADTR1107_13.3 (GND_3), ADTR1107_13.4 (GND_4), ADTR1107_13.6 (GND_5), ADTR1107_13.9 (NIC_2), ADTR1107_13.10 (NIC), ADTR1107_13.11 (GND_6), ADTR1107_13.13 (GND_7), ADTR1107_13.14 (GND_8), ADTR1107_13.15 (GND_9), ADTR1107_13.16 (GND_10), ADTR1107_13.18 (GND_11), ADTR1107_13.22 (GND_12), ADTR1107_13.25 (GND), ADTR1107_14.1 (GND_2), ADTR1107_14.3 (GND_3), ADTR1107_14.4 (GND_4), ADTR1107_14.6 (GND_5), ADTR1107_14.9 (NIC_2), ADTR1107_14.10 (NIC), ADTR1107_14.11 (GND_6), ADTR1107_14.13 (GND_7), ADTR1107_14.14 (GND_8), ADTR1107_14.15 (GND_9), ADTR1107_14.16 (GND_10), ADTR1107_14.18 (GND_11), ADTR1107_14.22 (GND_12), ADTR1107_14.25 (GND), ADTR1107_15.1 (GND_2), ADTR1107_15.3 (GND_3), ADTR1107_15.4 (GND_4), ADTR1107_15.6 (GND_5), ADTR1107_15.9 (NIC_2), ADTR1107_15.10 (NIC), ADTR1107_15.11 (GND_6), ADTR1107_15.13 (GND_7), ADTR1107_15.14 (GND_8), ADTR1107_15.15 (GND_9), ADTR1107_15.16 (GND_10), ADTR1107_15.18 (GND_11), ADTR1107_15.22 (GND_12), ADTR1107_15.25 (GND), ADTR1107_16.1 (GND_2), ADTR1107_16.3 (GND_3), ADTR1107_16.4 (GND_4), ADTR1107_16.6 (GND_5), ADTR1107_16.9 (NIC_2), ADTR1107_16.10 (NIC), ADTR1107_16.11 (GND_6), ADTR1107_16.13 (GND_7), ADTR1107_16.14 (GND_8), ADTR1107_16.15 (GND_9), ADTR1107_16.16 (GND_10), ADTR1107_16.18 (GND_11), ADTR1107_16.22 (GND_12), ADTR1107_16.25 (GND), C4.1, C5.1, C6.1, C7.1, C8.1, C9.1, C10.1, C11.1, C12.1, C13.1, C14.1, C15.1, C16.1, C36.1, C37.2, C38.2, C40.2, C41.2, C42.2, C46.1, C47.1, C53.1, C56.1, C66.2, C67.2, C68.2, C69.2, C73.2, C74.2, C79.2, C80.2, C81.2, C82.2, C86.2, C87.2, C88.2, C89.2, C90.2, C91.2, C92.2, C93.2, C94.2, C95.2, C96.2, C97.2, C98.2, C99.2, C100.2, C101.2, C102.2, C103.2, C104.2, C105.2, C106.2, C107.2, C114.2, C115.2, C116.2, C117.2, C118.2, C119.2, C120.2, C121.2, C122.2, C123.2, C124.2, C125.2, C130.2, C131.2, C132.2, C133.2, C137.2, C138.2, C139.2, C140.2, C145.2, C146.2, C147.2, C148.2, C152.2, C160.2, C161.2, C162.2, C167.2, C168.2, C169.2, C170.2, C174.2, C175.2, C183.2, C196.2, C200.2, C201.2, C202.2, C203.2, C207.2, C208.2, C209.2, C210.2, C214.2, C215.2, C216.2, C217.2, C221.2, C222.2, C223.2, C224.2, C228.2, C229.2, C230.2, C231.2, C235.2, C236.2, C237.2, C238.2, C242.2, C243.2, C244.2, C245.2, C249.2, C250.2, C251.2, C252.2, C293.1, C308.2, C309.2, J20.2, J20.3, J20.4, J20.5, J21.MH1, J21.MH2, J21.MH3, J21.MH4, J22.2, J22.3, J22.4, J22.5, J23.2, J23.3, J23.4, J23.5, J24.2, J24.3, J24.4, J24.5, J25.2, J25.3, J25.4, J25.5, J26.2, J26.3, J26.4, J26.5, J27.2, J27.3, J27.4, J27.5, J28.2, J28.3, J28.4, J28.5, J29.2, J29.3, J29.4, J29.5, J30.2, J30.3, J30.4, J30.5, J31.2, J31.3, J31.4, J31.5, J32.2, J32.3, J32.4, J32.5, J33.2, J33.3, J33.4, J33.5, J34.2, J34.3, J34.4, J34.5, J35.2, J35.3, J35.4, J35.5, J36.2, J36.3, J36.4, J36.5, J37.2, J37.3, J37.4, J37.5, J38.2, J38.3, J38.4, J38.5, J39.2, J39.3, J39.4, J39.5, J40.2, J40.3, J40.4, J40.5, J41.2, J41.3, J41.4, J41.5, J42.2, J42.3, J42.4, J42.5, J43.2, J43.3, J43.4, J43.5, J44.2, J44.3, J44.4, J44.5, J45.2, J45.3, J45.4, J45.5, J46.2, J46.3, J46.4, J46.5, J47.2, J47.3, J47.4, J47.5, J48.2, J48.3, J48.4, J48.5, J49.2, J49.3, J49.4, J49.5, J50.2, J50.3, J50.4, J50.5, J51.2, J51.3, J51.4, J51.5, J52.2, J52.3, J52.4, J52.5, J53.2, J53.3, J53.4, J53.5, J54.2, J54.3, J54.4, J54.5, J55.2, J55.3, J55.4, J55.5, L7.2, R31.1, R33.2, R37.1, R38.1, R45.2, R46.1, R47.1, R48.2, R55.2, R56.2, R57.2, R58.2, R70.1, R71.1, R72.2, R73.1, R74.1, R75.2, R76.1, R77.1, R115.1, R116.1, R117.1, R158.1, R159.1, R160.1, R161.1, R162.1, R163.1, R164.1, R165.2, R166.2, RF_SW_1.1 (NC), RF_SW_1.2 (GND), RF_SW_1.4 (GND2), RF_SW_1.7 (GND3), RF_SW_1.9 (GND4), RF_SW_1.11 (GND5), RF_SW_1.12 (NC2), RF_SW_1.13 (NC3), RF_SW_1.14 (GND6), RF_SW_1.16 (GND7), RF_SW_1.17 (EP), RF_SW_2.1 (NC), RF_SW_2.2 (GND), RF_SW_2.4 (GND2), RF_SW_2.7 (GND3), RF_SW_2.9 (GND4), RF_SW_2.11 (GND5), RF_SW_2.12 (NC2), RF_SW_2.13 (NC3), RF_SW_2.14 (GND6), RF_SW_2.16 (GND7), RF_SW_2.17 (EP), RF_SW_3.1 (NC), RF_SW_3.2 (GND), RF_SW_3.4 (GND2), RF_SW_3.7 (GND3), RF_SW_3.9 (GND4), RF_SW_3.11 (GND5), RF_SW_3.12 (NC2), RF_SW_3.13 (NC3), RF_SW_3.14 (GND6), RF_SW_3.16 (GND7), RF_SW_3.17 (EP), RF_SW_4.1 (NC), RF_SW_4.2 (GND), RF_SW_4.4 (GND2), RF_SW_4.7 (GND3), RF_SW_4.9 (GND4), RF_SW_4.11 (GND5), RF_SW_4.12 (NC2), RF_SW_4.13 (NC3), RF_SW_4.14 (GND6), RF_SW_4.16 (GND7), RF_SW_4.17 (EP), RF_SW_5.1 (NC), RF_SW_5.2 (GND), RF_SW_5.4 (GND2), RF_SW_5.7 (GND3), RF_SW_5.9 (GND4), RF_SW_5.11 (GND5), RF_SW_5.12 (NC2), RF_SW_5.13 (NC3), RF_SW_5.14 (GND6), RF_SW_5.16 (GND7), RF_SW_5.17 (EP), RF_SW_6.1 (NC), RF_SW_6.2 (GND), RF_SW_6.4 (GND2), RF_SW_6.7 (GND3), RF_SW_6.9 (GND4), RF_SW_6.11 (GND5), RF_SW_6.12 (NC2), RF_SW_6.13 (NC3), RF_SW_6.14 (GND6), RF_SW_6.16 (GND7), RF_SW_6.17 (EP), RF_SW_7.1 (NC), RF_SW_7.2 (GND), RF_SW_7.4 (GND2), RF_SW_7.7 (GND3), RF_SW_7.9 (GND4), RF_SW_7.11 (GND5), RF_SW_7.12 (NC2), RF_SW_7.13 (NC3), RF_SW_7.14 (GND6), RF_SW_7.16 (GND7), RF_SW_7.17 (EP), RF_SW_8.1 (NC), RF_SW_8.2 (GND), RF_SW_8.4 (GND2), RF_SW_8.7 (GND3), RF_SW_8.9 (GND4), RF_SW_8.11 (GND5), RF_SW_8.12 (NC2), RF_SW_8.13 (NC3), RF_SW_8.14 (GND6), RF_SW_8.16 (GND7), RF_SW_8.17 (EP), RF_SW_9.1 (NC), RF_SW_9.2 (GND), RF_SW_9.4 (GND2), RF_SW_9.7 (GND3), RF_SW_9.9 (GND4), RF_SW_9.11 (GND5), RF_SW_9.12 (NC2), RF_SW_9.13 (NC3), RF_SW_9.14 (GND6), RF_SW_9.16 (GND7), RF_SW_9.17 (EP), RF_SW_10.1 (NC), RF_SW_10.2 (GND), RF_SW_10.4 (GND2), RF_SW_10.7 (GND3), RF_SW_10.9 (GND4), RF_SW_10.11 (GND5), RF_SW_10.12 (NC2), RF_SW_10.13 (NC3), RF_SW_10.14 (GND6), RF_SW_10.16 (GND7), RF_SW_10.17 (EP), RF_SW_11.1 (NC), RF_SW_11.2 (GND), RF_SW_11.4 (GND2), RF_SW_11.7 (GND3), RF_SW_11.9 (GND4), RF_SW_11.11 (GND5), RF_SW_11.12 (NC2), RF_SW_11.13 (NC3), RF_SW_11.14 (GND6), RF_SW_11.16 (GND7), RF_SW_11.17 (EP), RF_SW_12.1 (NC), RF_SW_12.2 (GND), RF_SW_12.4 (GND2), RF_SW_12.7 (GND3), RF_SW_12.9 (GND4), RF_SW_12.11 (GND5), RF_SW_12.12 (NC2), RF_SW_12.13 (NC3), RF_SW_12.14 (GND6), RF_SW_12.16 (GND7), RF_SW_12.17 (EP), RF_SW_13.1 (NC), RF_SW_13.2 (GND), RF_SW_13.4 (GND2), RF_SW_13.7 (GND3), RF_SW_13.9 (GND4), RF_SW_13.11 (GND5), RF_SW_13.12 (NC2), RF_SW_13.13 (NC3), RF_SW_13.14 (GND6), RF_SW_13.16 (GND7), RF_SW_13.17 (EP), RF_SW_14.1 (NC), RF_SW_14.2 (GND), RF_SW_14.4 (GND2), RF_SW_14.7 (GND3), RF_SW_14.9 (GND4), RF_SW_14.11 (GND5), RF_SW_14.12 (NC2), RF_SW_14.13 (NC3), RF_SW_14.14 (GND6), RF_SW_14.16 (GND7), RF_SW_14.17 (EP), RF_SW_15.1 (NC), RF_SW_15.2 (GND), RF_SW_15.4 (GND2), RF_SW_15.7 (GND3), RF_SW_15.9 (GND4), RF_SW_15.11 (GND5), RF_SW_15.12 (NC2), RF_SW_15.13 (NC3), RF_SW_15.14 (GND6), RF_SW_15.16 (GND7), RF_SW_15.17 (EP), RF_SW_16.1 (NC), RF_SW_16.2 (GND), RF_SW_16.4 (GND2), RF_SW_16.7 (GND3), RF_SW_16.9 (GND4), RF_SW_16.11 (GND5), RF_SW_16.12 (NC2), RF_SW_16.13 (NC3), RF_SW_16.14 (GND6), RF_SW_16.16 (GND7), RF_SW_16.17 (EP), SJ1.1, U1.8 (DRGND_2), U1.23 (DRGND_3), U1.48 (DRGND), U1.57 (EPAD), U3.26 (DCOM), U4.6 (GND_2), U4.7 (GND_3), U4.9 (GND_4), U4.12 (GND), U4.17 (EPAD), U5.1 (GND_2), U5.4 (GND_3), U5.6 (GND_4), U5.8 (GND_5), U5.10 (GND_6), U5.12 (GND), U8.6 (GND_2), U8.7 (GND_3), U8.9 (GND_4), U8.12 (GND), U8.17 (EPAD), U13.1 (GND_2), U13.4 (GND_3), U13.6 (GND_4), U13.8 (GND_5), U13.10 (GND_6), U13.12 (GND), U14.2 (ANODE), U15.1 (CATHODE), U16.1 (NOT_USED), U16.8 (NOT_USED_8), U16.9 (GROUND_2), U16.11 (GROUND_3), U16.12 (NOT_USED_9), U16.13 (GROUND_4), U16.15 (GROUND_5), U16.16 (NOT_USED_10), U16.17 (NOT_USED_11), U16.18 (NOT_USED_12), U16.19 (NOT_USED_13), U16.20 (GROUND_6), U16.22 (GROUND_7), U16.23 (NOT_USED_14), U16.24 (NOT_USED_15), U16.25 (NOT_USED_16), U16.26 (GROUND_8), U16.28 (GROUND_9), U16.29 (NOT_USED_17), U16.30 (GROUND_10), U16.32 (GROUND_11), U16.33 (GROUND), U17.2 (ANODE), U37.1 (CATHODE), U38.2 (ANODE), U39.1 (CATHODE), U40.2 (ANODE), U41.1 (CATHODE), U43.2 (ANODE), U44.1 (CATHODE), U45.2 (ANODE), U46.1 (CATHODE), U47.2 (ANODE), U48.1 (CATHODE), U49.2 (ANODE), U50.1 (CATHODE), U51.2 (ANODE), U52.1 (CATHODE), U53.2 (ANODE), U54.1 (CATHODE), U55.2 (ANODE), U56.1 (CATHODE), U57.2 (ANODE), U58.1 (CATHODE), U59.2 (ANODE), U60.1 (CATHODE), U61.2 (ANODE), U62.1 (CATHODE), U63.2 (ANODE), U64.1 (CATHODE), U65.2 (ANODE), U66.1 (CATHODE), U67.2 (ANODE), U68.1 (CATHODE), U$1.1 (NC), U$1.2 (GND), U$1.4 (GND2), U$1.7 (GND3), U$1.9 (GND4), U$1.11 (GND5), U$1.12 (NC2), U$1.13 (NC3), U$1.14 (GND6), U$1.16 (GND7), U$1.17 (EP)
LNA_BIAS_1: ADAR1_0.A11 (LNA_BIAS), ADTR1107_1.23 (VGG_LNA), ADTR1107_2.23 (VGG_LNA), ADTR1107_3.23 (VGG_LNA), ADTR1107_4.23 (VGG_LNA)
LNA_BIAS_2: ADAR2_0.A11 (LNA_BIAS), ADTR1107_5.23 (VGG_LNA), ADTR1107_6.23 (VGG_LNA), ADTR1107_7.23 (VGG_LNA), ADTR1107_8.23 (VGG_LNA)
LNA_BIAS_3: ADAR3_0.A11 (LNA_BIAS), ADTR1107_9.23 (VGG_LNA), ADTR1107_10.23 (VGG_LNA), ADTR1107_11.23 (VGG_LNA), ADTR1107_12.23 (VGG_LNA)
LNA_BIAS_4: ADAR4_0.A11 (LNA_BIAS), ADTR1107_13.23 (VGG_LNA), ADTR1107_14.23 (VGG_LNA), ADTR1107_15.23 (VGG_LNA), ADTR1107_16.23 (VGG_LNA)
M3S_VCTRL: RF_SW_1.6 (VCTRL), RF_SW_2.6 (VCTRL), RF_SW_3.6 (VCTRL), RF_SW_4.6 (VCTRL), RF_SW_5.6 (VCTRL), RF_SW_6.6 (VCTRL), RF_SW_7.6 (VCTRL), RF_SW_8.6 (VCTRL), RF_SW_9.6 (VCTRL), RF_SW_10.6 (VCTRL), RF_SW_11.6 (VCTRL), RF_SW_12.6 (VCTRL), RF_SW_13.6 (VCTRL), RF_SW_14.6 (VCTRL), RF_SW_15.6 (VCTRL), RF_SW_16.6 (VCTRL), U$1.6 (VCTRL)
MIX_RX_EN: U13.7 (EN)
MIX_TX_EN: U5.7 (EN)
unnamed: ADAR1_0.B3 (PA_ON), R45.1
unnamed: ADAR1_0.M8 (CREG1), C88.1
unnamed: ADAR1_0.M9 (CREG2), C89.1
unnamed: ADAR1_0.N9 (CREG4), C91.1
unnamed: ADAR1_0.N10 (CREG3), C90.1
unnamed: ADAR2_0.B3 (PA_ON), R48.1
unnamed: ADAR2_0.M8 (CREG1), C86.1
unnamed: ADAR2_0.M9 (CREG2), C87.1
unnamed: ADAR2_0.N5 (ADDR1), R55.1
unnamed: ADAR2_0.N9 (CREG4), C93.1
unnamed: ADAR2_0.N10 (CREG3), C92.1
unnamed: ADAR3_0.B3 (PA_ON), R72.1
unnamed: ADAR3_0.M8 (CREG1), C94.1
unnamed: ADAR3_0.M9 (CREG2), C95.1
unnamed: ADAR3_0.N4 (ADDR0), R56.1, R79.2
unnamed: ADAR3_0.N9 (CREG4), C97.1
unnamed: ADAR3_0.N10 (CREG3), C96.1
unnamed: ADAR4_0.B3 (PA_ON), R75.1
unnamed: ADAR4_0.M8 (CREG1), C98.1
unnamed: ADAR4_0.M9 (CREG2), C99.1
unnamed: ADAR4_0.N4 (ADDR0), R57.1, R80.2
unnamed: ADAR4_0.N5 (ADDR1), R58.1, R81.2
unnamed: ADAR4_0.N9 (CREG4), C101.1
unnamed: ADAR4_0.N10 (CREG3), C100.1
unnamed: C1.2, J21.1
unnamed: C2.2, J21.2
unnamed: C3.1, R1.1, U1.36 (VIN-)
unnamed: C3.2, R13.1, U1.35 (VIN+)
unnamed: C38.1, U3.23 (COMP2)
unnamed: C39.1, U3.19 (COMP1)
unnamed: C43.1, R15.1, U4.4 (RDN)
unnamed: C43.2, R15.2, U4.1 (RDP)
unnamed: C44.1, U4.11 (VOP)
unnamed: C45.1, U4.10 (VON)
unnamed: C46.2, R16.1, R17.2
unnamed: C47.2, U4.14 (VCM)
unnamed: C48.2, R19.2
unnamed: C49.1, R18.1
unnamed: C51.1, U8.11 (VOP)
unnamed: C52.1, U8.10 (VON)
unnamed: C53.2, R20.1, R21.2
unnamed: C54.1, R32.1, U8.4 (RDN)
unnamed: C54.2, R32.2, U8.1 (RDP)
unnamed: C56.2, U8.14 (VCM)
unnamed: C57.2, R35.2
unnamed: C58.1, R34.1
unnamed: C60.1, C61.2, L2.2, L24.1
unnamed: C60.2, C62.2, L2.1, L28.1
unnamed: C61.1, L3.2
unnamed: C62.1, L4.2
unnamed: C63.1, C64.2, L3.1, L8.2
unnamed: C63.2, C65.2, L4.1, L8.1
unnamed: C64.1, L9.2
unnamed: C65.1, L10.2
unnamed: C70.1, J25.1
unnamed: C70.2, RF_SW_3.3 (RFOUT1)
unnamed: C71.1, RF_SW_3.10 (RFOUT2)
unnamed: C71.2, J24.1
unnamed: C72.1, RF_SW_3.15 (RFC)
unnamed: C83.2, U$1.3 (RFOUT1)
unnamed: C84.1, U$1.10 (RFOUT2)
unnamed: C85.1, U$1.15 (RFC)
unnamed: C126.1, J27.1
unnamed: C126.2, RF_SW_1.3 (RFOUT1)
unnamed: C128.1, RF_SW_1.10 (RFOUT2)
unnamed: C128.2, J26.1
unnamed: C129.1, RF_SW_1.15 (RFC)
unnamed: C134.1, J29.1
unnamed: C134.2, RF_SW_2.3 (RFOUT1)
unnamed: C135.1, RF_SW_2.10 (RFOUT2)
unnamed: C135.2, J28.1
unnamed: C136.1, RF_SW_2.15 (RFC)
unnamed: C141.1, L22.2, L26.1
unnamed: C141.2, L25.2, L27.1
unnamed: C142.1, J31.1
unnamed: C142.2, RF_SW_4.3 (RFOUT1)
unnamed: C143.1, RF_SW_4.10 (RFOUT2)
unnamed: C143.2, J30.1
unnamed: C144.1, RF_SW_4.15 (RFC)
unnamed: C149.1, J33.1
unnamed: C149.2, RF_SW_7.3 (RFOUT1)
unnamed: C150.1, RF_SW_7.10 (RFOUT2)
unnamed: C150.2, J32.1
unnamed: C151.1, RF_SW_7.15 (RFC)
unnamed: C163.1, J35.1
unnamed: C163.2, RF_SW_5.3 (RFOUT1)
unnamed: C165.1, RF_SW_5.10 (RFOUT2)
unnamed: C165.2, J34.1
unnamed: C166.1, RF_SW_5.15 (RFC)
unnamed: C171.1, J37.1
unnamed: C171.2, RF_SW_6.3 (RFOUT1)
unnamed: C172.1, RF_SW_6.10 (RFOUT2)
unnamed: C172.2, J36.1
unnamed: C173.1, RF_SW_6.15 (RFC)
unnamed: C197.1, J39.1
unnamed: C197.2, RF_SW_8.3 (RFOUT1)
unnamed: C198.1, RF_SW_8.10 (RFOUT2)
unnamed: C198.2, J38.1
unnamed: C199.1, RF_SW_8.15 (RFC)
unnamed: C204.1, J41.1
unnamed: C204.2, RF_SW_10.3 (RFOUT1)
unnamed: C205.1, RF_SW_10.10 (RFOUT2)
unnamed: C205.2, J40.1
unnamed: C206.1, RF_SW_10.15 (RFC)
unnamed: C211.1, J43.1
unnamed: C211.2, RF_SW_12.3 (RFOUT1)
unnamed: C212.1, RF_SW_12.10 (RFOUT2)
unnamed: C212.2, J42.1
unnamed: C213.1, RF_SW_12.15 (RFC)
unnamed: C218.1, J45.1
unnamed: C218.2, RF_SW_11.3 (RFOUT1)
unnamed: C219.1, RF_SW_11.10 (RFOUT2)
unnamed: C219.2, J44.1
unnamed: C220.1, RF_SW_11.15 (RFC)
unnamed: C225.1, J47.1
unnamed: C225.2, RF_SW_9.3 (RFOUT1)
unnamed: C226.1, RF_SW_9.10 (RFOUT2)
unnamed: C226.2, J46.1
unnamed: C227.1, RF_SW_9.15 (RFC)
unnamed: C232.1, J49.1
unnamed: C232.2, RF_SW_14.3 (RFOUT1)
unnamed: C233.1, RF_SW_14.10 (RFOUT2)
unnamed: C233.2, J48.1
unnamed: C234.1, RF_SW_14.15 (RFC)
unnamed: C239.1, J51.1
unnamed: C239.2, RF_SW_16.3 (RFOUT1)
unnamed: C240.1, RF_SW_16.10 (RFOUT2)
unnamed: C240.2, J50.1
unnamed: C241.1, RF_SW_16.15 (RFC)
unnamed: C246.1, J53.1
unnamed: C246.2, RF_SW_15.3 (RFOUT1)
unnamed: C247.1, RF_SW_15.10 (RFOUT2)
unnamed: C247.2, J52.1
unnamed: C248.1, RF_SW_15.15 (RFC)
unnamed: C253.1, J55.1
unnamed: C253.2, RF_SW_13.3 (RFOUT1)
unnamed: C254.1, RF_SW_13.10 (RFOUT2)
unnamed: C254.2, J54.1
unnamed: C255.1, RF_SW_13.15 (RFC)
unnamed: C268.1, L24.2
unnamed: C268.2, U13.2 (IF+)
unnamed: C270.1, L28.2
unnamed: C270.2, U13.3 (IF)
unnamed: C272.1, U5.11 (LO)
unnamed: C272.2, J23.1
unnamed: C274.1, U13.11 (LO)
unnamed: C274.2, J22.1
unnamed: R14.1, U4.3 (RGN)
unnamed: R14.2, U4.2 (RGP)
unnamed: R18.2, U4.16 (VIP)
unnamed: R19.1, U4.5 (VIN)
unnamed: R22.1, U8.3 (RGN)
unnamed: R22.2, U8.2 (RGP)
unnamed: R23.2, U3.1 (DB7)
unnamed: R24.2, U3.2 (DB6)
unnamed: R25.2, U3.3 (DB5)
unnamed: R26.2, U3.4 (DB4)
unnamed: R27.2, U3.5 (DB3)
unnamed: R28.2, U3.6 (DB2)
unnamed: R29.2, U3.7 (DB1)
unnamed: R30.2, U3.8 (DB0)
unnamed: R33.1, U3.18 (FSADJ)
unnamed: R34.2, U8.16 (VIP)
unnamed: R35.1, U8.5 (VIN)
unnamed: R36.1, R37.2, U1.29 (PWDN)
unnamed: R38.2, U1.31 (VREF)
unnamed: SJ1.2, U1.26 (SCLK/DFS)
PA_BIAS1_1: ADAR1_0.A10 (PA_BIAS1), ADTR1107_3.7 (VGG_PA), C103.1
PA_BIAS1_2: ADAR2_0.A10 (PA_BIAS1), ADTR1107_7.7 (VGG_PA), C107.1
PA_BIAS1_3: ADAR3_0.A10 (PA_BIAS1), ADTR1107_10.7 (VGG_PA), C116.1
PA_BIAS1_4: ADAR4_0.A10 (PA_BIAS1), ADTR1107_14.7 (VGG_PA), C120.1
PA_BIAS2_1: ADAR1_0.A9 (PA_BIAS2), ADTR1107_1.7 (VGG_PA), C102.1
PA_BIAS2_2: ADAR2_0.A9 (PA_BIAS2), ADTR1107_5.7 (VGG_PA), C106.1
PA_BIAS2_3: ADAR3_0.A9 (PA_BIAS2), ADTR1107_12.7 (VGG_PA), C117.1
PA_BIAS2_4: ADAR4_0.A9 (PA_BIAS2), ADTR1107_16.7 (VGG_PA), C121.1
PA_BIAS3_1: ADAR1_0.A5 (PA_BIAS3), ADTR1107_2.7 (VGG_PA), C105.1
PA_BIAS3_2: ADAR2_0.A5 (PA_BIAS3), ADTR1107_6.7 (VGG_PA), C114.1
PA_BIAS3_3: ADAR3_0.A5 (PA_BIAS3), ADTR1107_11.7 (VGG_PA), C118.1
PA_BIAS3_4: ADAR4_0.A5 (PA_BIAS3), ADTR1107_15.7 (VGG_PA), C122.1
PA_BIAS4_1: ADAR1_0.A4 (PA_BIAS4), ADTR1107_4.7 (VGG_PA), C104.1
PA_BIAS4_2: ADAR2_0.A4 (PA_BIAS4), ADTR1107_8.7 (VGG_PA), C115.1
PA_BIAS4_3: ADAR3_0.A4 (PA_BIAS4), ADTR1107_9.7 (VGG_PA), C119.1
PA_BIAS4_4: ADAR4_0.A4 (PA_BIAS4), ADTR1107_13.7 (VGG_PA), C123.1
RF_IO: C85.2, U16.21 (SUM_PORT)
RF_IO_1: ADAR1_0.A7 (RF_IO), U16.14 (PORT_1)
RF_IO_2: ADAR2_0.A7 (RF_IO), U16.10 (PORT_2)
RF_IO_3: ADAR3_0.A7 (RF_IO), U16.31 (PORT_3)
RF_IO_4: ADAR4_0.A7 (RF_IO), U16.27 (PORT_4)
RF_RX: U13.5 (RF), U$3.P$1 (IN)
RF_RX_FIL: C84.2, U$3.P$2 (OUT)
RF_TX: U5.5 (RF), U$2.P$2 (OUT)
RF_TX_FIL: C83.1, U$2.P$1 (IN)
RX1_1: ADAR1_0.J13 (RX1), ADTR1107_3.2 (RX_OUT)
RX1_2: ADAR2_0.J13 (RX1), ADTR1107_7.2 (RX_OUT)
RX1_3: ADAR3_0.J13 (RX1), ADTR1107_10.2 (RX_OUT)
RX1_4: ADAR4_0.J13 (RX1), ADTR1107_14.2 (RX_OUT)
RX2_1: ADAR1_0.C13 (RX2), ADTR1107_1.2 (RX_OUT)
RX2_2: ADAR2_0.C13 (RX2), ADTR1107_5.2 (RX_OUT)
RX2_3: ADAR3_0.C13 (RX2), ADTR1107_12.2 (RX_OUT)
RX2_4: ADAR4_0.C13 (RX2), ADTR1107_16.2 (RX_OUT)
RX3_1: ADAR1_0.E1 (RX3), ADTR1107_2.2 (RX_OUT)
RX3_2: ADAR2_0.E1 (RX3), ADTR1107_6.2 (RX_OUT)
RX3_3: ADAR3_0.E1 (RX3), ADTR1107_11.2 (RX_OUT)
RX3_4: ADAR4_0.E1 (RX3), ADTR1107_15.2 (RX_OUT)
RX4_1: ADAR1_0.L1 (RX4), ADTR1107_4.2 (RX_OUT)
RX4_2: ADAR2_0.L1 (RX4), ADTR1107_8.2 (RX_OUT)
RX4_3: ADAR3_0.L1 (RX4), ADTR1107_9.2 (RX_OUT)
RX4_4: ADAR4_0.L1 (RX4), ADTR1107_13.2 (RX_OUT)
STM32_MISO_1V8: ADAR1_0.M4 (SDO), ADAR2_0.M4 (SDO), ADAR3_0.M4 (SDO), ADAR4_0.M4 (SDO), R164.2
STM32_MOSI_1V8: ADAR1_0.M5 (SDIO), ADAR2_0.M5 (SDIO), ADAR3_0.M5 (SDIO), ADAR4_0.M5 (SDIO), R163.2
STM32_SCLK_1V8: ADAR1_0.M6 (SCLK), ADAR2_0.M6 (SCLK), ADAR3_0.M6 (SCLK), ADAR4_0.M6 (SCLK), R162.2
TR_SW_POS_1: ADAR1_0.B5 (TR_SW_POS), ADTR1107_1.20 (CTRL_SW), ADTR1107_2.20 (CTRL_SW), ADTR1107_3.20 (CTRL_SW), ADTR1107_4.20 (CTRL_SW)
TR_SW_POS_2: ADAR2_0.B5 (TR_SW_POS), ADTR1107_5.20 (CTRL_SW), ADTR1107_6.20 (CTRL_SW), ADTR1107_7.20 (CTRL_SW), ADTR1107_8.20 (CTRL_SW)
TR_SW_POS_3: ADAR3_0.B5 (TR_SW_POS), ADTR1107_9.20 (CTRL_SW), ADTR1107_10.20 (CTRL_SW), ADTR1107_11.20 (CTRL_SW), ADTR1107_12.20 (CTRL_SW)
TR_SW_POS_4: ADAR4_0.B5 (TR_SW_POS), ADTR1107_13.20 (CTRL_SW), ADTR1107_14.20 (CTRL_SW), ADTR1107_15.20 (CTRL_SW), ADTR1107_16.20 (CTRL_SW)
TX1_1: ADAR1_0.L13 (TX1), ADTR1107_3.5 (TX_IN)
TX1_2: ADAR2_0.L13 (TX1), ADTR1107_7.5 (TX_IN)
TX1_3: ADAR3_0.L13 (TX1), ADTR1107_10.5 (TX_IN)
TX1_4: ADAR4_0.L13 (TX1), ADTR1107_14.5 (TX_IN)
TX2_1: ADAR1_0.E13 (TX2), ADTR1107_1.5 (TX_IN)
TX2_2: ADAR2_0.E13 (TX2), ADTR1107_5.5 (TX_IN)
TX2_3: ADAR3_0.E13 (TX2), ADTR1107_12.5 (TX_IN)
TX2_4: ADAR4_0.E13 (TX2), ADTR1107_16.5 (TX_IN)
TX3_1: ADAR1_0.C1 (TX3), ADTR1107_2.5 (TX_IN)
TX3_2: ADAR2_0.C1 (TX3), ADTR1107_6.5 (TX_IN)
TX3_3: ADAR3_0.C1 (TX3), ADTR1107_11.5 (TX_IN)
TX3_4: ADAR4_0.C1 (TX3), ADTR1107_15.5 (TX_IN)
TX4_1: ADAR1_0.J1 (TX4), ADTR1107_4.5 (TX_IN)
TX4_2: ADAR2_0.J1 (TX4), ADTR1107_8.5 (TX_IN)
TX4_3: ADAR3_0.J1 (TX4), ADTR1107_9.5 (TX_IN)
TX4_4: ADAR4_0.J1 (TX4), ADTR1107_13.5 (TX_IN)

Notes on the sheet:
TX CHAIN: DAC -> RECONSTRUCTION FILTER -> MIXER -> STUB BPF
TX RX RF SWITCH <-> SPLITTER/COMBINER
RX CHAIN: ADC <- 2nd STAGE AMPLIFIER(10dB) <- 1st STAGE AMPLIFIER(15dB) <- IF LPF <- MIXER <- STUB BPF
