MekhyW/PLFM_RADAR/9_Firmware/9_2_FPGA/usb_data_interface_ft2232h.v

`timescale 1ns / 1ps

`include "radar_params.vh"

/**
 * usb_data_interface_ft2232h.v
 *
 * FT2232H USB 2.0 Hi-Speed FIFO Interface (245 Synchronous FIFO Mode)
 * Channel A only — 8-bit data bus, 60 MHz CLKOUT from FT2232H.
 *
 * BULK PER-FRAME PROTOCOL V2 (PR-G — single canonical encoding):
 *
 * Frame packet (FPGA→Host): variable length, up to 74,762 bytes
 *   Byte 0:       0xAA (frame start header)
 *   Byte 1:       0x02 (PROTOCOL VERSION — host MUST reject any other value)
 *   Byte 2:       Flags byte. Layout (PR-U / M-8 widened bits[5:3]):
 *                   bits[7:6] = 2'b00 reserved
 *                   bits[5:3] = subframe_enable[2:0] = {LONG, MEDIUM, SHORT}
 *                               (host_subframe_enable snapshot at frame_complete)
 *                   bits[2:0] = {stream_cfar, stream_doppler, stream_range}
 *   Bytes 3-4:    Frame number (uint16, MSB first)
 *   Bytes 5-6:    Range bin count   (uint16, MSB first) = `RP_NUM_RANGE_BINS`  (512)
 *   Bytes 7-8:    Doppler bin count (uint16, MSB first) = `RP_NUM_DOPPLER_BINS` (48)
 *
 *   [If stream_range (bit 0):]
 *     Next 1024 bytes: range profile, 512 × uint16 Manhattan magnitude, MSB first.
 *
 *   [If stream_doppler (bit 1):]
 *     Next 65536 bytes: doppler magnitude, 32768 cells × uint16, row-major
 *     (range_bin slowest, doppler_bin fastest), MSB first. Cells indexed
 *     [0..47] are real Doppler bins; cells [48..63] within each range are
 *     the power-of-2 padding from PR-F (always emitted as 0x0000).
 *
 *   [If stream_cfar (bit 2):]
 *     Next 8192 bytes: detect_class bitmap, 32768 cells × 2 bits, MSB-first
 *     packing. Each byte holds 4 cells:
 *       byte[N]:  bits[7:6]=cell[4*N], bits[5:4]=cell[4*N+1],
 *                 bits[3:2]=cell[4*N+2], bits[1:0]=cell[4*N+3]
 *     Cell encoding (per `RP_DETECT_*`):
 *       2'b00 = NONE      (below soft threshold)
 *       2'b01 = CANDIDATE (above soft, below confirm — host re-cues)
 *       2'b10 = CONFIRMED (above confirm threshold — track-eligible)
 *       2'b11 = RESERVED  (must not be emitted by RTL)
 *
 *   Last byte:    0x55 (frame end footer)
 *
 * Status packet (FPGA→Host): 30 bytes (PR-G: was 26 in v1, +4 for soft tier)
 *   Byte 0:       0xBB (status header)
 *   Bytes 1-28:   7 × 32-bit status words, MSB first
 *                 word[6] = {detect_count_cand[15:0], detect_threshold_soft[15:0]}
 *   Byte 29:      0x55 (footer)
 *
 * Command (Host→FPGA): 4 bytes received sequentially (unchanged)
 *   Byte 0: opcode[7:0]    (see RP_OP_* in radar_params.vh)
 *   Byte 1: addr[7:0]
 *   Byte 2: value[15:8]
 *   Byte 3: value[7:0]
 *
 * MEMORY ARCHITECTURE:
 *   - Doppler magnitude BRAM: 32768 entries × 16-bit = 64 KB (~28 BRAM18 on 50T)
 *     Written in clk (100 MHz) domain as Doppler cells arrive.
 *     Read in ft_clk (60 MHz) domain during USB bulk transfer.
 *   - Range profile buffer: 512 × 16-bit = 1 KB (1 BRAM18)
 *     Written in clk domain from range_valid events.
 *   - Detect-class buffer: 32768 cells × 2 bits = 65536 bits = 8192 bytes (4 BRAM18)
 *     Written in clk domain from cfar_valid events via 3-cycle RMW pipeline.
 *
 * BANDWIDTH BUDGET (PR-G v2, all streams):
 *   Header: 9 B + Range: 1024 B + Doppler: 65536 B + Detect: 8192 B + Footer: 1 B
 *   = 74,762 bytes/frame × ~119 fps (3-subframe rate post-PR-F) ≈ 8.9 MB/s
 *   FT2232H 245-Sync-FIFO conservative budget ~8 MB/s (FTDI AN_232B-04, 80%
 *   utilisation); practical sustained throughput is 30–40 MB/s on a tuned
 *   host. Sufficient headroom even with the conservative budget overshoot.
 *
 * CDC STRATEGY:
 *   - Frame data: Written to dual-port BRAM at 100 MHz, read at 60 MHz (inherently CDC-safe).
 *   - frame_ready flag: Toggle CDC (100 MHz → 60 MHz), same as status_request.
 *   - stream_control: 2-stage level sync (changes infrequently).
 *   - status_*_soft / status_*_cand: 2-stage level sync (slow-changing per-frame values).
 *   - Commands: Read FSM in ft_clk domain, output CDC'd by consumer (unchanged).
 *
 * Clock domains:
 *   clk       = 100 MHz system clock (radar data domain)
 *   ft_clk    = 60 MHz from FT2232H CLKOUT (USB FIFO domain)
 */

module usb_data_interface_ft2232h (
    input wire clk,              // Main clock (100 MHz)
    input wire reset_n,          // System reset (clk domain)
    input wire ft_reset_n,       // FT2232H-domain synchronized reset

    // Radar data inputs (clk domain)
    input wire [31:0] range_profile,           // {range_q[15:0], range_i[15:0]}
    input wire range_valid,
    input wire [15:0] doppler_real,
    input wire [15:0] doppler_imag,
    input wire doppler_valid,
    // PR-G: 2-bit class replaces single cfar_detection bit.
    input wire [`RP_DETECT_CLASS_WIDTH-1:0] cfar_detect_class,
    input wire cfar_valid,

    // New inputs for bulk frame protocol (clk domain)
    // [RX-D] Widened to RP_RANGE_BIN_WIDTH_MAX (9-bit on 50T, 12-bit on 200T)
    // to match upstream pipeline. In 3 km mode only bins 0..511 are exercised
    // and the frame wire protocol still emits 512×32=16384 cells. 20 km mode
    // (4096 bins, 131072 cells) requires a wire-protocol extension before
    // bins 512..4095 can be transported to the host.
    input wire [`RP_RANGE_BIN_WIDTH_MAX-1:0] range_bin_in,
    input wire [`RP_DOPPLER_BIN_WIDTH-1:0]   doppler_bin_in,  // 6-bit (PR-F): {sub_frame[1:0], bin[3:0]}
    input wire                               frame_complete,  // 1-cycle pulse from radar_receiver_final edge detector

    // FT2232H Physical Interface (245 Synchronous FIFO mode)
    inout wire [7:0] ft_data,       // 8-bit bidirectional data bus
    input wire ft_rxf_n,            // Receive FIFO not empty (active low)
    input wire ft_txe_n,            // Transmit FIFO not full (active low)
    output reg ft_rd_n,             // Read strobe (active low)
    output reg ft_wr_n,             // Write strobe (active low)
    output reg ft_oe_n,             // Output enable (active low) — bus direction
    output reg ft_siwu,             // Send Immediate / WakeUp

    // Clock from FT2232H (directly used — no ODDR forwarding needed)
    input wire ft_clk,              // 60 MHz from FT2232H CLKOUT

    // Host command outputs (ft_clk domain — CDC'd by consumer)
    output reg [31:0] cmd_data,
    output reg cmd_valid,
    output reg [7:0] cmd_opcode,
    output reg [7:0] cmd_addr,
    output reg [15:0] cmd_value,

    // Stream control input (clk domain, CDC'd internally)
    input wire [5:0] stream_control,

    // PR-U / M-8: per-frame sub-frame enable mask (clk domain, CDC'd
    // internally, snapshotted at frame_complete). {LONG, MEDIUM, SHORT}.
    // Echoed in v2 frame byte 2 bits[5:3] so the host CRT can detect
    // when an operator disables a sub-frame and downgrade confidence
    // (default 3'b111 keeps the production 3-PRI ladder behavior).
    input wire [2:0] subframe_enable,

    // Status readback inputs (clk domain, CDC'd internally)
    input wire status_request,
    input wire [15:0] status_cfar_threshold,
    input wire [5:0]  status_stream_ctrl,
    input wire [1:0]  status_radar_mode,
    input wire [15:0] status_long_chirp,
    input wire [15:0] status_long_listen,
    input wire [15:0] status_guard,
    input wire [15:0] status_short_chirp,
    input wire [15:0] status_short_listen,
    input wire [5:0]  status_chirps_per_elev,
    input wire [1:0]  status_range_mode,
    input wire        status_chirps_mismatch,  // TX-G: host requested chirps != Doppler FFT size

    // Self-test status readback
    input wire [4:0]  status_self_test_flags,
    input wire [7:0]  status_self_test_detail,
    input wire        status_self_test_busy,

    // AGC status readback
    input wire [3:0]  status_agc_current_gain,
    input wire [7:0]  status_agc_peak_magnitude,
    input wire [7:0]  status_agc_saturation_count,
    input wire        status_agc_enable,

    // AUDIT-S10: control-fault flags (clk domain). Exposed in status_words[5]
    // [6:5] so host-side telemetry can graph each fault class independently
    // of the gpio_dig7 split. 2-stage level CDC into ft_clk; sticky/slow-
    // changing source so 2-FF sync is sufficient.
    input wire        status_range_decim_watchdog,  // audit F-6.4
    input wire        status_ddc_cic_fir_overrun,   // audit F-1.2

    // PR-G: 2-tier CFAR telemetry (clk domain → status_words[6]).
    // Slow-changing per-frame values; 2-stage level CDC into ft_clk.
    input wire [7:0]  status_cfar_alpha_soft,       // current host_cfar_alpha_soft (Q4.4)
    input wire [16:0] status_detect_threshold_soft, // PR-G: candidate-tier threshold (last frame)
    input wire [15:0] status_detect_count_cand      // PR-G: candidate count (last frame)
);

// ============================================================================
// CONSTANTS
// ============================================================================
localparam HEADER        = 8'hAA;
localparam FOOTER        = 8'h55;
localparam STATUS_HEADER = 8'hBB;

localparam NUM_RANGE_BINS  = `RP_NUM_RANGE_BINS;   // 512
localparam NUM_DOPPLER_BINS = `RP_NUM_DOPPLER_BINS; // 48 (PR-F)
localparam RANGE_BIN_BITS  = `RP_RANGE_BIN_BITS;    // 9
localparam DOPPLER_BIN_BITS = `RP_DOPPLER_BIN_WIDTH;// 6 (PR-F)
// PR-F: pad FRAME_CELLS to next-power-of-2 along the doppler axis so the
// {range, doppler[N-1:0]} concatenation lands in a contiguous BRAM block per
// range bin. Costs ~10 extra RAMB18 vs the previous 16K-cell packing but
// avoids a per-write multiply on the 100 MHz path.
localparam FRAME_CELLS     = NUM_RANGE_BINS * (1 << DOPPLER_BIN_BITS);     // 32768 (PR-F)
// Frame-cell address widths.
localparam FRAME_ADDR_W      = RANGE_BIN_BITS + DOPPLER_BIN_BITS;          // 15
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
