MekhyW/PLFM_RADAR/(commit log)

2026-04-18 fix(fpga): registered reset fan-out at 400 MHz; default USB to FT2232H
    Replace direct !reset_n async sense with a registered active-high reset_h
    (max_fanout=50) in nco_400m_enhanced, cic_decimator_4x_enhanced, and
    ddc_400m. The prior single-LUT1 / 700+ load net was the root cause of
    WNS=-0.626 ns in the 400 MHz clock domain on the xc7a50t build. Vivado
    replicates the constrained register into ≈14 regional copies, each driving
    ≤50 loads, closing timing at 2.5 ns.
    Change radar_system_top default USB_MODE from 0 (FT601) to 1 (FT2232H).
    FT601 remains available for the 200T premium board via explicit parameter
    override; the 50T production wrapper already hard-codes USB_MODE=1.
    Regression: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
    [rtl_bb_dc.csv, rx_final_doppler_out.csv]
2026-04-23 ci(fpga): wire RX-B latency tests; fix downstream compile after inline-FFT removal
    - run_regression.sh: add frequency_matched_filter.v to PROD_RTL and RECEIVER_RTL
    compile groups (was implicitly required after inline behavioural FFT in
    matched_filter_processing_chain.v was removed); empty EXTRA_RTL with set -u
    guards; bump Matched Filter Chain timeout to 600s.
    - run_regression.sh: add two PHASE 3 tests — tb_rxb_latency_measure (chain
    pipeline depth) and tb_rxb_fullchain_latency (multi-segment + chain).
    - radar_receiver_final.v: replace dangling delayed_ref_i/q references (left
    over from latency_buffer removal) with ref_chirp_real/imag.
    - tb/tb_radar_receiver_final.v: chain-state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
    [radar_receiver_final.v, tb_radar_receiver_final.v, tb_rxb_latency_measure.v]
2026-04-23 build(mcu): vendor STM32F7 HAL + gcc Makefile (PR 1 of firmware bring-up)
    First of three planned PRs to produce a bootable STM32F746ZGT7 firmware
    image from the sources already in-tree. The original CubeIDE project
    (.ioc + generated Core/Drivers/Middlewares) never made it into the repo,
    so the build is being reconstructed from scratch against the vendored HAL.
    Scope of this PR:
    - Pin arm-none-eabi-gcc 15 (brew --cask gcc-arm-embedded) as the
    toolchain for local macOS builds.
    - Vendor trimmed copies of the four upstream trees needed by a minimal
    STM32F7 project:
    * CMSIS_5 5.9.0 Cortex-M7 Core/Include subset (256 KB)
    * cmsis_device_f7 v1.2.8 F746-only device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
2026-04-23 docs(fpga): correct fir_lowpass.v rate comment + flag rate/coeff mismatch
    The header had two claims that "valid samples arrive every ~4 cycles" at
    the FIR boundary. That is false in the production wiring: the CIC `_4x`
    decimator turns clk_400m into a 100 M-pulse-per-second stream, then
    cdc_adc_to_processing crosses that into clk_100m where dst_valid asserts
    every cycle in steady state. The 4:1 ratio applies between the two clock
    domains, not as further sub-sampling inside clk_100m.
    This matters because the 32-tap coefficients were designed for the
    25 MSPS rate the wrong comment described, but the FIR is actually being
    driven at 100 MSPS. The cutoff sits 4x higher than intended; existing
    tes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
    [fir_lowpass.v]
2026-04-23 perf(fpga): symmetric pre-adder FIR — 32→16 DSPs/channel (-32 total)
    Re-group the 32-tap symmetric lowpass into 16 (D+A)*B operations using
    the DSP48E1 pre-adder, exploiting coeff[k] == coeff[31-k]. Production
    silicon (XC7A50T) drops from 112/120 DSPs (93.3%) to 80/120 (66.7%),
    freeing the budget needed for the matched-filter FFT swap (RX-NEW-3).
    Bit-exact contract preserved at non-saturating signal levels: DC=5000
    → 8847 and 45 MHz tone → ±16 LSB match the unfolded design and the
    Python golden model. Throughput unchanged (1 sample/cycle, 100 MSPS);
    latency +2 cycles for the pre-adder stage.
    Saturation thresholds rebuilt via bit concatenation to dodge the
    Verilog 32-bit-literal tr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
    [fir_lowpass.v]
2026-04-27 fix(gui): GUI-S1 — structural validation in find_packet_boundaries
    The packet-boundary scanner only checked header + footer bytes, so any
    payload byte that happened to be 0xAA (or 0xBB) and which lined up with
    a 0x55 at offset+10 (or +25) was accepted as a packet. A single corrupt
    byte could permanently shift the binning until the next frame_start
    re-sync.
    Added two structural sentinel checks against fixed bits the FPGA
    emitter always drives to known values:
    - data byte 9 = {frame_start, 6'b0, cfar_detection} -> bits[6:1]==0
    - status byte 1 = high byte of status_words[0] -> 0xFF
    Combined with the existing footer check, false-match probability drops
    from ~1/256 to ~1/16384 (d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
2026-04-27 cleanup(fpga): RX-A1 — drop dead chirp_counter port from MF chain
    matched_filter_processing_chain declared `input wire [5:0] chirp_counter`
    but never read it inside the module. matched_filter_multi_segment passed
    its own chirp_counter through to that dead port.
    Removed the port from the chain and the corresponding hookup at the
    multi_segment instantiation site. Five testbenches also referenced the
    port (tb_mf_cosim, tb_matched_filter_processing_chain, tb_rxb_latency
    _measure plus the four MF cosim variants that share tb_mf_cosim) — the
    reg/connection/init lines were dropped, and the now-stale "Test Group 8:
    Chirp Counter Passthrough" was repurposed as a port-removal smoke test
    that conf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
2026-04-27 fix(mcu): MCU-A1 — replace 25 C cooling stub with 70/60 C hysteresis
    Cooling-fan trip in main.cpp's periodic temperature block was a 25 C dev
    stub that latched the fan ON at room temperature on every boot. Replaced
    with production thermal control: ON at 70 C, OFF at 60 C. The 10 C
    dead-band prevents relay/fan chatter near the threshold; the 70 C ON
    point sits below the 75 C SAFE-mode gate in checkSystemHealth() so the
    fan engages before the system shuts down.
    Driven from the existing `temperature` global (max of 8 sensors,
    populated just above by the GAP-3 fix) instead of re-OR'ing the eight
    Temperature_N variables — single source of truth, and the diag now
    prints the actual peak temper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
    [main.cpp, test_mcu_a1_cooling_hysteresis.c]
2026-04-28 fix(mcu): MCU-A5 — gate Idq health-window during PA calibration walk
    The boot-time Idq calibration walks DAC_val from 126 down toward the
    1.680 A target. Mid-walk readings sit well above the 2.5 A overcurrent
    threshold by design, and a channel that hits the safety_counter timeout
    (50 iters) can be left above the window. Without a gate, the next
    checkSystemHealth() pass would trip ERROR_RF_PA_OVERCURRENT and route
    straight into Emergency_Stop, killing the system mid-bringup.
    Added a `pa_calibration_in_progress` flag set TRUE around both DAC1 and
    DAC2 cal walks. checkSystemHealth's Idq window short-circuits while the
    flag is set; bias-fault and overcurrent thresholds remain fully active
    onc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
    [main.cpp, test_mcu_a5_pa_cal_gate.c]
2026-04-28 fix(mcu): MCU-A6 — recovery handlers for AD9523_CLOCK and FPGA_COMM
    attemptErrorRecovery() previously fell through to the default log-only
    branch for both ERROR_AD9523_CLOCK and ERROR_FPGA_COMM. checkSystemHealth
    keeps re-firing the same error every pass with no recovery action ever
    attempted, so the system limps along until escalation kicks in.
    ERROR_AD9523_CLOCK: AD9523_RESET_ASSERT, 10 ms settle, then re-run
    configure_ad9523() (releases reset, selects REFB, reprograms, waits for
    lock). On second failure we log and let the next health pass re-fire so
    a transient brown-out on the 100 MHz reference does not drop straight
    into Emergency_Stop.
    ERROR_FPGA_COMM: pulse PD12 LOW->10 ms->HIGH (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
    [main.cpp, test_mcu_a6_recovery_dispatch.c]
2026-04-28 fix(fpga): TX-N9 — sim-only payload-hold checker on cmd CDC
    cmd_data / cmd_opcode / cmd_addr / cmd_value feed downstream CDC sync
    chains; the safety property is that they only change on the cycle
    cmd_valid rises (RD_PROCESS), and stay held on every other cycle so the
    receiver's 2-FF synchronizer sees a clean payload regardless of where
    its sample window lands. The FSM satisfies this implicitly today, but
    nothing flagged a regression that introduced a stray write somewhere
    in the same always block.
    Added an `ifdef SIMULATION block at the bottom of both
    usb_data_interface.v (FT601 / ft601_clk_in / ft601_reset_n) and
    usb_data_interface_ft2232h.v (FT2232H / ft_clk / ft_reset_n). It
    snapshots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
    [usb_data_interface.v, usb_data_interface_ft2232h.v]
2026-04-29 ft2232h: add frame drop counter (AUDIT-C12) + cfar RMW cadence guard (AUDIT-S22)
    AUDIT-C12: usb_data_interface_ft2232h had a misleading single-buffer comment
    that overstated the timing slack and referenced a frame_ack_toggle CDC that
    was never implemented. Re-verified actual numbers: at 178 fps the slack is
    1.14 ms (20%), not "much shorter than gap". No data corruption today (write
    order matches read order, addresses don't collide), but frame_complete
    firing while WR_FSM is still draining the previous frame causes silent
    frame drops via the missed frame_ready_toggle edge.
    Fix is instrumentation, not architectural rework: add wr_done_toggle
    (ft_clk -> clk CDC) on WR_DONE -> WR_IDLE, track fr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
    [cfar_ca.v, tb_ft2232h_frame_drop.v, usb_data_interface_ft2232h.v]
2026-04-29 mcu(bmp180): call cal-coefficient init at boot + watchdog cadence fix (AUDIT-CAL)
    The BMP180 driver had no public init method and never called
    readCalibrationCoefficients() from anywhere -- _calCoeff ran at the
    C++ in-class member-initializer defaults (all zeros) at runtime.
    Consequence chain:
    - computeB5(UT) short-circuited via 0/0 (Cortex-M7 SDIV with
    SCB->CCR.DIV_0_TRP=0 returns 0 silently -- system_stm32f7xx.c does
    not enable the trap)
    - getPressure() always tripped the `if (B4 == 0)` guard, returning
    the I2C-error sentinel (post-AUDIT-C17: INT32_MIN; pre-: 255)
    - health watchdog at main.cpp:758 fired ERROR_BMP180_COMM every
    main-loop iteration because last_bmp_che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
    [BMP180.cpp, BMP180.h, main.cpp, test_audit_cal_bmp180_begin.c]
2026-04-29 cosim: refresh stale baselines (FFT-2048 + chirp realign)
    Two stale-baseline events were never captured in earlier commits:
    1. The FFT-1024 -> FFT-2048 merge (c668652) updated the testbench and
    gen_mf_cosim_golden.py but left radar_scene.py FFT_SIZE=1024. When
    FFT_SIZE was later bumped to 2048, the input vectors written by
    generate_baseband_samples (bb_mf_test_*.hex, ref_chirp_*.hex) grew
    from 1024 to 2048 samples but were never re-exported.
    2. The TX-I matched-filter realignment (5ff5671) changed the ADC chirp
    phase from 2*pi*F_IF*t to 2*pi*(F_IF+F_BASEBAND_LOW)*t. ADC sample
    values shifted from sample ~1336 onward but adc_*.hex was never
    re-exported.
    Result: every r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
    [compare_mf_chirp.csv, compare_mf_dc.csv, compare_mf_impulse.csv, compare_mf_tone5.csv, rtl_bb_dc.csv, rtl_mf_chirp.csv, rtl_mf_dc.csv, rtl_mf_impulse.csv]
2026-04-29 mcu(health): commit rate-limit window before early returns (AUDIT-CAL follow-up)
    checkSystemHealth() had three watchdog blocks with the identical
    "last_X_check not updated on error path" bug — same root cause as
    AUDIT-CAL (BMP180 fix in commit 95aed35), distinct sites:
    AD9523 clock check (5 s) main.cpp:693-705
    ADAR1000 comm check (2 s) main.cpp:729-749
    IMU comm check (10 s) main.cpp:752-760
    Pre-fix, each block placed `last_X_check = HAL_GetTick();` below the
    early-return path, so once the underlying check (STATUS0/1 RESET,
    SCRATCHPAD verify fail, GY85_Update false) started failing, the
    rate-limit window never engaged. Every subsequent iteration of the
    main while(1) loop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
    [main.cpp, test_audit_imu_watchdog_cadence.c]
2026-04-29 mcu(health): poll PD15 + dispatch ERROR_FPGA_DSP_STALL (AUDIT-S10 follow-up)
    AUDIT-S10 (commit `58154a6`) split the FPGA's six-flag aggregate
    gpio_dig5 into two MCU-visible bits: gpio_dig5 keeps signal-saturation
    (AGC reacts), gpio_dig7 (PD15) carries control-fault classes
    (range_decim_watchdog | cic_fir_overrun). Until now the MCU did NOT
    poll PD15, so DSP control faults were invisible to the recovery
    dispatcher.
    Changes:
    - New `ERROR_FPGA_DSP_STALL` enum value placed AFTER ERROR_WATCHDOG_TIMEOUT
    so the dispatcher routes to attemptErrorRecovery (FPGA reset pulse) not
    Emergency_Stop. Updated error_strings[] in lockstep (static_assert
    enforces).
    - checkSystemHealth section 10 polls P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
    [main.cpp, test_audit_s10_dsp_stall_polling.c]
2026-04-30 AUDIT-C7: document GO/SO edge-bin Pfa drift in cfar_ca header
    cfar_ca.v's GO/SO modes correctly cross-multiply to pick the side with
    the greater (GO) or lesser (SO) per-cell average, but return that
    side's RAW SUM as the noise estimate -- not the average. Combined with
    alpha being pre-baked for the interior training-cell count, this means
    at edges where the picked side is truncated, effective Pfa shifts by
    the count ratio (up to ~2x in the first/last r_train bins). CA mode's
    edge behavior was already documented; GO/SO's was not.
    Documentation only -- no RTL behavior change. The audit's preferred
    fix (divide noise_sum by selected_count) is explicitly NOT applied:
    per-CUT integer divide is ex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
    [cfar_ca.v]
2026-04-30 docs(fpga): correct matched_filter_processing_chain header (LogiCORE swap, FSM)
    The header still described the legacy in-house Radix-2 DIT fft_engine and a
    FWD/REF/INV BITREV+BUTTERFLY state list that no longer matches reality.
    Since RX-NEW-3 (commit 5c8cc8c), the chain instantiates fft_engine_axi_bridge,
    which wraps xfft_2048 — LogiCORE FFT v9.1 (Pipelined Streaming) in synth/XSim
    when FFT_USE_XILINX_IP is defined, in-house fft_engine fallback in iverilog.
    Bit-reversal is now handled inside the IP (and the fallback), so the FSM has
    COLLECT → SIG_FFT/CAP → REF_FFT/CAP → MULTIPLY → INV_FFT/CAP → OUTPUT → DONE.
    No RTL changes. Header comment updates only.
    [matched_filter_processing_chain.v]
2026-04-30 chirp-v2 PR-A: radar_params.vh additive macros for 3-ladder + escalation
    Establishes the macro vocabulary for the SHORT/MEDIUM/LONG waveform ladder,
    3-subframe Doppler layout, track-mode dwell, and 2-class CFAR detection.
    PR-A is purely additive — no module references the new macros yet.
    Subsequent PRs (B–H) progressively replace the old chirp logic; this one
    puts the names in place so each follow-on PR is mechanical.
    Added:
    - Waveform identity: RP_WAVE_{SHORT,MEDIUM,LONG,RESERVED} (2-bit selector)
    - Sub-frame layout: RP_NUM_SUBFRAMES=3, RP_DOPPLER_BIN_WIDTH=6,
    RP_SUBFRAME_ID_WIDTH=2
    - Track mode: RP_DOPPLER_FFT_SIZE_TRACK=64, RP_MODE_TRACK=2'b11,
    RP_DEF_TRACK_CHIRP_COUNT=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
2026-04-30 chirp-v2 PR-D: chirp_scheduler replaces radar_mode_controller; MF/MTI wave_sel-native
    Single 100 MHz scheduler emits wave_sel[1:0] and chirp_pulse natively. Modes
    00 (STM32 pass-through), 01 (auto-scan over SHORT/MEDIUM/LONG sub-frames),
    10 (single-chirp debug), 11 (track dwell with watchdog scan-fallback after
    RP_DEF_TRACK_WATCHDOG_FRAMES=5 idle frames). Sub-frame mask lets ops drop a
    waveform without recompiling.
    Drops the receiver_final wave_sel shim added in PR-C: wave_sel comes
    straight from the scheduler; chirp_pulse replaces the old mc_new_chirp
    toggle + XOR edge converter. matched_filter_multi_segment and mti_canceller
    take wave_sel[1:0] and chirp_pulse directly — no parallel path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
    [chirp_scheduler.v, matched_filter_multi_segment.v, mti_canceller.v, radar_receiver_final.v, radar_system_top.v, tb_mti_canceller.v, tb_multiseg_cosim.v, tb_radar_receiver_final.v]
2026-04-30 chirp-v2 PR-E: plfm_chirp_controller_v2 + scheduler-driven TX via async-FIFO
    Replaces plfm_chirp_controller_enhanced (5-state FSM with hardcoded
    LONG/SHORT timings + 60-entry inline short LUT) with plfm_chirp_controller_v2,
    a pure DAC playback driver: IDLE -> CHIRP -> IDLE keyed off a 1-cycle
    dst_chirp_valid pulse, with sample count selected by dst_wave_sel
    (SHORT=120 / MEDIUM=600 / LONG=3600). Inter-chirp timing (LISTEN, GUARD,
    frame boundaries) is now owned exclusively by chirp_scheduler.
    Scheduler -> TX bridge: cdc_async_fifo (Cummings style #2, WIDTH=2 DEPTH=4)
    crosses {wave_sel} from clk_100m to clk_120m_dac, with chirp_pulse as
    src_valid. frame_pulse rides a separate toggle CDC for ch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
    [chirp_scheduler.v, plfm_chirp_controller_v2.v, radar_receiver_final.v, radar_system_top.v, radar_transmitter.v, tb_chirp_contract.v, tb_chirp_controller.v, tb_radar_receiver_final.v]
2026-05-01 fix(regression): allow leading whitespace in [PASS]/[FAIL] anchors
    Three regex sites (run_test, run_mf_cosim, run_doppler_cosim) anchored
    at column 0 with `^\[PASS|^\[FAIL`, but most TBs emit ` [PASS]` /
    ` [FAIL]` from `task check;` formatting. Anchors silently matched
    zero markers, the fallback "did anything reach $finish" path
    reported PASS, and 48 real failures across tb_system_e2e (×2 modes),
    tb_fft_engine, and tb_fullchain_realdata went unnoticed across PR-D..G.
    Switch all three anchors to `^[[:space:]]*\[PASS|^[[:space:]]*\[FAIL`.
    No RTL change. Surfaces the truth — does not fix the underlying
    test failures (tracked separately as T-2..T-10 in PR-Tests-1 / PR-I).
2026-05-01 test(opcodes): PR-I.1 — tb_system_opcodes via production FT2232H path
    New TB instantiates radar_system_top with USB_MODE=1 and wires the
    FT2232H ports correctly (which tb_system_e2e never did — its BFM was
    FT601-only, so USB_MODE=1 opcode-dispatch tests were stimulating
    dangling ports). Uses the proven send_cmd pattern from
    tb_usb_protocol_v2.
    Coverage migrated from tb_system_e2e:
    - G6.1-6.6 — opcode 0x01/0x02/0x03/0x04/0x10/0x15 dispatch
    - G7.2/G7.4 — rapid USB cmd CDC integrity
    - G13.1-8 — chirps_per_elev clamp at DOPPLER_FRAME_CHIRPS=48 (PR-F-aware;
    was hardcoded to 32 in tb_system_e2e G13)
    - G14.1-13 — range_mode + CFAR opcode dispatch (0x20-0x25)
    Plus new PR-G coverage: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
    [tb_system_opcodes.v]
2026-05-01 test(integration): PR-I.4 — wire new TBs into regression, retire tb_system_e2e
    run_regression.sh replaces "System E2E (tb_system_e2e)" + "System E2E
    USB_MODE=1 (FT2232H)" with the three PR-I subsuites (tb_system_opcodes,
    tb_system_mechanics, tb_system_dataflow). SKIP count for --quick mode
    bumped 5 -> 6 to match. "System Top USB_MODE=1 (FT2232H)" via
    radar_system_tb.v is kept as a structural smoke test.
    Dataflow gets --timeout=600 (vs 300 default). Its 18 ms sim takes
    ~430-450 s wall on this host; the 300 s default killed it at ~12.4 ms,
    before the test logic block ran, yielding UNKNOWN. With 600 s, the TB
    finishes cleanly and G2.2/G4.1/G4.2 all pass (3/3). The
    matched_filter_multi_segmen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
    [tb_usb_protocol_v2.v]
2026-05-01 test(fft): PR-L — fix tb_fft_engine N=32→16 dropdown bugs (T-4)
    The TB hard-coded /32.0 in cosine/sine angle math and read out_re[28] /
    out_re[30] which don't exist for N=16, so 3/12 checks failed (Test 3
    single-tone, Test 7 imag-tone). Pure TB math error — fft_engine.v is
    correct (proven by every production MF/Doppler cosim passing bit-exact).
    Test 3: /32.0 → /N, peak expected = N/2*1000 = 8000 (not 16000),
    conjugate read at bin N-4=12 (not 28).
    Test 7: /32.0 → /N, conjugate peak at bin N-2=14 (not 30).
    Result: 12/12 PASS at N=16 with bin 4 = 7997 ≈ 8000.
    Closes T-4. Final regression: 42 passed / 0 failed of 42 — first
    all-green since PR-Tests-1 exposed hidden failu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
    [tb_fft_engine.v]
2026-05-01 fix(doppler): PR-M.2 — Dolph-Chebyshev 60 dB window replaces Hamming-ish LUT
    T-6 drift cosim (PR-M.1, c30be89) surfaced a 740-LSB / 2.3 % spec-vs-
    implementation gap in the Doppler window: doppler_processor.v lines
    99..114 and fpga_model.HAMMING_WINDOW were documented as sym Hamming
    N=16 (0.54 - 0.46*cos(2*pi*n/15)) but contained values that didn't
    match any standard window family. Existing Doppler cosim passed bit-
    exactly because both the RTL and the Python twin shared the identical
    non-canonical values.
    Quantifying the trade with scipy.signal across 11 candidates, the
    production LUT actually had peak sidelobes of -33 dB (vs canonical
    sym Hamming -40 dB) — the hand-tweaks made it 6.6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
    [doppler_golden_py_moving.csv, doppler_golden_py_stationary.csv, doppler_golden_py_two_targets.csv]
2026-05-01 ci(fpga): PR-M.3 — wire T-6 drift cosim into regression + CI deps
    Adds the T-6 independent reference drift cosim (PR-M.1, c30be89) as a
    gated regression check so any future hand-edit drift in NCO_SINE_LUT,
    fft_twiddle_*.mem, or DOPPLER_WINDOW_COEFF surfaces on every run.
    run_regression.sh: new "Independent Reference Drift (T-6)" check after
    the RX-B autocorrelation block in Phase 3. Plain `python3` (no path
    sniffing). Distinguishes three states from the script's exit code +
    markers:
    rc=0, PASS markers -> PASS (counts toward `passed`)
    rc=2, no markers -> SKIP (counts toward `skipped`)
    rc!=0, FAIL markers -> FAIL (gates the regression)
    compare_independent.py: detects missing nump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
    [compare_independent.py]
2026-05-01 fix(fpga): C-4 — replace IDDR DDR demux with negedge IFF for AD9484 SDR
    The AD9484 is SDR LVDS — datasheet p.5 lists "Output (LVDS—SDR)" as the
    only output mode and p.16 confirms "data outputs are valid on the rising
    edge of DCO." DCO runs at fs (400 MHz), one new sample per period, held
    stable across the period. There is no DDR mode and no SPI access (CSB is
    tied to +1V8 on the production board, RADAR_Main_Board.sch:46719).
    ad9484_interface_400m.v previously instantiated an IDDR per data bit and
    alternated Q1/Q2 via a `dco_phase` FSM, expecting to demux a "DDR" stream
    into 400 MSPS. Because the chip is SDR, both Q1 and Q2 represent the same
    sample, and the alternation produced approx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
    [ad9484_interface_400m.v, ad9484_interface_400m_stub.v, tb_ad9484_xsim.v, xc7a200t_fbg484.xdc]
2026-05-02 fix(fpga): PR-O — xFFT scaled mode + 32-bit MF chain widening
    Resolves AUDIT-C10 (xFFT scaling sim/silicon mismatch) by replacing the
    LogiCORE FFT v9.1 BFP setting with deterministic Scaled mode. Schedule
    [1,1,…,1] (= /N total) is encoded in radar_params.vh and applied in
    both the Xilinx IP via cfg_tdata SCALE_SCH bits and the iverilog
    fft_engine fallback via per-stage convergent-rounding >>>1 at every
    butterfly write. Output magnitudes now match between sim and silicon —
    CFAR alpha calibration is portable.
    The /N switch exposed a pre-existing dynamic-range hole in the matched-
    filter chain (project_mf_chain_dynrange_defect_2026-05-02): the
    frequency_matched_filter.v Q30→Q15 truncat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
    [compare_mf_chirp.csv, compare_mf_dc.csv, compare_mf_impulse.csv, compare_mf_tone5.csv, doppler_golden_py_moving.csv, doppler_golden_py_stationary.csv, doppler_golden_py_two_targets.csv, mf_golden_py_chirp.csv]
2026-05-02 fix(fpga): PR-O.8.1 — drop stale BFP-era ports, fix xsim include path
    Wrapper xfft_2048.v had m_axis_data_tuser and m_axis_status_{tdata,tvalid,
    tready} hooked up to the IP, but the regenerated xfft_2048_ip in scaled
    mode + Pipelined Streaming + 1 channel + no XK_INDEX/OVFLO doesn't expose
    those ports. xelab errored "cannot find port" on all four. Removed.
    run_xfft_xsim.sh missed -i "$PROJ_ROOT" so xvlog couldn't resolve
    `include "radar_params.vh"` from inside tb/. Fixed.
    gen_xfft_2048_ip.tcl header comment described the old Burst I/O 11-stage
    schedule; updated to PG109 Pipelined Streaming pair-grouped layout that
    matches the actual SCALE_SCH = 12'hAA9 we now drive.
    Verified: tb_xfft_20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
    [xfft_2048.v]
2026-05-02 test(fpga): xsim runner for tb_matched_filter_processing_chain
    Compiles + runs the MF chain TB under Vivado XSim with FFT_USE_XILINX_IP
    defined, exercising matched_filter_processing_chain →
    fft_engine_axi_bridge → xfft_2048 → real LogiCORE FFT v9.1 IP.
    Symlinks tb/ into the work dir so $readmemh("tb/mf_golden_*.hex")
    resolves from xsim's CWD.
    This validates the chain glue (FSM, BRAMs, conj-mult, sat-truncate) works
    correctly against the actual IP timing/scaling, not just the iverilog
    fft_engine.v fallback.
    Output: /tmp/mf_chain_xsim.log; xsim run takes ~40 min on the remote box.
2026-05-02 fix(fpga): PR-Q.1 — stagger MEDIUM PRI 175→161 µs for 3-PRI Doppler CRT (C-5)
    Bumps RP_DEF_MEDIUM_LISTEN_CYCLES 17000 → 15600 so MEDIUM PRI = 161 µs,
    distinct from SHORT (175 µs) and LONG (167 µs). Three coprime PRIs let
    the host run 3-PRI Chinese-Remainder unfolding on Doppler aliases beyond
    the per-sub-frame ±~41 m/s unambiguous range — closes the FPGA half of
    audit C-5 (PR-F Doppler ambiguity unfolding).
    Stagger choice (proposal B):
    SHORT 175 µs — chirp 1 + listen 174
    MEDIUM 161 µs — chirp 5 + listen 156 (PR-Q, was 175)
    LONG 167 µs — chirp 30 + listen 137
    In 3 km mode LONG is blind (4500 m blind zone) → SHORT-vs-MEDIUM
    (Δ=14 µs / 8 %) is the ope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
    [doppler_processor.v, radar_system_top.v, tb_radar_receiver_final.v]
2026-05-02 test(fpga): PR-Q.2 — align cosim T_PRI_MEDIUM 175->161 us + regen goldens
    Mirror the PR-Q.1 PRI stagger (MEDIUM 175 us -> 161 us) into the cosim
    scenario generator and regenerate all 12 affected golden hex/csv files.
    Without this, the Doppler co-sim TBs would diverge from the RTL on every
    MEDIUM sub-frame bin.
    - tb/cosim/radar_scene.py: T_PRI_MEDIUM = 161e-6
    - tb/cosim/gen_doppler_golden.py: comment update for MEDIUM bin map
    - 12 regenerated hex/csv files (doppler + real_data + fullchain_realdata)
    Regression: 42/0/1 (PR-Q.1 baseline preserved; T-6 SKIP is scipy-missing).
    [doppler_golden_py_moving.csv, doppler_golden_py_two_targets.csv]
2026-05-02 feat(gui): PR-Q.5 — 3-PRI CRT Doppler unfolder + cluster extractor (C-5)
    Add host-side 3-PRI Chinese-Remainder velocity unfolding and a cluster
    extractor that reads the 48-bin Doppler frame, splits it into the 3
    sub-frames (SHORT/MEDIUM/LONG), and resolves Doppler aliases across
    coprime PRIs. Resolves the algorithm half of audit C-5; the data is
    now in extract_targets_from_frame_crt's hands but workers still call
    the legacy single-PRI extractor (PR-Q.6 wires it).
    v7/processing.py:
    - unfold_velocity_crt(v_meas, v_unamb, v_res, max_alias_k=6,
    tol_factor=0.5) -> (v_est, confidence, alias_set). Brute-force
    candidate search over PRI-0 fold depth, per-PRI half-bin
    tolerance. Confidence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
    [models.py, processing.py]
2026-05-02 chore(repo): cosim_dir replay revival + ruff lint cleanup
    cosim_dir revival:
    - gen_realdata_hex.py: also emit decimated_range_{i,q}.npy (48x512)
    and doppler_map_{i,q}.npy (512x48) at production dimensions; the
    same Python pipeline that produces the RTL .hex stimuli now writes
    the .npy intermediates v7.replay COSIM_DIR loads. Replaces the
    workflow lost when golden_reference.py was deleted in e8b495c
    - test_v7.py: update test_get_frame_cosim shape from pre-PR-O.6
    (64,32) to (NUM_RANGE_BINS, NUM_DOPPLER_BINS)
    - check in 4 .npy reference files (~400 KB, deterministic SCENE_SEED=42)
    Ruff lint cleanup (was 66 errors; now 0):
    - pyproject.toml: ignore T20 in tb/cosim/**.py (CLI tools)
    - c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
    [compare_independent.py, dashboard.py, fpga_reference.py, processing.py, software_fpga.py]
2026-05-02 fix(gui): P-4 — dashboard NUM_RANGE_BINS 64 → 512 (import from radar_protocol)
    dashboard.py:77 had a stale `NUM_RANGE_BINS = 64` literal from pre-PR-F.
    Range-Doppler canvas was mis-sized: parser at radar_protocol.py:425
    already enforces 512, so production frames would never have rendered
    correctly even with P-2/P-3 in place.
    Fix: drop the local literals; re-export NUM_RANGE_BINS / NUM_DOPPLER_BINS
    through v7/hardware.py (which already re-exports the rest of
    radar_protocol) and import them in dashboard.py. Single source of truth.
    Also fixed two stale "(64x32)" docstrings: module-header tab description
    and `_on_frame_ready` docstring.
    Regression: 228/228 (test_v7 111 + test_GUI_V65_Tk 1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
    [dashboard.py, hardware.py]
2026-05-02 fix(mcu): P-5 — align radar params with PR-F/PR-Q.1; document mode-01 production stance
    main.cpp pre-PR-F constants caused two issues:
    - m_max = 32 disagreed with RP_CHIRPS_PER_FRAME = 48 (3 sub-frames * 16);
    getStatusString reported "32 chirps/position" to the GUI, false telemetry.
    - PRI MEDIUM = 161 us (PR-Q.1 stagger) was missing entirely; the MCU only
    knew SHORT=175 / LONG=167. T2 was also stuck at the pre-PR-E 0.5 us
    SHORT chirp width; PR-E switched to 1.0 us.
    Fixes:
    - m_max 32 -> 48; T2 0.5 -> 1.0; new T_MEDIUM=5.0, PRI_MEDIUM=161.0 constants.
    - Big doc-comment above runRadarPulseSequence states the production stance:
    FPGA cold-resets to mode 2'b01 (auto-scan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
    [main.cpp, test_bug16_runradar_shadows_globals.c]
2026-05-02 fix(gui): P-6 / PR-Q.6 — workers route detections through CRT extractor (C-5)
    Both live and replay paths used the legacy single-PRI extractor with the
    LONG-PRI v_res placeholder, which yielded wrong velocities for the SHORT
    and MEDIUM sub-frames. PR-Q.5 already provided extract_targets_from_frame_crt
    (48-bin, 3-PRI Chinese-Remainder-Theorem unfolding) — this PR wires it in.
    - workers.py imports extract_targets_from_frame_crt at module scope.
    - RadarDataWorker._run_host_dsp delegates to the CRT extractor and then
    applies GPS pitch correction + DBSCAN clustering + Kalman tracking
    on the returned targets. Inline det_indices loop and
    velocity_resolution_long_mps pla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
    [workers.py]
2026-05-02 feat(gui): PR-R — host control surface fill-in (audit M-2/M-3/M-4/M-6/M-7)
    The RTL has been ahead of the host opcode/widget surface since PR-G:
    several runtime knobs (MEDIUM PRI, soft-CFAR alpha, ADC power-down) are
    fully wired in radar_system_top.v but had no enum / spinbox path, so
    the operator could only reach them via raw _send_custom_command. This
    PR closes the gap for everything except M-5 (status-packet medium PRI
    readback, which needs an RTL change to add a status word).
    M-2 — Opcode enum gains MEDIUM_CHIRP=0x17, MEDIUM_LISTEN=0x18,
    CFAR_ALPHA_SOFT=0x2D. Truth-table docstring refreshed.
    Two new spinboxes in Waveform Timing ("Medium Chirp Cycles",
    "Medium Lis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
2026-05-02 feat(rtl,gui): PR-U / M-8 — sub-frame enable mask routed end-to-end (C-5 hardening)
    The chirp_scheduler had a 3-bit host_subframe_enable input {LONG, MEDIUM, SHORT}
    that was tied to the constant RP_DEF_SUBFRAME_ENABLE at the receiver instance,
    so the host could neither change it nor know what mask was active. With the
    mask not at 3'b111 the scheduler skips a sub-frame at TX but doppler_processor
    still writes 48 chirp slots, so the host CRT (`dbin // 16 → {SHORT, MED, LONG}`)
    silently mis-attributes the SF axis and unfolds to the wrong velocity.
    Plumb the mask through:
    - radar_system_top.v: new reg [2:0] host_subframe_enable, cold-reset
    RP_DEF_SUBFRAME_ENABLE, opcode 0x19 setter, wire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
    [dashboard.py, processing.py, radar_receiver_final.v, radar_system_top.v, software_fpga.py, tb_ft2232h_frame_drop.v, tb_usb_protocol_v2.v]
2026-05-20 MainBoard KiCad
    [RADAR_Main_Board.kicad_sch, RADAR_Main_Board_1.kicad_sch, RADAR_Main_Board_2.kicad_sch, RADAR_Main_Board_3.kicad_sch, RADAR_Main_Board_4.kicad_sch]
2026-05-20 patch antenna KiCad
    [Phased_Array_Ant.kicad_pcb, Phased_Array_Ant.kicad_sch]
2026-05-20 freqsynth board KiCad
    [Clocks_Freq_Synth_board.kicad_pcb, Clocks_Freq_Synth_board.kicad_sch]
2026-05-20 powerboard KiCad
    [PowerBoard.kicad_pcb, PowerBoard.kicad_sch]
2026-05-20 RF_PA KiCad
    [RF_PA.kicad_pcb, RF_PA.kicad_sch]
